Netithorn-P/Li-ion-Battery-cells-management-system/thesis final.pdf

การพัฒนาระบบปรับสมดุลของเซลล์แบบแอคทีฟเพื่อเพิ่มประสิทธิภาพการจัดการ แบตเตอรี่แพคชนิดลิเทียมไอออน An Improvement of Active Cell Balancing for Efficient Management in Li-ion Battery Pack

เนติธร ปรีชาพัฒนานนท์

ปริญญานิพนธ์นี้เป็นส่วนหนึ่งของการศึกษาตามหลักสูตร ปริญญาวิศวกรรมศาสตรบัณฑิต สาขาวิศวกรรมไฟฟ้า คณะวิศวกรรมศาสตร์
สถาบันเทคโนโลยี ไทย-ญี่ปุ่น พ.ศ. 2564

หัวข้อปริญญานิพนธ์ | การพัฒนาระบบปรับสมดุลของเซลล์แบบแอคทีฟเพื่อเพิ่ม
| ประสิทธิภาพการจัดการแบตเตอรี่แพคชนิดลิเทียมไอออน
โดย | นายเนติธร ปรีชาพัฒนานนท์
สาขาวิชา | วิศวกรรมไฟฟ้า
อาจารย์ที่ปรึกษาปริญญานิพนธ์ | ดร.ไพศาล สุดวิลัย

คณะกรรมการสอบ

| อาจารย์ที่ปรึกษา ประธานกรรมการสอบ
(ดร.ไพศาล สุดวิลัย)
| กรรมการสอบ
(รศ.ดร.ไตรสิทธิ์ เบญจบุณยสิทธิ์)
| กรรมการสอบ
(ผศ.ดร.อาทิตย์ ธรรมตระการ)
| กรรมการสอบ
(ดร.ชาตรี บุษบาธร)

ลิขสิทธิ์ของสถาบันเทคโนโลยีไทย – ญี่ปุ่น

ก

ชื่อโครงงาน | การพัฒนาระบบปรับสมดุลของเซลล์แบบแอคทีฟเพื่อเพิ่มประสิทธิภาพการ
| จัดการแบตเตอรี่แพคชนิดลิเทียมไอออน
ผู้เขียน | นายเนติธร ปรีชาพัฒนานนท์
อาจารย์ที่ปรึกษา | ดร.ไพศาล สุดวิลัย
หลักสูตร | วิศวกรรมศาสตร์บัณฑิต
สาขาวิชา | วิศวกรรมไฟฟ้า
พ.ศ. | 2564

บทสรุป

ธรรมชาติของเซลล์แบตเตอรี่ชนิดลิเทียมไอออนมีการคายประจุเองตลอดเวลาและในแต่ละเซลล์ นั้นก็มีความสามารถในการคายประจุไม่เท่ากันส่งผลให้เมื่อนำเซลล์แบตเตอรี่ชนิดลิเทียมไอออนมากกว่า หนึ่งเซลล์มาใช้งานร่วมกันอาจไม่มาสารถใช้งานได้เต็มประสิทธิภาพเนื่องจากประจุในแต่ละเซลล์ไม่เท่ากัน ดังนั้นการปรับสมดุลเซลล์แบตเตอรี่ให้เท่ากันก่อนนำไปใช้งานหรืออัดประจุจึงเป็นการเพิ่มประสิทธิภาพ การใช้งานของแบตเตอรี่
ปริญญานิพนธ์นี้จึงได้นำเสนอวิธีการปรับสมดุลเซลล์แบตเตอรี่ชนิดลิเทียมไอออนที่มีการต่อแบบ ขนาน 4 เซลล์ด้วยวิธีการเพิ่มแรงดันในการปรับสมดุลด้วยวงจรเพิ่มแรงดันที่มีข้อได้เปรียบเรื่องระยะเวลา ในการปรับสมดุลเซลล์แบตเตอรี่ที่มีความต่างของแรงดันน้อย โดยมีเงื่อนไขในการปรับสมดุลคือแรงดัน ของเซลล์ที่มีแรงดันมากที่สุดกับน้อยที่สุดต้องมีต่างกันไม่เกิน 10 mV พร้อมยังนำเสนอการป้องกันเซลล์ แบตเตอรี่ขณะปรับสมดุลจากสถานะผิดปกติของแบตเตอรี่ไม่ว่าจะเป็น แรงดันสูงเกิน แรงดันต่ำเกิน กระแสเกิน และ อุณหภูมิเกิน โดยการทำงานทั้งหมดนั้นได้รวมอยู่ในอุปกรณ์จัดการแบตเตอรี่ โดยได้ นำเสนอไมโครคอนโทรเลอร์รุ่น Arduino Mega 2560 ในการทำหน้าที่ควบคุมและประมวลผลการทำงาน ทั้งหมดของระบบ

คำสำคัญ : การปรับสมดุล/เพิ่มแรงดัน/แรงดันสูงเกิน/แรงดันต่ำเกิน/กระแสเกิน/อุณหภูมิเกิน

ข

Project’s name | An Improvement of Active Cell Balancing for Efficient
| Management in Li-ion Battery Pack
Authors | Netithorn Preechapattananont
Faculty Advisor | Dr.Phaisarn Sudwilai
Program | Bachelor of Engineering
Major | Electrical Engineering
Academic year | 2021

Abstract

Li-ion battery is naturally self-discharged which its capability is distinguish from one to another. This eventually affects to the usage of multiple cells together may not reach its best efficiency due to the inequality of each charge. Therefore, balancing battery cell prior to the usage or charging is considered as way to improve its efficiency. This thesis aims to propose “Balancing Battery Cells Methodology” for Li-ion that connected parallelly with 4 cells with increasing voltage for balancing by boost converter. The advantage of the boost converter is shorter period for balancing battery cells that consist of small different of voltage volume. And the balancing condition is the highest and lowest cell’s voltages are not varied more than 10 mV. In addition, this thesis also proposes prevention way while balancing process is in progress from various unusual status including too much high voltage, too low voltage, over current, and over temperature. The overall working model, system, and process are included in this battery management system with the proposal of micro controller - Arduino Mega 2560 model for the whole system processing and controlling.

Keywords : balancing/increasing voltage/over voltage/under voltage/over current/
over temperature

ค

กิตติกรรมประกาศ

ปริญญานิพนธ์ฉบับนี้ได้สำเร็จลุล่วงไปด้วยดีแม้จะมีปัญหาบ้างแต่ด้วยการที่ได้คำแนะนำและได้ ความช่วยเหลือจาก ดร.ไพศาล สุดวิลัย อาจารย์ที่ปรึกษาโครงงานของข้าพเจ้า ที่สละเวลาให้คำปรึกษา และความช่วยเหลือตลอดการดำเนินงานทำโครงงาน จนเป็นผลให้โครงงานสำเร็จลุล่วงไปได้ด้วยดี ขอขอบพระคุณอาจารย์คณะวิศวกรรมศาสตร์สาขาวิศวกรรมไฟฟ้าทุกท่านไม่ว่าจะเป็น ดร.ชาตรี บุษบาธร ผศ.ดร.อาทิตย์ ธรรมตระการ รศ.ดร.ไตรสิทธิ์ เบญจบุณยสิทธิ์อาจารย์ศิริพงษ์ แสงสารพันธ์ อาจารย์จิรดา โกสุมบงกช และ รศ.ดร.ชุมพล อันตรเสน ที่ให้ความรู้และคำแนะนำต่างๆแก่ข้าพเจ้า และ คอยสนับสนุนช่วยเหลือตลอดทั้งโครงงาน รวมไปถึงคณาจารย์จากคณะวิศวกรรมศาสตร์และ คณะอื่นๆ ที่ เคยอบรมสั่งสอนได้ให้ความรู้และอบรมสั่งสอนข้าพเจ้า ขอขอบคุณสถาบันเทคโนโลยีไทย-ญี่ปุ่น ที่อำนวย ความสะดวกในเรื่องสถานที่ อุปกรณ์ และ งบประมาณต่างๆในการจัดทำโครงงานให้แก้ข้าพเจ้า ท้ายที่สุดขอขอบพระคุณพ่อแม่และครอบครัวที่คอยสนับสนุนด้านการศึกษาให้แก่ข้าพเจ้า รวมทั้ง กำลังใจและความเชื่อมั่นในตัวข้าพเจ้า และเพื่อนๆ รวมถึงรุ่นพี่ที่คอยให้คำแนะนำและคำปรึกษาแก่ ข้าพเจ้าตลอดการศึกษาในระดับปริญญาศึกษา

เนติธร ปรีชาพัฒนานนท์
ผู้จัดทำ

ง

สารบัญ

หน้า

บทสรุป | ก
Summary | ข
กิตติกรรมประกาศ | ค
สารบัญ | ง
สารบัญตาราง | ช
สารบัญรูป | ซ
บทที่ 1 บทนำ | 1
1.1 ที่มาและความสำคัญของปัญหา | 1
1.2 วัตถุประสงค์ของโครงงาน | 2
1.3 ขอบเขตการศึกษา | 2
1.4 ประโยชน์ที่คาดว่าจะได้รับ | 2
1.5 แผนการดำเนินการ | 3
บทที่ 2 ทฤษฎีที่เกี่ยวข้อง | 4
2.1 ประเภทของแบตเตอรี่ | 4
2.2 แบตเตอรี่ชนิดลิเทียมไอออน | 6
2.3 แบบจำลองสมมูลแบตเตอรี่ชนิดลิเทียมไอออน | 8
2.3.1 แบบจำลองเทวินิน (Thevenin Model) | 8
2.3.2 แบบจำลองเทวินินแบบปรับปรุง (Improved Thevenin Model) | 9
2.4 วิธีการปรับสมดุลเซลล์แบตเตอรี่ | 10
2.4.1 การปรับสมดุลแบบพาสซีฟ (Passive balancing) | 10
2.4.2 การปรับสมดุลแบบแอคทีฟ (Active balancing) | 11
2.4.3 การปรับสมดุลแบบ Lossless balancing | 14

จ

2.4.4 การปรับสมดุลแบบ Redox Shuttle | 15
2.5 หลักการอัดประจุแบตเตอรี่ | 15
2.6 Stage of Charge , Depth of Discharge และ C-rate | 16
2.6.1 Stage of Charge (SoC) | 16
2.6.2 Depth of Discharge (DoD) | 17
2.6.3 C-rate | 18
บทที่ 3 ขั้นตอนและวิธีการดำเนินงาน | 19
3.1 ทำการเก็บผลเพื่อออกแบบ | 19
3.2 ออกแบบวงจรจัดการแบตเตอรี่แพค | 22
3.2.1 สถาปัตยกรรมของระบบขัดการแบตเตอรี่แพค | 22
3.2.2 การทำงานของระบบจัดการแบตเตอรี่ชนิดลิเทียมไอออน | 23
3.3 ออกแบบหลักการทำงานของระบบปรับสมดุลของระบบจัดการแบตเตอรี่ | 29
3.4 การตรวจวัดสัญญาณ | 33
3.4.1 การตรวจวัดสัญญาณแรงดันไฟฟ้า | 33
3.4.2 การตรวจวัดสัญญาณกระแสไฟฟ้า | 33
3.4.3 การตรวจวัดสัญญาณอุณหภูมิ | 34
3.5 ออกแบบวงจรป้องกันแบตเตอรี่แพ็ค | 35
บทที่ 4 ขั้นตอนและวิธีการดำเนินงาน | 36
4.1 การทดสอบปรับสมดุลโดยการเพิ่มแรงดันในการรับสมดุล | 36
4.1.1 เงื่อนไขการปรับสมดุลด้วยแรงดันปรับสมดุล 4.20 Volt | 36
4.1.2 เงื่อนไขการปรับสมดุลด้วยแรงดันปรับสมดุล 4.25 Volt | 37
4.1.3 เงื่อนไขการปรับสมดุลด้วยแรงดันปรับสมดุล 4.38 Volt | 38
4.2 การทดสอบปรับสมดุลเซลล์แบตเตอรี่ที่มีแรงดันต่างกันมาก | 39
4.3 การทดสอบระบบควบคุมการทำงานของระบบจัดการแบตเตอรี่ | 41

ฉ

4.4 การทดสอบระบบป้องกันเซลล์แบตเตอรี่ | 44
4.5 การทดสอบการดำเนินการทำงานของระบบ | 48
4.6 ผลการทดสอบการดำเนินการปรับปรุงระบบปรับสมดุล | 49
บทที่ 5 บทสรุปและข้อเสนอแนะ | 50
5.1 สรุปผลการดำเนินงาน | 50
5.2 แนวทางการแก้ไขปัญหา | 50
5.3 ข้อเสนอแนะจากการดำเนินงาน | 51
เอกสารอ้างอิง | 52
ภาคผนวก ก | 54
ภาคผนวก ข | 55
ภาคผนวก ค | 58
ภาคผนวก ง | 60
ภาคผนวก จ | 62
ภาคผนวก ฉ | 68
ภาคผนวก ช | 71
ภาคผนวก ญ | 72
ประวัติผู้จัดทำโครงงาน | 74

ช

สารบัญตาราง

ตารางที่ | หน้า

ตารางที่ 2.1 ตารางแสดงถึงความสัมพันธ์ระหว่าง C-rate ความจุและ ระยะเวลา ของแบตเตอรี่ 18
ตารางที 4.1 ตารางแรงดันก่อนปรับสมดุลและหลังปรับสมดุลด้วยแรงดัน 4.20 Volt | 35
ตารางที 4.2 ตารางแรงดันก่อนปรับสมดุลและหลังปรับสมดุลด้วยแรงดัน 4.25 Volt | 36
ตารางที 4.3 ตารางแรงดันก่อนปรับสมดุลและหลังปรับสมดุลด้วยแรงดัน 4.38 Volt | 37
ตารางที 4.4 ตารางแรงดันก่อนปรับสมดุลและหลังปรับสมดุลเซลล์แบตเตอรี่ที่มี | 39
แรงดันต่างกันมากด้วยแรงดัน 4.25 Volt ตารางที่ 4.5 การเปรียบเทียบวิธีการปรับสมดุลระหว่าง Flying capacitor และ Buck-Boost 49 converter

ซ

สารบัญรูป

ภาพที่ | | หน้า
2.1 | แบบจำลองเทวินินของแบตเตอรี่ชนิดลิเทียมไอออน | 8
2.2 | การปรับปรุงแบบจำลองเทวินินของแบตเตอรี่ชนิดลิเทียมไอออน | 9
2.3 | Fixed shunting resistor | 10
2.4 | Switching shunting resistor | 11
2.5 | Switching capacitor | 12
2.6 | Buck-Boost converter method | 13
2.7 | Multi-winding transformer | 14
2.8 | Metrix switch circuit | 14
2.9 | โหมดการชาร์จกระแสคงที่ และ แรงดันคงที่ | 16
2.10 ภาพอธิบายความหายของ SOC เมื่ออ้างอิงกับความจุของแบตเตอรี่ | 16
2.11 ภาพอธิบายความหมายของ DOD โดยเทียบระหว่างแรงดันและเวลา | 17
2.12 ภาพอธิบายความหมายของ SOC และ DOD เมื่ออ้างอิงกับความจุของแบตเตอรี่ | 18
3.1 | กราฟแสดงแรงดันของเซลล์แบตเตอรี่ชนิดลิเทียมไอออนด้วยระบบปรับสมดุลแบบ Flying
| Capacitor | 20
3.2 | กราฟแสดงแรงดันของเซลล์แบตเตอรี่ชนิดลิเทียมไอออนด้วยระบบปรับสมดุลแบบ Buck-Boost
| converter | 21
3.3 | สถาปัตยกรรมการจัดการแบตเตอรี่ชนิดลิเทียมไอออนที่ต่อขนานจำนวน 4 เซลล์ | 23
3.4 | แผนภาพการเริ่มต้นการทำงานของระบบจัดการแบตเตอรี่ | 23
3.5 | แผนภาพการเริ่มต้นการทำงานของระบบจัดการแบตเตอรี่ | 23
3.6 | แผนภาพการตรวจเช็คสถานะคำสั่งหลักและเข้าสู่คำสั่งของระบบจัดการแบตเตอรี่ | 24
3.7 | แผนภาพหน้าหลักของระบบจัดการแบตเตอรี่ | 24
3.8 | แผนภาพการทำงานเบื้องหลังในการ delay ของระบบจัดการแบตเตอรี่ | 25
3.9 | แผนภาพการทำงานการัดจังหวะของสวิตช์1 และ 2 ของระบบจัดการแบตเตอรี่ | 26
3.10 แผนภาพการทำงานการขัดจังหวะของสวิตช์3 และ 4 ของระบบจัดการแบตเตอรี่ | 27
3.11 โมดูลแปลงแรงดันไฟฟ้าที่ใช้Regulator เบอร์ LN2587 | 28

ฌ

สารบัญรูป (ต่อ)

รูปที่ | | หน้า
3.12 พฤติกรรมของพลังงานที่สูญเสียในเซลล์แบตเตอรี่ขณะถ่ายโอนพลังงานในรูปแบบต่างๆ | 28
3.13 แผนภาพการทำงานของการคำนวณและจับคู่เซลล์ที่จะทำการปรับสมดุล | 29
3.14 แผนภาพการทำงานของการปรับสมดุลเซลล์แบตเตอรี่ | 30
3.15 แผนภาพการทำงานของการปรับสมดุลเซลล์แบตเตอรี่ (ต่อ) | 31
3.16 การต่อวงจรเพื่อวัดแรงดันของเซลล์แบตเตอรี่โดยมีการต่อ
| pull-down resistor ขนาด 10 kΩ | 32
3.17 การต่อวงจรเพื่อวัดสัญญาณกระแสไฟฟ้าและเปลี่ยนเป็นสัญญาณแรงดันโดยใช้ไอซีเบอร์
| ACS712 | 33
3.18 ไอซีวัดแรงดันเบอร์ LM35 | 33
3.19 Datasheet บอกคุณสมบัติเบื่องต้นของแบตเตอรี่รุ่น Toriyama ICR18650-22 | 34
4.1 | ปรับสมดุลเป็นเวลา 4 ชั่วโมงด้วยแรงดันขนาด 4.20 Volt | 35
4.2 | ปรับสมดุลเป็นเวลา 4 ชั่วโมงด้วยแรงดันขนาด 4.25 Volt | 36
4.3 | ปรับสมดุลเป็นเวลา 4 ชั่วโมงด้วยแรงดันขนาด 4.38 Volt | 37
4.4 | ปรับสมดุลเซลล์แบตเตอรี่ที่มีแรงดันต่างกันมากด้วยแรงดันด้วยแรงดันขนาด 4.25 Volt | 38
4.5 | แผนภาพหน้าการดำเนินการทำงานของระบบจัดการแบตเตอรี่ | 40
4.6 | หน้าจอ LCD การดำเนินการทำงานของระบบจัดการแบตเตอรี่ | 40
4.7 | แผนภาพหน้าการแสดงสถานะต่างๆของเซลล์แบตเตอรี่และของระบบจัดการแบตเตอรี่ | 41
4.8 | หน้าจอ LCD การแสดงสถานะต่างๆของเซลล์แบตเตอรี่และของระบบจัดการแบตเตอรี่ | 41
4.9 | แผนภาพหน้าการปรับแต่งคุณสมบัติต่างๆของระบบจัดการแบตเตอรี่ | 42
4.10 หน้าจอ LCD การปรับแต่งคุณสมบัติต่างๆของระบบจัดการแบตเตอรี่ | 42
4.11 แผนภาพหน้าการวัดค่าแรงดันและประมวลผลสำหรับป้องกันเซลล์ของระบบ
| จัดการแบตเตอรี่ | 43
4.12 แผนภาพหน้าการวัดค่ากระแสและประมวลผลสำหรับป้องกันเซลล์ของระบบ
| จัดการแบตเตอรี่ | 44
4.13 แผนภาพหน้าการวัดค่าอุณหภูมิและประมวลผลสำหรับป้องกันเซลล์ของระบบ
| จัดการแบตเตอรี่ | 44

ฌ

4.14 แผนภาพการแสดงผลเมื่อสามารถตรวจจับความผิดปกติของเซลล์แบตเตอรี่ของระบบ
| จัดการแบตเตอรี่ | 45
4.15 หน้าจอ LCD การแสดงผลเมื่อสามารถตรวจจับสถานะ Over Current ในระบบเมื่อมีการทำการ
| Balance และ Discharge | 45
4.16 หน้าจอ LCD การแสดงผลเมื่อสามารถตรวจจับสถานะ Over Voltage ในระบบที่เซลล์ 1,2,3,4
| และ 1,3 | 46
4.17 หน้าจอ LCD การแสดงผลเมื่อสามารถตรวจจับสถานะ Under Voltage ในระบบที่เซลล์ 1,2,3,4
| และ 2,4 | 46
4.18 หน้าจอ LCD การแสดงผลเมื่อสามารถตรวจจับสถานะ Over Temperature ในระบบที่เซลล์
| 1,2,3,4 และ 1,2 | 46
4.19 หน้าจอ LCD การแสดงผลเมื่อระบบดำเนินการ Discharge และพบเซลล์ที่มีแรงดัน 0 Volt 46 4.20 หน้าจอ LCD การแสดงผลเมื่อระบบดำเนินการ Balance และพบเซลล์ที่มีแรงดัน 0 Volt 47
4.21 หน้าจอ LCD การแสดงผลเมื่อระบบดำเนินการ Discharge | 47
4.22 หน้าจอ LCD การแสดงผลเมื่อระบบดำเนินการ Balance | 47
ก.1 | รูปลักษณ์ภายนอกของระบบจัดการแบตเตอรี่ในส่วนของการทำงานเบื้องหลัง | 52
ก.2 | รูปลักษณ์ภายนอกของระบบจัดการแบตเตอรี่ในส่วนของการทำงานเบื้องหน้า | 52

บทที่1
บทนำ

### 1.1 ที่มาและความสำคัญของปัญหา

จากจุดเริ่มต้นมนุษย์ได้พัฒนาเทคโนโลยีเสมอมาเพื่อใช้ในการอำนวยความสะดวกโดยมีเป้าหมาย เพื่อตนเองเป็นหลัก โดยในยุคปฏิวัติอุตสาหกรรมที่เมื่อก่อนการผลิตสินค้าเดิมใช้แรงงานคน แรงงานสัตว์ รวมทั้งพลังงานจากธรรมชาติ ได้ปรับเปลี่ยนมาใช้เครื่องจักรกลแทน เพื่อทุ่นแรงและเพิ่มความสามารถใน การผลิต โดยในเริ่มแรกจะใช้พลังงานจากการใช้น้ำมาหมุนกังหันและได้พัฒนาต่อมาเป็นเครื่องยนต์ที่ใช้ แหล่งพลังงานชนิดต่างๆ ไม่ว่าจะเป็นถ่านหินไปจนถึงน้ำมันปิโตรเลียม จนการใช้เครื่องยนต์เป็นต้นกำลัง นั้นเริ่มแพร่หลายมากขึ้น จึงทำให้อุปกรณ์ต่างๆที่ถูกพัฒนาในเวลานั้นมีต้นกำลังมาจากเครื่องยนต์รวมไป ถึงยานพหนะ
ณ ปัจจุบันมนุษย์นั้นเริ่มตระหนักถึงสิ่งแวดล้อมมากขึ้นเรื่อยๆจึงได้พัฒนายานพหนะที่ใช้ต้นกำลัง มาจากไฟฟ้า และ เนื่องจากยานพหนะนั้นถูกสร้างขึ้นมาเพื่อใช้ประโยชน์ในการเดินทางระยะใกลทำให้ไม่ สามารถที่จะใช้แหล่งพลังงานผ่านทางสายไฟได้จึงมีการพัฒนาวิธีการจัดเก็บพลังงานไฟฟ้าไว้ในแบตเตอรี่ และออกแบบระบบจัดเก็บพลังงานให้เหมาสมกับพฤติกรรมการใช้งานและสภาพแวดล้อมของระบบ อย่างเช่นในรถยนต์จากข้อได้เปรียบของรถยนต์ประเภทเครื่องยนต์สันดาปภายในที่ใช้แหล่งพลังงานมา จากผลิตภัณฑ์ปิโตรเลียมคือ การเติมเชื่อเพลิงที่รวดเร็ว จึงนำมาสู่การปรับปรุงระบบแหล่งเก็บพลังงาน ของรถยนต์พลังงานไฟฟ้าที่ต้องการการเติมพลังงานที่รวดเร็วไกล้เคียงกับรถยนต์สันดาปภายในมากขึ้นจึง ได้พัฒนาวิธีการในการอัดประจุแบตเตอร์รี่แบบต่างๆเพื่อเพิ่มความเร็วในการอัดประจุให้มากขึ้นเพื่อลดข้อ เสียเปรียบในด้านนี้ให้น้อยลงจนหมดไป

### 1.2 วัตถุประสงค์ของโครงงาน

1.2.1 เพื่อศึกษาถึงคุณสมบัติและข้อจำกัดรวมไปถึงการทำงานของแบตเตอรี่ชนิดลิเทียม ไอออน

1.2.2 เพื่อศึกษาวิธีการที่จะใช้งานแบตเตอรี่ชนิดลิเธียมไอออนได้อย่างมีประสิทธิภาพ
1.2.3 เพื่อศึกษาและออกแบบระบบจัดการและปรับสมดุลให้กับแบตเตอรี่ชนิดลิเทียมไอออน 1.2.4 เพื่อศึกษาปัญหาและแก้ไขปัญหาที่เกิดขึ้นกับแบตเตอรี่ชนิดลิเทียมไอออนขณะปรับ สมดุลเพื่อพัฒนาขีดความสามารถของระบบจัดการแบตเตอรี่

### 1.3 ขอบเขตการศึกษา

1.3.1 ออกแบบอุปกรณ์และประดิษฐ์ระบบจัดการและปรับสมดุลแบตเตอรี่ชนิดลิเทียมไอออน แบบ Active
1.3.2 ออกแบบ Algorithm ในการปรับสมดุแบบ Activeระหว่างเซลล์แบตเตอรี่ที่ต่อขนาน 4 เซลล์ของจัดการแบตเตอรี่ชนิดลิเทียมไอออน

### 1.4 ประโยชน์ที่คาดว่าจะได้รับ

1.4.1 ทักษะในการออกแบบและวิเคราะห์วงจรที่ซับซ้อนมากขึ้น
1.4.2 ทักษะในการออกแบบ Algorithm ในการควบคุมการทำงานของระบบผ่าน Microcontroller
1.4.3 ได้นำความรู้ที่เคยศึกษามาและความรู้ที่ได้ศึกษาเพิ่มเติมมาประยุกต์ใช้ในการออกแบบ อุปกรณ์ที่สามารถใช้งานได้จริง

### 1.5 แผนการดำเนินการ

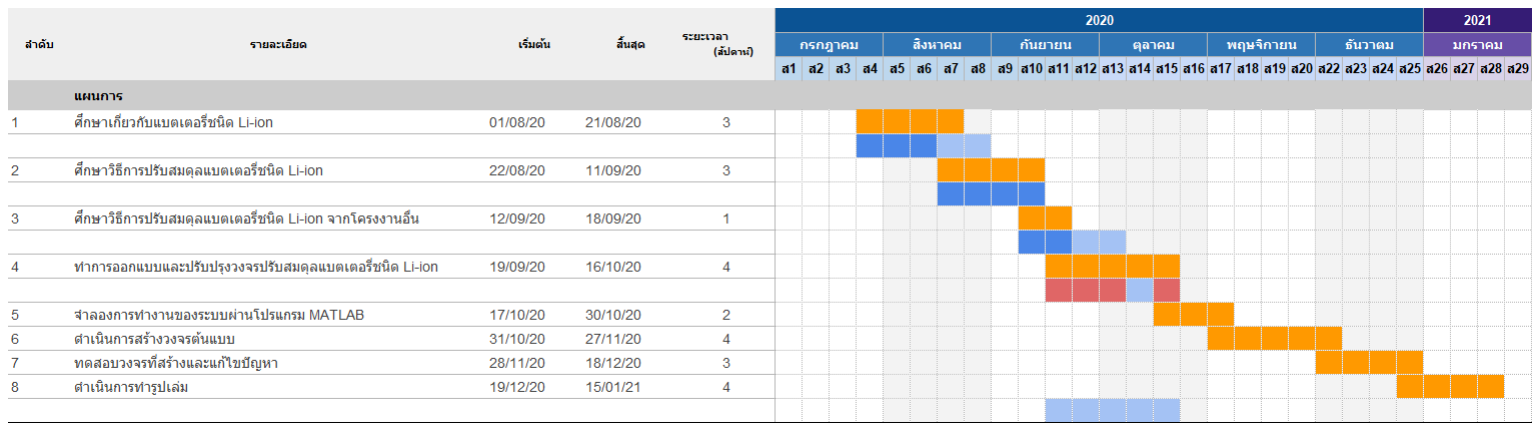
[picture p1: figure]

บทที่2
ทฤษฏีที่เกี่ยวข้อง

### 2.1 ประเภทของแบตเตอรี่ [1] [2]

แบตเตอรี่หรือถ่านนั้นเป็นอุปกรณที่ใช้ในการเก็บพลังงานไฟฟ้าในรูปแบบของปฏิกริยาทางเคมี โดยสามารถแบ่งออกได้เป็น 2 ประเภทใหญ่ๆ คือ เซลล์ปฐมภูมิ (Primary Cells) และ เซลล์ทุติยภูมิ (Secondary Cells) โดยมีข้อแตกต่างคือ เซลล์ปฐมภูมิ (Primary Cells) เป็นเซลล์แบตเตอรี่ที่ถูกสร้างมา จากวัสดุทางเคมีที่คุณสมบัติแบบ Non-reversable chemical reaction จึงไม่สามารถจ่ายแรงดันกลับ เพื่ออัดประจุคืนให้แบตเตอรี่มีโครงสร้างทางเคมีเหมือนเดิมได้แต่ใน เซลล์ทุติยภูมิ (Secondary Cells) จะเป็นเซลล์แบตเตอรี่ที่ถูกสร้างมาจากวัสดุทางเคมีที่คุณสมบัติแบบ Reversable chemical reaction จึงสามารถจ่ายแรงดันกลับเพื่ออัดประจุคืนให้แบตเตอรี่มีโครงสร้างทางเคมีเหมือนเดิมได้ซึ่งการใช้งาน ของแบตเตอรี่ทั้งสองชนิดนั้นแตกต่างกันเนื่องจากคุณสมบัตเฉพาะตัวแยกย่อยต่างๆของแบตเตอรี่ทั้งสอง ชนิด เช่น ถ่านอัลคาไลน์ ถ่านลิเธียม ที่เป็น แบตเตอรี่ชนิด Primary Cells นั้นมีหลายขนาดนิยมใช้ใน ใช้ ในวิทยุ นาฬิกา เก็บพลังงานได้สูง อายุการใช้งานสูง แต่เมื่อถูกใช้หมดจะกลายเป็นขยะมลพิษ ถ่านไฟฉาย แบบอัลคาไลน์ที่ใช้แล้วทิ้งนั้นเป็นที่นิยมกันมาก แต่ในระยะหลังนี้ถ่านไฟฉายอีกประเภทหนึ่งที่ได้รับความ นิยมเพิ่มมากขึ้นคือถ่านลิเธียม ซึ่งมีนํ้าหนักเบา ให้พลังงานสูง ใช้ได้ดีในที่อากาศเย็นและสามารถเก็บไว้ได้ นาน นอกจากนี้ ในปัจจุบันผู้ผลิตยังได้ผลิตถ่านลิเธียมในขนาด AA ออกมาอีกด้วย แต่ในอุปกรณ์ที่มีอัตรา ในการบริโภคพลังงานสูงขึ้นมาและมีอายุการใช้งานนานจะนิยมใช้เป็นแบตเตอรี่ชนิด Secondary Cells เนื่องจากความคุ้มค่าทางเศรษฐศาสตร์และความสะดวกสะบายโดยนิยมใช้เป็น แบตเตอรี่รถยนต์ แบตเตอรี่มือถือ เป็นต้น แบตเตอรี่ชนิด Secondary Cells ที่เก่าแก่ที่สุดซึ่งใช้อยู่จนกระทั่งปัจจุบันคือ "เซลล์เปียก"แบตเตอรี่ตะกั่ว-กรด (lead-acid battery) แบตเตอรี่ชนิดนี้จะบรรจุในภาชนะที่ไม่ได้ปิดผนึก (unsealed container) ซึ่งแบตเตอรี่จะต้องอยู่ในตำแหน่งตั้งตลอดเวลาและต้องเป็นพื้นที่ที่ระบายอากาศ ได้เป็นอย่างดีเพื่อระบายก๊าซไอโดรเจนที่เกิดจากปฏิกิริยาและแบตเตอรี่ชนิดจะมีนํ้าหนักมากรูปแบบ สามัญของแบตเตอรี่ตะกั่ว-กรด คือแบตเตอรี่รถยนต์ ซึ่งสามารถจะให้กระแสไฟฟ้าได้ถึงประมาณ 10,000 วัตต์ในช่วงเวลาสั้นๆ และมีกระแสตั้งแต่ 450 ถึง 1100 แอมแปร์สารละลายอิเล็กโตรไลต์ของแบตเตอรี่

คือ กรดซัลฟิวริกซึ่งสามารถเป็นอันตรายต่อผิวหนังและตาได้ แบตเตอรี่ตะกั่ว-กรดที่มีราคาแพงมาก เรียกว่า แบตเตอรี่เจล (หรือ "เจล-เซลล์") ภายในจะบรรจุอิเล็กโตรไลต์ประเภทเซมิ-โซลิด (semi-solid electrolyte) ที่ป้องกันการหกได้ดี และแบตเตอรี่ชนิด Secondary Cells ที่เคลื่อนย้ายได้สะดวกกว่าคือ ประเภท "เซลล์แห้ง" เช่น แบตเตอรี่ชนิดนิกเกิล-แคดเมียม (NiCd) แบตเตอรี่ชนิดโซเดียม-ซัลเฟอร์ (NaS) แบตเตอรี่ชนิดซิงค์-โบรมีน (ZnBr) และ แบตเตอรี่ชนิดวาเนเดียม-รีด็อก (Vanadium-Redox) เป็นต้น ใน อดีตที่ผ่านมาจนถึงปัจจุบันในรถยนต์ไฟฟ้านั้นได้ใช้แบตเตอรี่ประเภท Secondary Cells เป็นพลังงาน หลักมาโดยตลอดโดยชนิดของแบตเตอรี่ที่ใช้นั้นได้ปรับเปลี่ยนตามเทคโนโลยีของยุคสมัยนั้นและการใช้ งาน เช่น

- Lead-Acid Battery ที่นิยมใช้ในรถประเภท Fork-lift เนื่องจากมีน้ำหนักที่มากเหมาะแก่การถ่วง น้ำหนักตัวรถเพื่อสมดุลของตัวรถในขณะยกของ
- Sodium-Nickel Chloride or Zebra (Molten-salt Battery) ใช้ในรถ Modec commercial vehicle แต่ในปัจจุบันเลิกใช้ไปแล้วเนื่องจากความยุ่งยากในการใช้งานที่จะต้องทำการให้ความร้อนแก้ electrolyte ก่อนเพื่อให้เปลี่ยนสถานะของ electrolyte เป็นของเหลวเพื่อใช้งาน
- NiMH Battery (Nickel Metal Hydride) ใช้ในรถยนต์ส่วนบุคคลในช่วงแรกๆของรถยนต์ไฟฟ้า เนื่องด้วยความสามารถในการเก็บพลังงานที่สูงเมื่อเทียบกับน้ำหนักและประมาตร มีความปลอดภัยในการ ใช้งาน ในยุคสมัยนั้น แต่ในปัจจุบันมีความนิยมน้อยลงเนื่องการการพัฒนาของเทคโนโลยีทำให้เกิด แบตเตอรี่ชนิดใหม่ที่เหมาะสมในการใช้งานมากกว่า
- Li-ion Battery (Lithium ion) นิยมใช้ในรถยนต์ส่วนบุคคลในปัจจุบันเนื่องจากมีความเหมาะสม มากที่สุดในเวลานี้ทั้งในเรื่องของเศรษฐศาสตร์และคุณสมบัติเฉพาะตัวของแบตเตอรี่ที่มีอายุการใช้งานสูง ความสามารถในการเก็บพลังงานที่สูงเมื่อเทียบกับน้ำหนักและประมาตร มากกว่าแบตเตอรี่ชนิด Nickel Metal Hydride และได้ถูกพัฒนาให้มีความปลอดภัยในการใช้งานแล้ว

### 2.2 แบตเตอรี่ชนิดลิเทียมไอออน [2] [3] [4]

แบตเตอรี่ลิเธียมไอออน (Lithium-Ion Battery) หรือ Li-Ion battery เป็นแบตเตอรี่คุณภาพสูง ชนิดที่สามารถนำกลับมาใช้ใหม่ (Rechargeable Battery) หรือใช้ซ้ำได้ เริ่มใช้กันมาตั้งแต่ปี ค.ศ. 1970 (พ.ศ. 2513) จุดเริ่มต้นจากวิจัยในช่วงปี ค.ศ. 1970 ขณะนั้นเป็นแบตเตอรี่ชนิดใช้ครั้งเดียวแล้วทิ้ง ลิ เธียมมีคุณสมบัติที่เด่นคือ เป็นโลหะที่เบา ให้แรงดันไฟฟ้าสูง และยังมีความหนาแน่นของพลังงานสูงและ กำลังไฟฟ้าสูงในนํ้าหนักที่เท่ากันปัญหาของโลหะลิเธียม (Lithium Metal) ในระยะแรกคือ เรื่องของความ ปลอดภัยกล่าวคือ ในระหว่างอัดประจุไฟมีแนวโน้มที่จะเกิดความไม่เสถียรทำให้ระเบิดได้ง่ายงานวิจัยใน ระยะต่อมาจึงได้มีการทดลองเปลี่ยนจากการใช้ลิเธียมในรูปของโลหะมาเป็นรูปของไอออน (Lithium-ion) ซึ่งมีความปลอดภัยมากกว่า มากถึงแม้จะให้พลังงานที่น้อยกว่า โดยในปัจจุบันมีใช้กันอย่างแพร่หลายใน เครื่องใช้ไฟฟ้า ที่ไม่ต้องการต่อสายเพื่อจ่ายพลังงานอยู่ตลอดเวลา เช่น หุ่นยนต์ดูดฝุ่น หุ่นยนต์เช็ดกระจก หุ่นยนต์ตัดหญ้า หรือแม้แต่โทรศัพท์มือถือ แท็บเล็ต คอมพิวเตอร์โน๊ตบุ๊ค แบตเตอรี่สำรอง (Power Bank) และ ใช้เพื่อสำรองไฟกรณีไฟจากแหล่งจ่ายปกติไม่สามารถจ่ายไฟได้สำหรับคุณสมบัติหลักของ แบตเตอรี่ลิเธียมไอออน คือ แรงดันต่อเซลล์สูง และ ค่อนข้างคงที่ แม้แบตเตอรี่ใกล้หมด และ ยังมี ระยะเวลาการอัดประจุไฟจนเต็มความจุที่เร็วกว่าแบตเตอรี่แบบอื่นๆเนื่องจากความสามารถในการทน กระแสสูง และ มีอายุการใช้งานที่นาน อายุการใช้งานของแบตเตอรี่ลิเธียมไอออน ในระยะที่เต็ม ประสิทธิภาพ จะอยู่ระหว่าง 2-3 ปี ขึ้นอยู่กับพฤติกรรมและปริมาณการใช้งานของผู้ใช้รวมไปถึงการดูแล รักษา โดยการดูแลรักษานั้นควรคำนึงถึง การเก็บแบตเตอรี่ หรืออุปกรณ์ที่ใช้แบตเตอรี่ชนิดนี้ให้อยู่ภายใน อุณหภูมิ และความชื้นที่เหมาะสม หลีกเลี่ยงการอัดประจุไฟภายใต้อุณหภูมิที่สูง (เพราะจะยิ่งทำให้ แบตเตอรี่เสื่อมเร็วขึ้น) อย่าใช้งานจนแบตเตอรี่หมดเกลี้ยง (Depth Of Discharge = 0 %) หรือเหลือ น้อยมากๆ ควรหมั่นอัดประจุให้มีไฟเลี้ยงตัวแบตเตอรี่อยู่เสมอ หากไมจำเป็นไม่ควรอัดประจุด้วยกระแสที่ สูงมากเนื่องจากจะทำให้แบตเตอรี่เสื่อมสภาพเร็วขึ้นจากปรากฏการณ์Dendrite ที่จะเกิดขึ้นภายใน แบตเตอรี่ภายใต้การอัดประจุด้วยกระแสที่สูง แบตเตอรี่ชนิดลิเธียมไอออนมีการป้องกันที่สูงเพื่อให้เกิด ความปลอดภัยในการใช้งาน ซึ่งจะมีวงจรป้องกันประกอบอยู่ภายในแบตเตอรี่ ซึ่งมีวงจรตรวจจับแรงดัน และกระแสโดยใช้ Metal Oxide Semiconductor Field Effect Transistor (MOSFET) กำลังสูงแต่มี ขนาดเล็กทำหน้าที่เป็นสวิตช์ทำหน้าที่ตัดวงจรออกเมื่อแรงดันของแบตเตอรี่สูงเกินประมาณ 4.25V

และทำหน้าที่ป้องกันไม่ให้แรงดันของแบตเตอรี่ตํ่าเกินประมาณ 3.00 V วงจรควบคุมจะตัดวงจรออกทำให้ แบตเตอรี่ไม่สามารถจ่ายกระแสได้อีก โดย

จุดเด่นของแบตเตอรี่ชนิดนี้คือ

- แรงดันต่อเซลล์สูง ประมาณ 3.6 V
- Self-Discharge rate ต่ำ น้อยกว่า 10% ต่อเดือน
- อายุการใช้งานยาวนานเมื่อเทียบกับแบตเตอรี่ชนิดอื่น
- สามารถจ่ายกระแสได้สูง ประมาณ 10C
- สามารถอัดประจุคืนได้เร็วเฉลี่ยประมาณ 1-2 ชั่วโมง
- Energy Density สูง ประมาณ 110 W • h/kg
- ไม่ต้องการการบำรุงรักษา
- ความเป็นพิษน้อย

จุดด้อยของแบตเตอรี่ชนิดนี้คือ

- ราคาค่อนข้างสูงเมื่อเทียบกับแบตเตอรี่ชนิดอื่น
- ความสามารถในการ Overcharge ต่ำมากจนถึงไม่สามาร Overcharge ได้
- มีการเสื่อมอายุตามการเวลาแม่ไม่ได้ใช้งานโดยเฉพาะการไม่เหลือประจุคงค้างไว้ในแบตเตอรี่
- ต้องการการทำงารในอุณหภูมิที่เหมาะสม

### 2.3 แบบจำลองสมมูลของแบตเตอรี่ชนิดลิเธียมไอออน

แบบจำลองวงจรสมมูลของแบตเตอรี่ชนิดลิเธียมไอออน (Equivalent Circuit Model) สามารถ แบ่งได้ 5 รูปแบบคือ The Rint Model , The RC Model , The Thevenin Model , The PNGV Model และ The DP Model แต่ส่วนมากนั้นในการวิเคราะห์วงจรของแบตเตอรี่ชนิดลิเธียมไอออนนั้น นิยมใช้The Thevenin Model และ The DP Model เป็นหลักโดย

2.3.1 แบบจำลองเทวินิน (Thevenin Model) [5] แบบจำลองวงจรสมมูลเทวินินเป็นแบบจำลองพื้นฐานดังแสดงในภาพที่ 2.1 ที่นิยมใช้กัน ทั่วไป ดังแสดงในภาพ ประกอบด้วยแหล่งจ่ายแรงดันกระแสตรง Voc (SOC) เป็นแรงดันขณะเปิด วงจรที่มีความสัมพันธ์กับค่าสถานะประจุของแบตเตอรี่ที่เปลี่ยนไปตัวต้านทาน Ri

เป็นตัว
ต้านทานภายในขึ้นอยู่กับเงื่อนไขการดิสชาร์จอัดประจุตัวต้านทาน R1 และตัวเก็บประจุ C1 ที่ต่อ ขนานกันใช้ในการอธิบายผลตอบสนองชั่วครู่ของผลตอบสนองแรงดันในระหว่างการอัดประจุและ ดิสชาร์จแรงดันขั้วของแบตเตอรี่ Vt และกระแสของแบตเตอรี่ที่จ่ายออกไป I

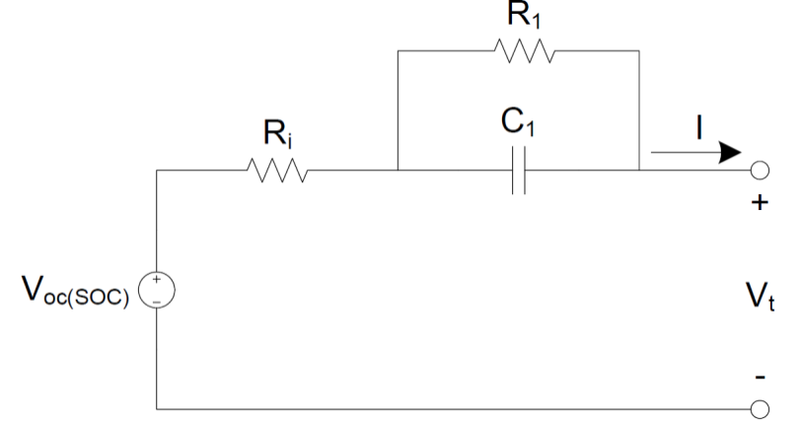
[picture p2: figure]

ภาพที่ 2.1 แบบจำลองเทเวนินของแบตเตอรี่ชนิดลิเทียมไอออน

2.3.2 แบบจำลองเทวินินแบบปรับปรุง (Improved Thevenin Model) [6] เป็นการนำเอาแบบจำลองเทวนินมาปรับปรุงโดยเพิ่มตัวต้านทาน R2 และตัวเก็บประจุ C2 ที่ต่อขนานกันลงไปในแบบจำลองเทวินิน ดังแสดงในภาพที่ 2.2 โดยแบบจำลองนี่เหมาะกับ แบตเตอรี่ที่มีการเปลี่ยนแปลงของกระแสโหลดแบบเป็นระดับตัวต้านทาน R1 และตัวเก็บประจุ C1 ที่ต่อขนานกันใช้ในการอธิบายผลตอบสนองแรงดันที่มีค่าคงที่เวลาสั้นสำหรับตัวต้านทาน R2 และตัวเก็บประจุ C2 ที่ต่อขนานกันใช้ในการอธิบายผลตอบสนองแรงดันที่มีค่าคงที่เวลายาวข้อดี ของการการปรับปรุงแบบจำลองเทวินินคือเพิ่มความแม่นยำมากยิ่งขึ้น แต่ในทางเดียวกันข้อเสีย ของการการปรับปรุงแบบจำลองเทวินินคือเพิ่มความซับซ้อนในการคำนวณ (อนุพันธ์อันดับสอง) มากขึ้นด้วยเช่นกัน

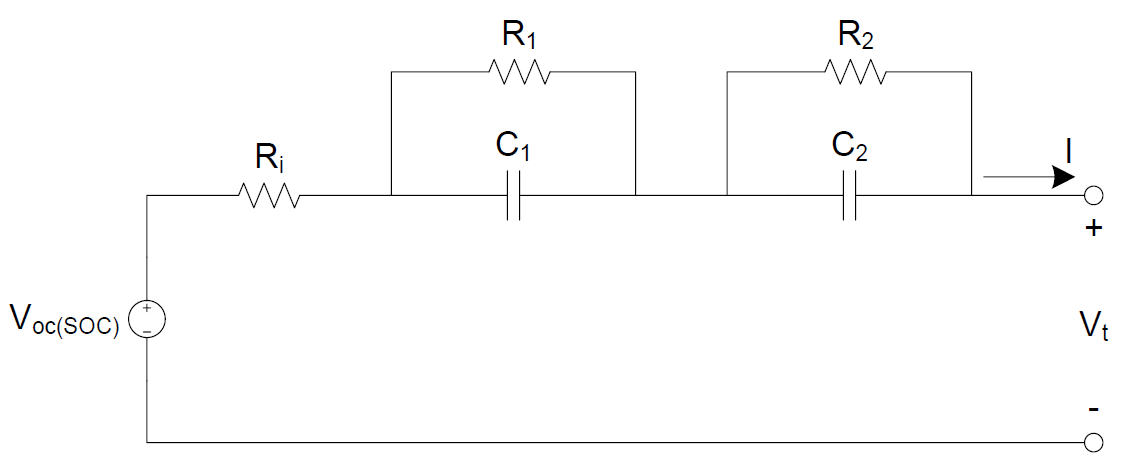
[picture p3: figure]

ภาพที่ 2.2 การปรับปรุงแบบจำลองเทเวนินของแบตเตอรี่ชนิดลิเทียมไอออน

### 2.4 วิธีการปรับสมดุลเซลล์แบตเตอรี่ [7] [8]

จากปัญหาที่ในแต่ละเซลล์นั้นมีความสามารถในการอัดประจุและคายประจุแตกต่างกันเนื่องจาก เงื่อนไขสภาวะที่แตกต่างของแต่ละเซลล์ถึงแม่จะเป็นชนิดเดียวกันก็ตามทำให้แบตเตอรี่ที่ต่ออนุกรม ในขณะอัดประจุจะเกิดปัญหาการเหลื่อมกันของแรงดันในแต่ละเซลล์จึงจำเป็นที่จะต้องใช้วิธีการที่จะปรับ สมดุลแรงดันในแต่ละเซลล์ให้เท่ากันโดยในปัจจุบันสามารถแบ่งวิธีการปรับสมดุลได้4 แบบใหญ่ๆ คือ 2.4.1 การปรับสมดุลแบบพาสซีฟ (Passive balancing) ในการปรับสมดุลเซลล์แบตเตอรี่แบบนี้จะใช้หลักการบายพาสกระแสของเซลล์ที่มี แรงดันถึงค่าที่สูงสุดที่ตั้งไว้ไปทิ้งที่ตัวต้านทานในขณะที่กำลังอัดประจุให้กับเซลล์ในระบบเพื่อให้ สามารถอัดประจุให้กับเซลล์ที่มีแรงดันต่ำกว่าได้ต่อโดยที่ไม่เกิดความเสียหายกับเซลล์ที่มีแรงดัน สูงกว่าเนื่องจากการโอเวอร์อัดประจุ โดยการปรับสมดุลแบบพาสซีฟนี้สามารถแบ่งแยก รายละเอียดของวิธีการย่อยได้อีก 2 วิธีคือ
วิธีที่ 1 Fixed Shunting resistor - คือการบายพาสกระแสของทุกตัวทิ้งยังต้านทาน ตลอดเวลาเพื่อปรับแรงดันให้มีระดับเดียวกันดังแสดงในภาพที่ 2.3 โดยนําตัวต้านทานมาต่อ คร่อมในแต่ละเซลล์แบตเตอรี่วิธีนี้เหมาะสําหรับแบตเตอรี่กรดตะกั่วและนิกเกิลเนื่องจาก สามารถอัดประจุได้มากเกินกว่า ความจุโดยเซลล์ไม่เกิดความเสียหาย

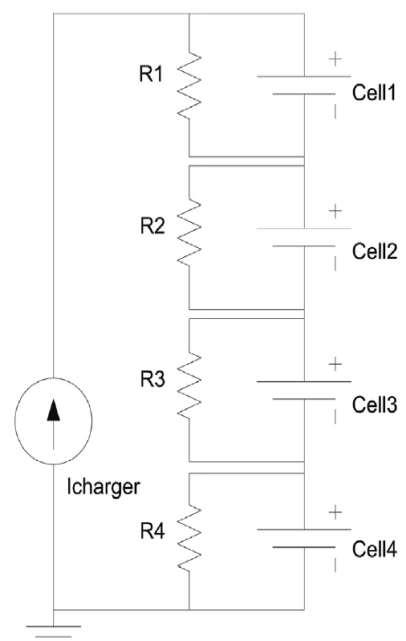
[picture p4: figure]

ภาพที่ 2.3 Fixed shunting resistor

วิธีที่ 2 คือ Switching Shunting resistor - จะมีหลักการเดียวกับวิธี Fixed Shunting resistor เพียงแต่การควบคุมโดยการแบ่งตัวต้านทาน โดยการ บายพาสกระแสถูกควบคุมด้วยสวิตช์ดังแสดงในภาพ ที่ 2.4 โดยตรวจสอบแรงดันที่สูงแล้วทําการบายพาสกระแสทิ้งที่ตัวต้านทานรอให้เซลล์แรงดันที่ตํ่ากว่า เพิ่มระดับแรงดันเพื่อจะทําให้มีระดับแรงดันเดียวกันจึงจำเป็นที่จะต้องมีการวัดแรงดันของแต่ละเซลล์ ตลอดเวลา เหมาะสําหรับแบตเตอรี่ชนิดลิเทียมไอออน

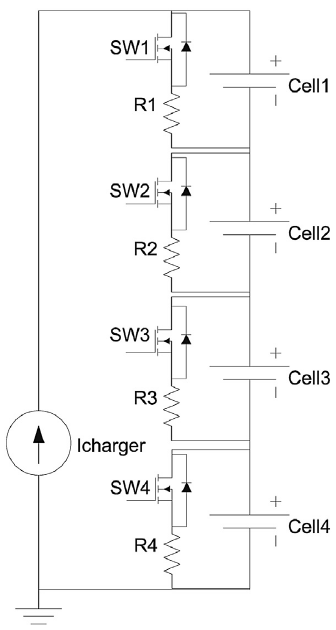
[picture p5: figure]

ภาพที่ 2.4 Switching shunting resistor

2.4.2 การปรับสมดุลแบบแอคทีฟ (Active balancing) จะแตกต่างจากการปรับสมดุลเซลล์แบบพาสซีฟคือในการจัดการกับเซลล์ที่มีแรงดันสูง ที่สุดจะไม่ถูกบายพาสกระแสไปทิ้งยังตัวตานทานแต่จะนำกระแสนั้นกลับมาอัดประจุให้กับเซลล์ที่ มีแรงดันต่ำกว่าแทนจึงทำให้การปรับสมดุลเซลล์ในรูปแบบนี้มีประสิทธิภาพในการใช้พลังงาน และใช้เวลาในการปรับสมดุลแบตเตอรี่เร็วกว่าการใช้การปรับสมดุลเซลล์แบบพาสซีฟแต่ต้องมี

การวัดแรงดันของทุกเซลล์ตลอดเวลาโดยการปรับสมดุลแบบแอคทีฟนี้สามารถแบ่งแยก รายละเอียดของวิธีการย่อยได้อีก 3 วิธี คือ
วิธีที่ 1 Charge Shuttles (Flying Capacitors) - เป็นวิธีการเก็บพลังงานจาก เซลล์ที่มีแรงดันสูงโดยนำมาเก็บไว้ในตัวเก็บประจุโดยเมื่อระบบตรวจจับเซลล์ที่มีแรงดัน สูงได้แล้วจะสั่งให้switch แบบ SPDT นั้นสับวงจรให้ตัวเก็บประจุนั้นเข้าไปขนานกับ เซลล์ที่มีแรงดันสูงเพื่อดึงประจุจากเซลล์มาเก็บไว้ในตัวเก็บประจุเมื่อเต็มแล้วจึงสับเอา ตัวเก็บประจุไปขนานกับเซลล์ที่มีแรงดันต่ำเพื่อคลายประจุจากตัวเก็บประจุไปชาร์ต เซลล์ที่มีแรงดันต่ำดังแสดงในภาพที่ 2.5 แต่ข้อได้เปรียบ ของวิธีนี้คือปรับสมดดุลตัวเอง ได้ดีข้อเสียเปรียบด้วยวิธีนี้คือการอัดประจุสามารถโอนระหว่างเซลล์ที่อยู่ ติดกันเท่านั้น นอกจากนี้ยังต้องใช้เวลามากขึ้นเนื่องจากตัวเก็บประจุจะต้องใช้เวลาในการอัดประจุและ ดีสอัดประจุเพื่อถ่ายโอนพลังงาน นอกจากนี้ยังมีประสิทธิภาพน้อยกว่าเนื่องจากจะมีการ สูญเสียพลังงาน ในระหว่างการอัดประจุและดีสชาร์ตประจุและยังต้องคํานึงถึงการ สูญเสียพลังงานที่สวิตช์

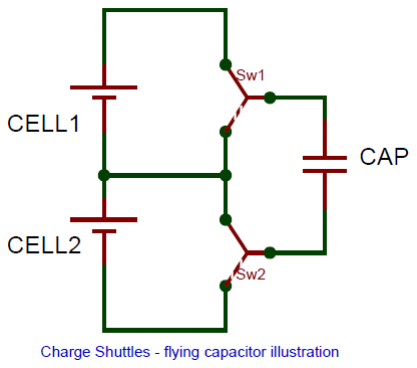
[picture p6: figure]

ภาพที่ 2.5 Switching capacitor
วิธีที่ 2 Inductive converter (Buck Boost method) - วิธีนี้จะใช้วงจร Buck Boost ในการเก็บประจุจากเซลล์ที่มีแรงดันสูงมาเก็บไว้และจ่ายให้กับเซลล์ทีมีแรงดันต่ำ ว่าโดยมีการใช้MOSFET ในการเปลี่ยนแปลงวงจรและเลือกจับคู่เซลล์ ดังแสดงในภาพที่ 2.6 จากการทำงานของวิธีการนี้ทำให้สามารถความคุมระดับของแรงดันและกระแสได้

ผ่านตัววงจร Buck Boost ทําให้ใช้เวลาในการปรับสมดุลแบตเตอรี่ได้อย่างรวดเร็วเร็ว แต่การควบคุมค่อนข้าง ซับซ้อน

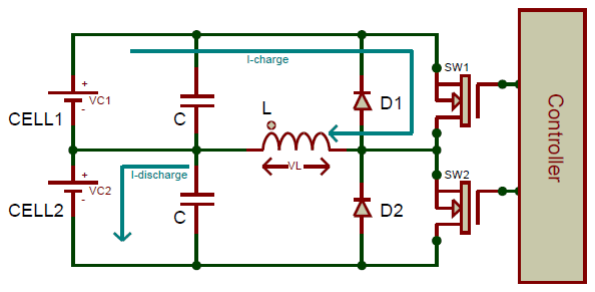
[picture p7: figure]

ภาพที่ 2.6 Buck-Boost converter method

วิธีที่ 3 Inductive converter (Fly back based) - เป็ น วิธีที่ อ าศั ย ข อ ง หลักการรถ่ายโอนพลังงานผ่านขดลวด ปฐมภูมิจะถูกถ่ายโอนไปยังขดลวดทุติยภูมิของ หม้อแปลงไฟฟ้าในการช่วยปรับสมดุลเซลล์แบตเตอรี่โดยภายในแต่เซลล์มีมีขดลวดทุติย ภูมิกับ MOSFET ที่ทำหน้าที่เป็น switch ต่อขนานอยู่และแบตเตอรี่ทั้งระบบจะมี ขดลวดปฐมภูมิกับ MOSFET ต่อขนานอยู่ โดยหลักการทำงนของวิธีปรับสมดุลเซลล์ แบตเตอรี่ประเภทนี้เมื่อมีเซลล์ที่มีแรงดันต่างกันเกินกว่าที่ระบบกำหนดระบบก็จะสั่งเปิด switch (MOSFET) ในวงจรของเซลล์ย่อยที่มีแรงดันต่ำส่งผลในวงจรย่อยของเซลล์นี้นคร บวงจรทำให้เกิดการถ่ายโอนพลังงานระหว่างขดลวดทุติยภูมของวงจรนั้นกับขดลวดปฐม ภูมิของแบตเตอรี่ทั้งระบบแตาเนื่องหลักการของหม้อแปลงคือจะทำงานเมื่อกระแสใน ขดลวดเกิดการเปลี่ยนแปลงดังนั้นระหว่าการปรับสมดุลจึงจำเป็นที่จะต้องให้MOSFET ที่ต่ออนุกรมกับขดลวดปฐมภูมิทำงานเปิดปิดด้วยความถี่ตลอดเวลาดังแสดงในภาพที่ 2.7 โดยการปรับสมดุลด้วยวิธีนี้มีประสิทธิภาพปานกลาง เพราะมีพลังงานสูญเสีย ระหว่างถ่านโอนพลังงานจากขดลวดปฐมภูมิจะถูกถ่ายโอนไปยังขดลวด ทุติยภูมิ ความเร็วในปรับสมดุลปานกลางปรับสมดุลตัวเองได้ดีข้อเสียเปรียบของวิธีนี้คือมีขนาด ของ อุปกรณ์ที่ใหญ่และการควบคุมค่อนข้างจะซับซ้อนของวงจร

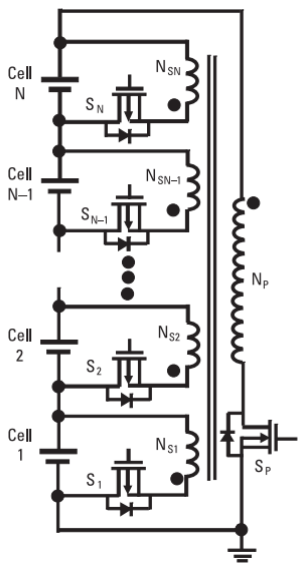
[picture p8: figure]

ภาพที่ 2.7 Multi-winding transformer

2.4.3 การปรับสมดุลแบบ Lossless balancing เป็นวิธีการที่มีแนวคิดว่าจะลดการใช้อุปกรณ์ในการปรับสมดุลแต่จะใช้ Matrix switch ดังแสดงในภาพที่ 2.8 โดยเน้นการใช้ Software ในการบริหารจัดการเซลล์เพื่อลดการสูญเสีย พลังงานในระบบ

ภาพที่ 2.8 Metrix switch circuit

2.4.4 การปรับสมดุลแบบ Redox Shuttle เป็นวิธีการที่จะไม่ยุ่งกับการออกแบบอุปกรณ์เพื่อมาปรับสมดุลเซลล์แบตเตอรี่แต่จะเป็น การยุ่งเกี่ยวกับวัสดุของเซลล์แบตเตอรี่โดยการปรับปรุง electrolyte ในเซลล์เพื่อความสามารถ ของเซลล์ให้มีความสมารถในการ overcharge มากขึ้นโดยเฉพาะในเซลล์แบตเตอรี่แบบ Li-ion

### 2.5 หลักการอัดประจุแบตเตอรี่

ในการนั้นการอัดประจุไฟฟ้าให้กับแบตเตอรี่มีด้วยกัน 2 วิธีดังแสดงในภาพที่ 2.9 คือ โหมด แรงดันคงที่ (Constant Voltage : CV) โดยมีแนวคิดที่ว่าจะจ่ายแรงดันขนาดเท่ากับแรงดันสูงสุดของ แบตเตอรี่ตลอดเวลาจนกระทั่งแบตเตอรี่อัดประจุเสร็จซึ่งวิธีการนี้จะใช้เวลาในการอัดประจุนานเนื่องจาก เมื่อแบตเตอรี่มีแรงดันเข้าใกล้แรงดันที่ตั้งไว้ในการอัดประจุจากกฎของโอห์มกระแสที่จ่ายในการอัดประจุ จะน้อยลงแต่วิธีการนี้จะมีข้อดีคือไม่จำเป็นต้องออกแบบโปรแกรมควบคุมมากและปลอดภัยต่อการ overcharge ของแบตเตอรี่ ส่วนโหมด กระแสคงที่ (Constant Current : CC) จะมีแนวคิดที่ตรงกันข้าม กับโหมดแรกคือการจ่ายกระแสในการอัดประจุให้กับแบตเตอรี่คงที่ตลอดเวลาเพื่อให้สามารถอัดประจุ ให้แก่แบตเตอรี่ได้เร็วโดยใรเริ่มแรงจะจ่ายแรงดันให้เพิ่มเกินแรงดันสูงสุดของแบตเตอรี่เรื่อยๆตามกฎของ โอห์มเพื่อคงกระแสโหมดนี่มีข้อดีคือการอัดประจุที่เร็วแต่ต้องมีการออกแบบโปรแกรมความคุมที่ละเอียด เนื่องจากการอัดประจุด้วยแรงดันที่มากกว่าแรงดันสูงสุดของแบตเตอรี่นั้นเสี่ยงต่อการ overcharge ของ แบตเตอรี่อาจจะทำให้เกิดความเสียหายกับแบตเตอรี่ได้แต่ในปัจจุบันอุปกรณ์อัดประจุแบตเตอรี่นั้นได้นำ การทำงานทั้งสองโหมดมาใช้งานร่วมกันเพื่อนำความได้เปรี่ยบของการอัดประจุทั้งสองโหมดมาใช้ในการ อัดประจุโดยในตอนแรกจะทำงานในโหมด CC ในช่วงต้นเพื่อให้มีการะแสในการอัดประจุที่สูงส่งผลให้มี การอัดประจุเร็วแล้วเมื่อแบตเตอรี่ใกล้เต็มก็จะเข้าสู่โหมด CV เพื่อป้องกันไม่ให้แบตเตอรี่ overcharge แต่ ก็ยังอัดประจุอยู่

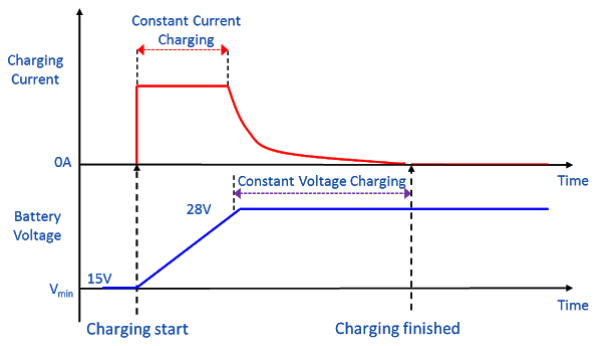
[picture p9: figure]

ภาพที่ 2.9 โหมดการชาร์จกระแสคงที่ และ แรงดันคงที่

### 2.6 Stage of Charge (SoC) , Depth of Discharge (DoD) และ C-rate [9]

2.6.1 Stage of Charge (SoC)
Stage of Charge (SoC) นั้นคือสถานะประจุของแบตเตอรี่มีค่าระหว่าง 0% ถึง 100% บ่งบอกถึงปริมาณประจุที่สัมพันธ์กับความจุของแบตเตอรี่ดังแสดงในภาพที่ 2.10 เช่นเมื่อ แบตเตอรี่เต็มจะมี%SoC ที่ 100%

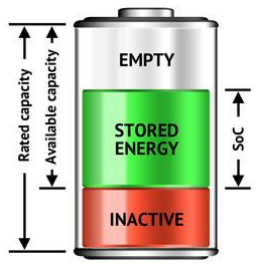
[picture p10: figure]

ภาพที่ 2.10 อธิบายความหมายของ SOC เมื่ออ้างอิงกับความจุของแบตเตอรี่

2.6.2 Depth of Discharge (DoD)
Depth of Discharge (DoD) คือสถานะที่ประจุของแบตเตอรี่ที่ถูกคายออกมีค่าระหว่าง 0% ถึง 100% เช่นเดียวกับ SoC แต่จะบางบอกถึงปริมาณประจุที่ใช้ไปสัมพันธ์กับความจุของ แบตเตอรี่ มีความหมายตรงกันข้ามกับ SoC กล่าวคือเมื่อแบตเตอรี่มี %SoC ที่ 60% จะมี %DoD ที่ 40% ดังแสดงในภาพที่ 2.11

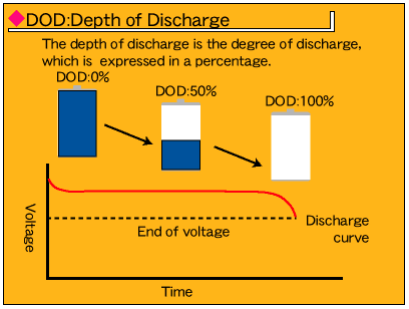
[picture p11: figure]

ภาพที่ 2.11 อธิบายความหมายของ DOD โดยเทียบระหว่าแรงดันและเวลา

จึงสามารถสรุปความสัมพันธ์ของ Stage of charge และ Depth of Discharge ได้ดังภาพที่ 2.12

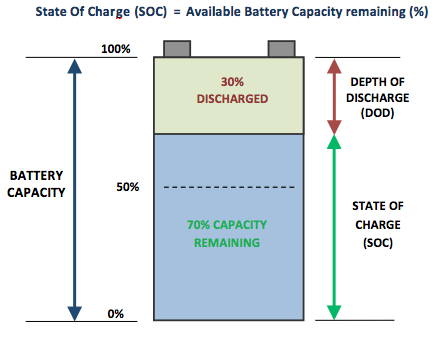
[picture p12: figure]

ภาพที่ 2.12 อธิบายความหมายของ SOC และ DOD เมื่ออ้างอิงกับความจุของแบตเตอรี่ [10]

2.6.3 C-rate
C-rate คือค่าที่บอกความสามารถในการจ่ายกระแสของแบตเตอรี่โดยกล่าวถึงอัตราการ จ่ายกระแสไฟเมื่อเทียบกับความจุของแบตเตอรี่ (Ah) โดยมาความสัมพันธ์ดังตารางที่ 2.1

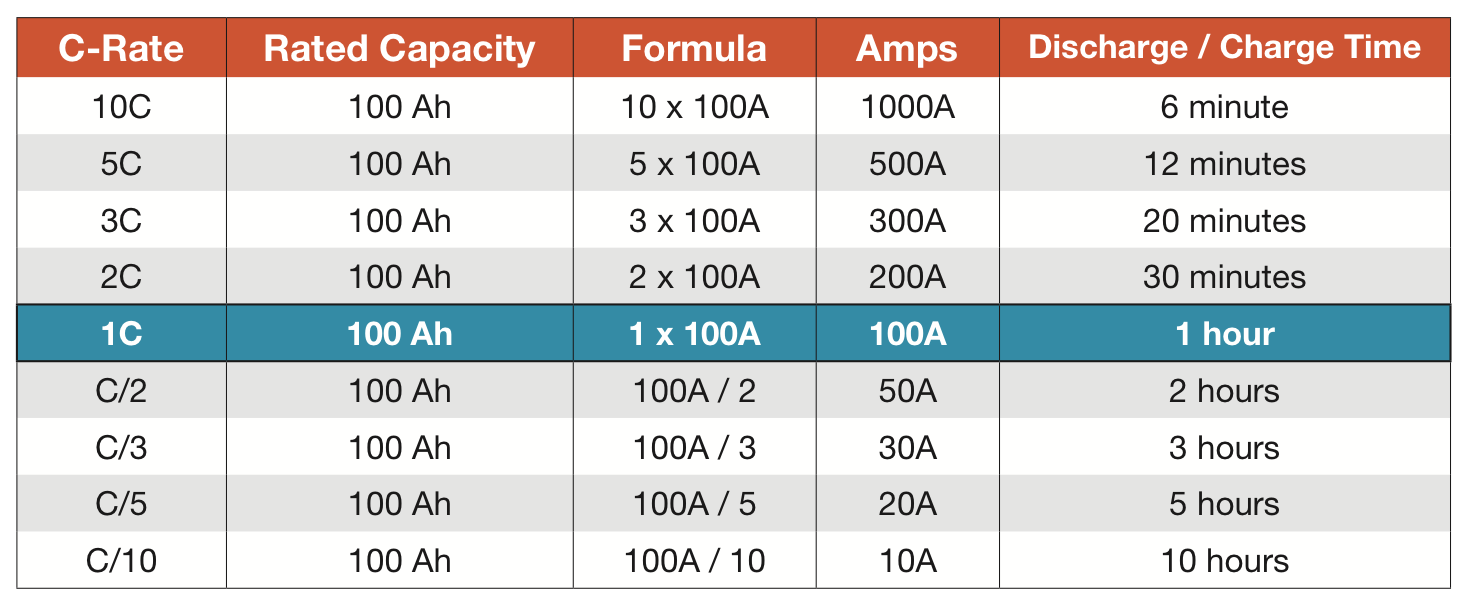
[picture p13: figure]

ตารางที่ 2.1 แสดงถึงความสัมพันธ์ระหว่าง C-rate ความจุ กระแส และ ระยะเวลา ของแบตเตอรี่

บทที่ 3
ขั้นตอนและวิธีการดำเนินงาน

### 3.1 ทำการเก็บผลเพื่อออกแบบการทำงานของระบบจัดการแบตเตอรี่

จากข้อมูลที่ได้ศึกษามาก่อนหน้า[11]ทำให้ทราบว่าการปรับสมดุลพลังงานแบตเตอรี่ชนิดลิเทียม ไอออนด้วยวิธีการ Flying Capacitors มีจุดด้อยในการปรับสมดุลพลังงานคือ เมื่อแรงดันของเซลล์ที่ทำ การปรับสมดุลกับถูกปรับสมดุลนั้นมีค่าที่เข้าใกล้กันมาขึ้น ส่งผลใผลต่างแรงดันระหว่าเซลล์ลดน้อยลงและ เนื่องด้วย ทฤษฎีกฎของโอห์ม[12] ดังสมาการที่ (1)

V = I × R | (1)
I ∝ V | (2)
เมื่อ
V | คือ | แรงดันที่ตกคร่อมตัวต้านทาน (V)
I | คือ | กระแสไฟฟ้าที่ไหลผ่านตัวต้านทาน (A)
R | คือ | ความต้านทานของตัวต้านทาน (Ω)

นั้นได้กล่าวไว้ว่าแรงดันที่ตกคร่อมตัวต่านทานจะแปรผันตรงกับขนาดของกระแสที่ไหลผ่านดังสมการที่ (2) ทำให้กระแสที่ระบบใช้ในการปรับสมดุลนั้นน้อยลงจึงส่งผลต่อระยะเวลาในการปรับมดุลของแบตเตอรี่ ดังนั้นผู้ทำการทดลองจึงได้เปรียบเทียบวิธีการปรับสมดุลของแบตเตอรี่ โดยนำวิธี Flying Capacitor ที่ใช้ Capacitor เป็นตัวกลางในการปรับสมดุล ดังภาพที่ 3.1
การปรับสมดุลด้วยวิธีFlying Capacitor มีเงื่อนไขในการปรับสมดุลคือ
- เซลล์แบตเตอรี่ชนิดลิเทียมไอออนขนาด 2600 mA • h.
- แรงดันเซลล์ที่ปรับสมดุล 4.132 V. (95.00 %SOC)
- แรงดันเซลล์ที่ถูกปรับสมดุล 3.905 V. (75.00 %SOC)

- ระยะเวลาในการปรับสมดุล 3,600 วินาที่ (1 ชั่วโมง)
- ขนาดของ Capacitor 4.4 F.
- ความถี่ในการปรับสมดุล 20 Hz.
- ขนาดของตัวต้านทานของระบบปรับสมดุล 0.1 Ω

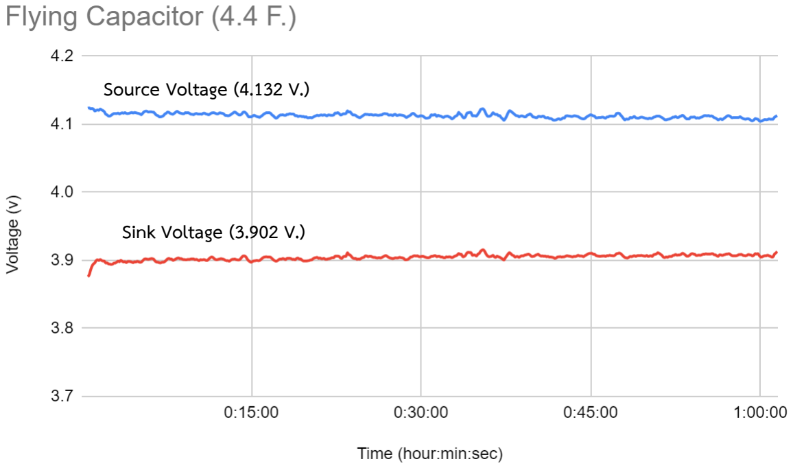
[picture p14: figure]
Source Voltage (4.132 V.); Sink Voltage (3.902 V.)

ภาพที่ 3.1 แรงดันของเซลล์แบตเตอรี่ชนิดลิเทียมไอออนที่ปรับสมดุลด้วยด้วยระบบปรับสมดุลแบบ Flying Capacitor

โดยเมื่อทำการปรับสมดุลครบเวลา 3,600 วินาทีและพักเซลล์เป็นเวลา 600 วินาที พบว่า

- แรงดันเซลล์ที่ปรับสมดุล 4.122 V. (94.21 %SOC)
- แรงดันเซลล์ที่ถูกปรับสมดุล 3.912 V. (75.71 %SOC)
- พลังงานที่สูญเสียจากการปรับสมดุล 0.08 %SOC
- ความแตกต่างของสถานะประจุที่เปลี่ยนไป 1.5 %SOC

และเมื่อนำมาเปรียบเทียบกับวิธี Buck-Boost converter ที่ทำการปรับสมดุลเซลล์แบตเตอรี่ ด้วยแรงดันคงที่ดังภาพที่ 3.2 โดยเมีเงื่อนไขในการปรับสมดุลคือ

การปรับสมดุลด้วยวิธีBuck-Boost converter มีเงื่อนไขในการปรับสมดุลคือ

- เซลล์แบตเตอรี่ชนิดลิเทียมไอออนขนาด 2600 mA • h.
- แรงดันเซลล์ที่ปรับสมดุล 4.132 V. (95.00 %SOC)
- แรงดันเซลล์ที่ถูกปรับสมดุล 3.905 V. (75.00 %SOC)
- ระยะเวลาในการปรับสมดุล 3,600 วินาที่ (1 ชั่วโมง)
- แรงดันในการปรับสมดุล 4.20 V.

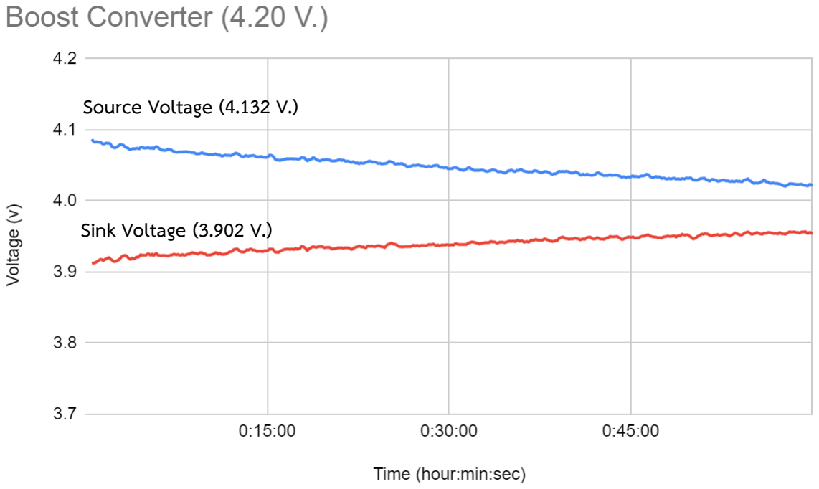
[picture p15: figure]
Sink Voltage (3.902 V.); Source Voltage (4.132 V.)

ภาพที่ 3.2 แรงดันของเซลล์แบตเตอรี่ชนิดลิเทียมไอออนด้วยที่ปรับสมดุลด้วยระบบปรับสมดุลแบบ Buck-Boost converter

โดยเมื่อทำการปรับสมดุลครบเวลา 3,600 วินาทีและพักเซลล์เป็นเวลา 600 วินาที พบว่า

- แรงดันเซลล์ที่ปรับสมดุล 4.077 V. (90.63 %SOC)

- แรงดันเซลล์ที่ถูกปรับสมดุล 3.944 V. (78.98 %SOC)
- พลังงานที่สูญเสียจากการปรับสมดุล 0.39 %SOC
- ความแตกต่างของสถานะประจุที่เปลี่ยนไป 8.35 %SOC

จากการทดลองดังภาพที่ 3.1 และ 3.2 พบว่า ในระยะเวลา 3,600 วินาทีการปรับสมดุลด้วยวิธี Buck-Boost Convertor นั้นทำได้เร็วกว่า Flying Capacitor โดยความแตกต่างของสถานะประจุที่ เปลี่ยนไปนั่นแตกต่างกันมากถึง 6.85 % แต่การปรับสมดุลด้วยวิธี Buck-Boost Convertor นั้นมีจุด้อย เรื่องพลังงานที่สูญเสียจากการปรับสมดุลที่มากกว่าวิธี Flying Capacitor ประมาณ 4.5 เท่า ดังนั้นผู้ ทดลองจึงได้เลือกการปรับสมดุลเซลล์แบตเตอรี่แบบ Buck-Boost Convertor มาพัฒนาระบบประสมดุล แบตเตอรี่

### 3.2 ออกแบบวงจรจัดการแบตเตอรี่แพ็ค

3.2.1 สถาปัตยกรรมของระบบปรับจัดการแบตเตอรี่ สถาปัตยกรรมของระบบที่ทำการออกแบบนั้นจะมีฟังก์ชันการทำงานหลักๆคือ การปรับ สมดุลเซลล์แบตเตอรี่ โดยการปรับสมดุลแบตเตอรี่นั้นจำเป็นที่จะต้องมีระบบการทำงานย่อย ประกอบการทำงานด้วย คือ ระบบการประมวลผลเพื่อเลือกการจับคู่ปรับสมดุล ระบบการวัดค่า สัญญาณที่จำเป็นต่างๆ ระบบการป้องกันความเสียหายต่อเซลล์แบตเตอรี่หากเกิดเหตุการณ์ ผิดปรกติและ ระบบตัวกลางในการส่งพลังงานในการปรับสมดุลเซลล์แบตเตอรี่ นอกจากนี้ยังมี การทำงานเสริมของระบบจัดการแบตเตอรี่อีกด้วย เช่น ส่วนของการแสดงผลและการควบคุม และ ระบบปรับสมดุลเซลล์แบตเตอรี่พร้อมด้วยการอัดประจุจากพลังงานภายนอก ดังภาพที่ 3.3

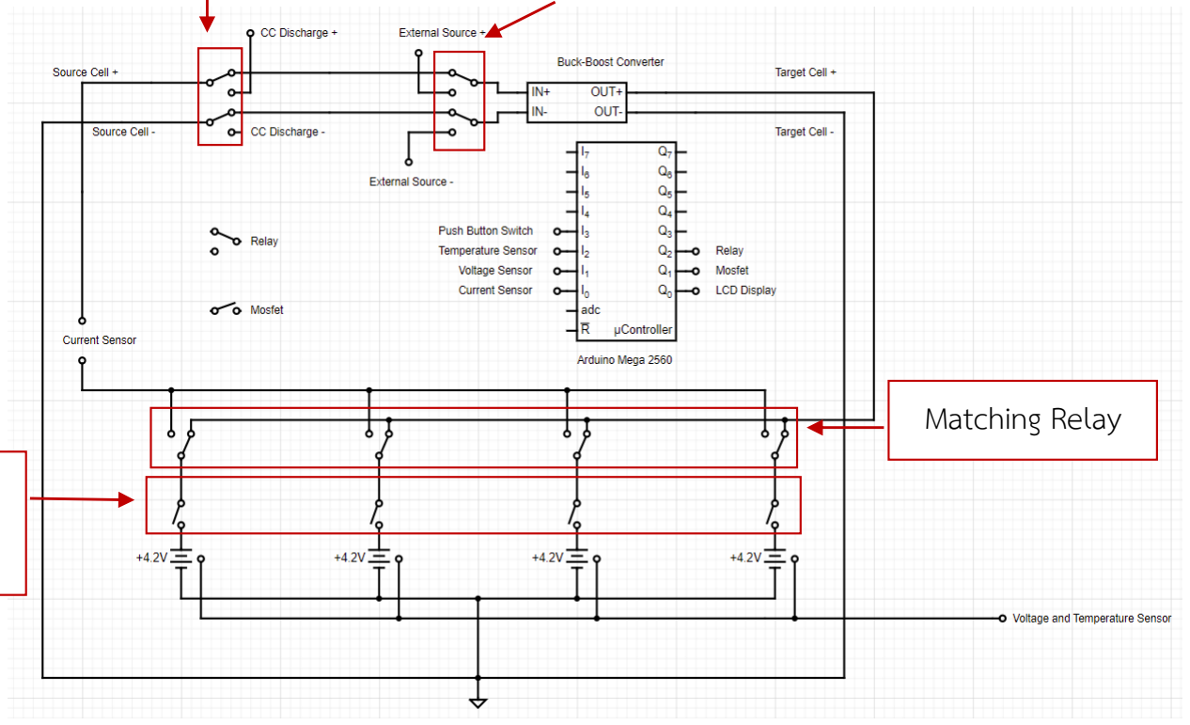
[picture p16: figure]
Matching Relay

ภาพที่ 3.3 สถาปัตยกรรมการัดการแบตเตอรี่ชนิดลิเทียมไอออนที่ต่อขนานจำนวน 4 เซลล์

3.2.2 การทำงานของระบบจัดการแบตเตอรี่ชนิดลิเทียมไอออน การทำงานของระบบจัดการแบตเตอรี่ชนิดลิเทียมไอออนนั้นประกอบไปด้วยสามหัวข้อ ได้แก่ เริ่มการทำงานของระบบ แสดงผลค่าสถานะของระบบและเซลล์แบตเตอรี่ และ การ ปรับแต่งการทำงานของระบบ โดยมีการทำงานของระบบหลักดังภาพที่ 3.4 3.5 3.6 3.7 3.8 3.9 และ 3.10

CC/Discharge Relay | External Source Relay

Cells activate
MOSFET

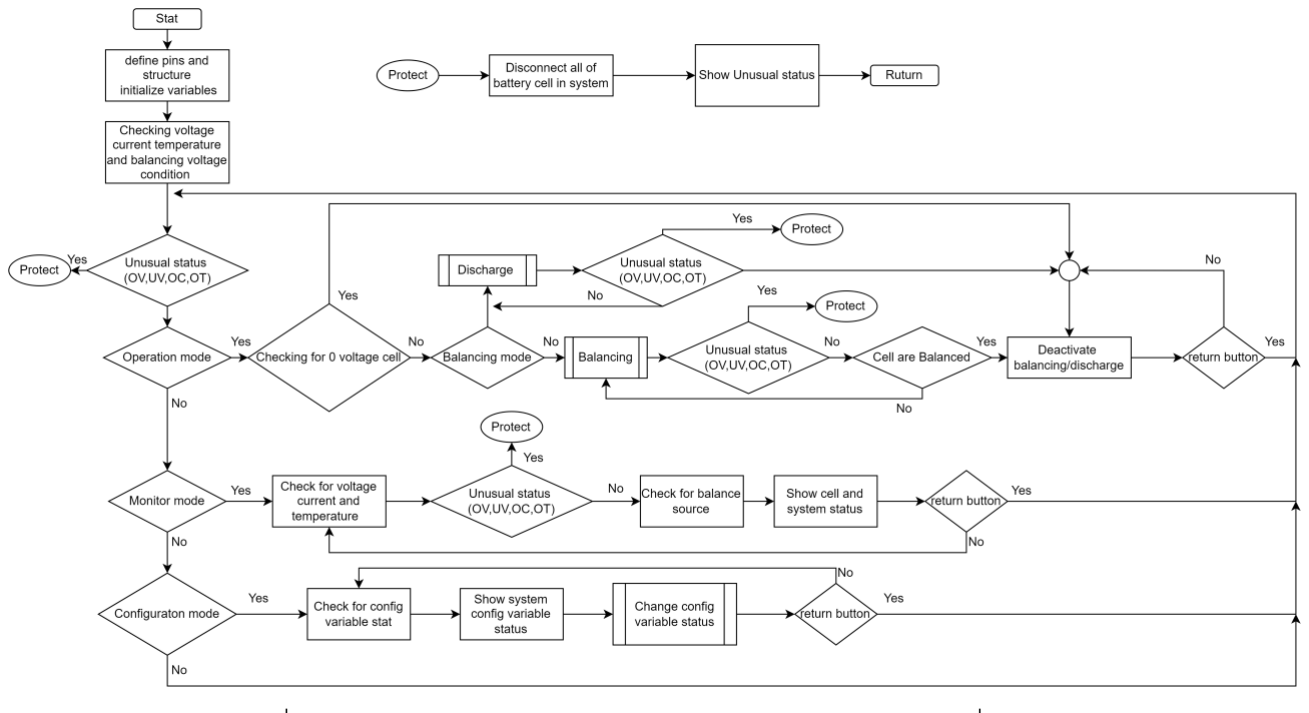
[picture p17: figure]

ภาพที่ 3.4 แผนภาพภาพรวมการทำงานของระบบจัดการแบตเตอรี่

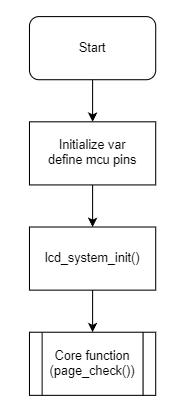
[picture p18: figure]

ภาพที่ 3.5 แผนภาพการเริ่มต้นการทำงานของระบบจัดการแบตเตอรี่

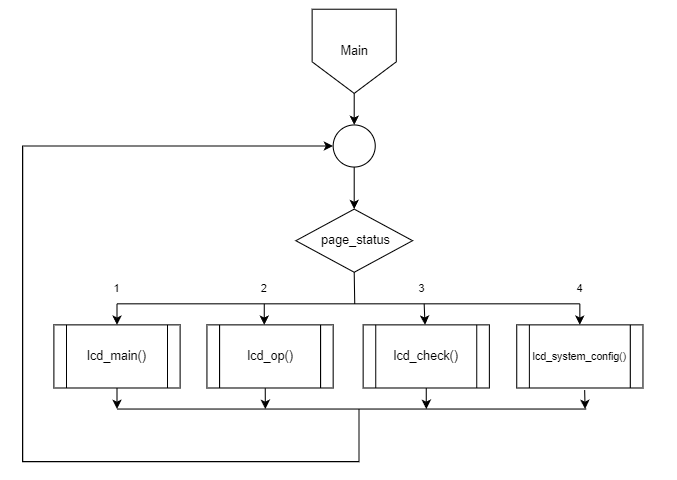
[picture p19: figure]

ภาพที่ 3.6 แผนภาพการตรวจเช็คสถานะคำสั่งหลักและเข้าสู่คำสั่งของระบบจัดการ แบตเตอรี่

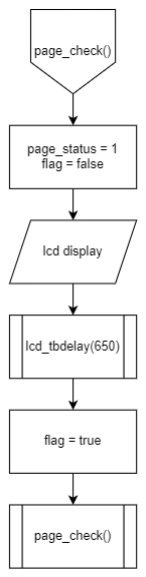
[picture p20: figure]

ภาพที่ 3.7 แผนภาพหน้าหลักของระบบจัดการแบตเตอรี่

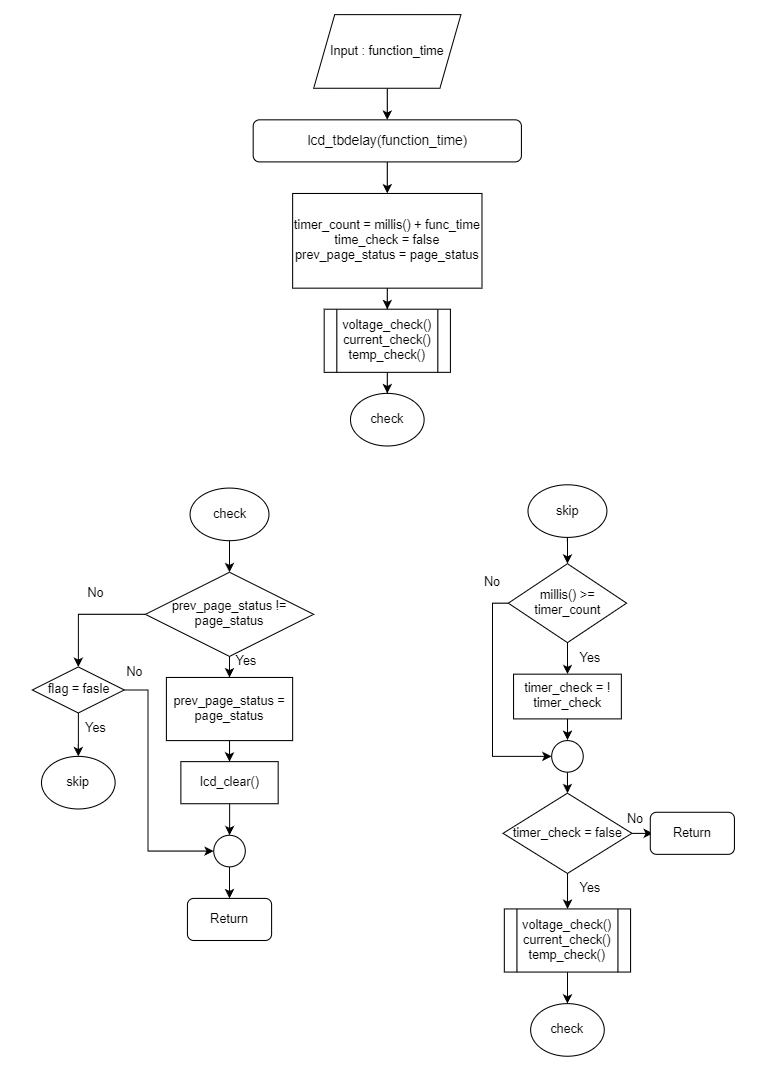
[picture p21: figure]

ภาพที่ 3.8 แผนภาพการทำงานเบื่องหลังในการ delay ของระบบจัดการแบตเตอรี่

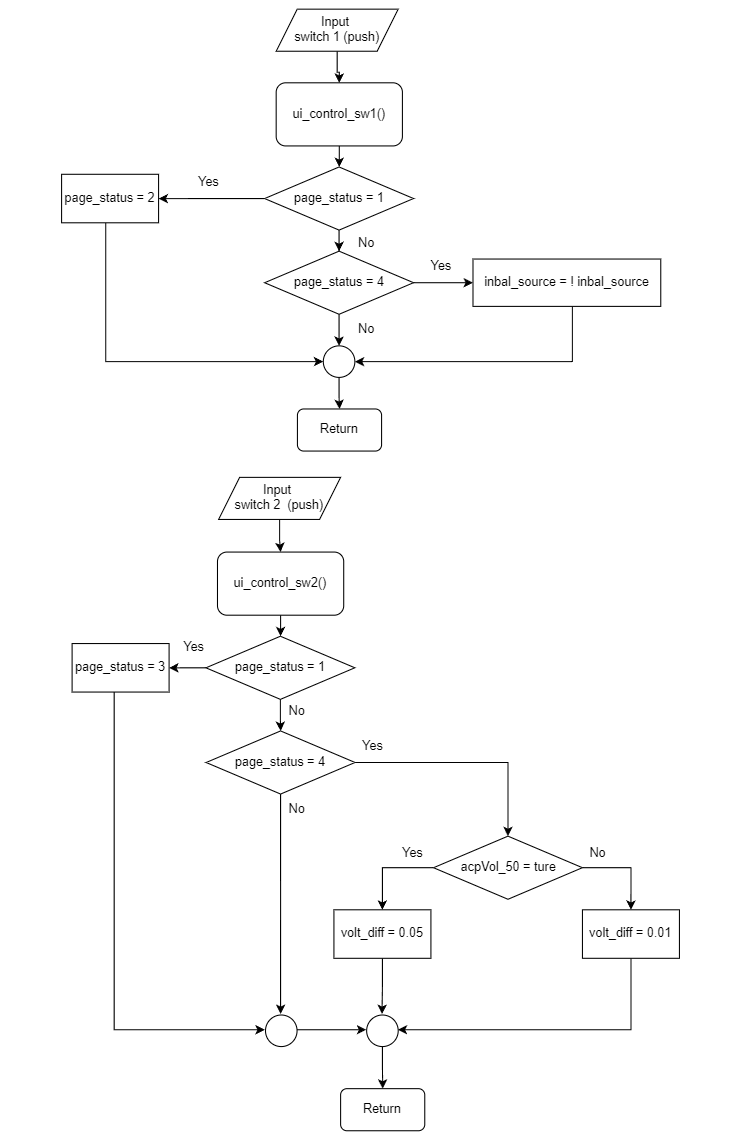
[picture p22: figure]

ภาพที่ 3.9 แผนภาพการทำงานการขัดจังหวะของสวิตช์ 1 และ 2 ของระบบจัดการ แบตเตอรี่

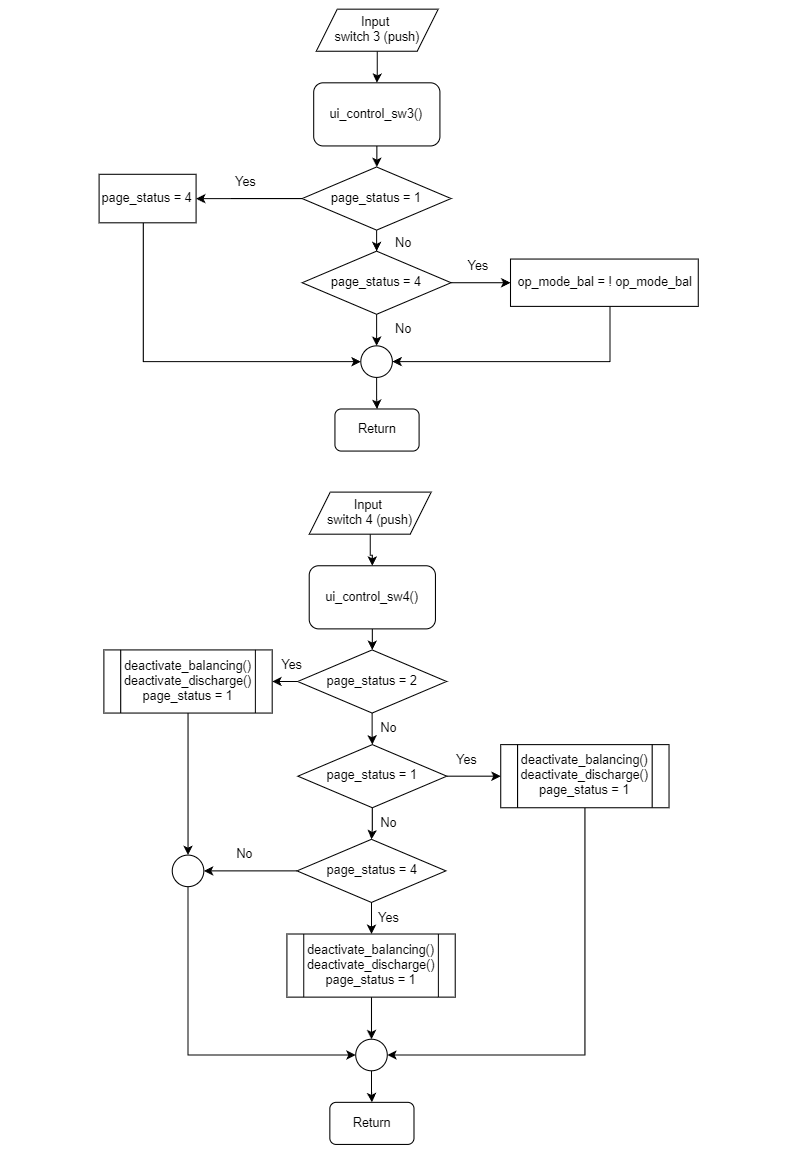
[picture p23: figure]

ภาพที่ 3.10 แผนภาพการทำงานการขัดจังหวะของสวิตช์ 3 และ 4 ของระบบจัดการ แบตเตอรี่

### 3.3 ออกแบบหลักการทำงานของระบบปรับสมดุลของระบบจัดการแบตเตอรี่

การเลือกใช้วิธีการในการปรับสมดุลนั้นจากการศึกษาในหัวข้อก่อนหน้า ทำให้ผู้ทำการวิจัยได้ เลือกใช้วิธีการ Buck-Boost Converter โดยใช้โมดูล Boost converter ที่ใช้ Regulator เบอร์ LM2587 ที่สามารถแปลงแรงดันไฟฟ้าขึ้น 3-12 V เป็น 4-36 V ขนาด 3-5A ดังภาพที่ 3.11

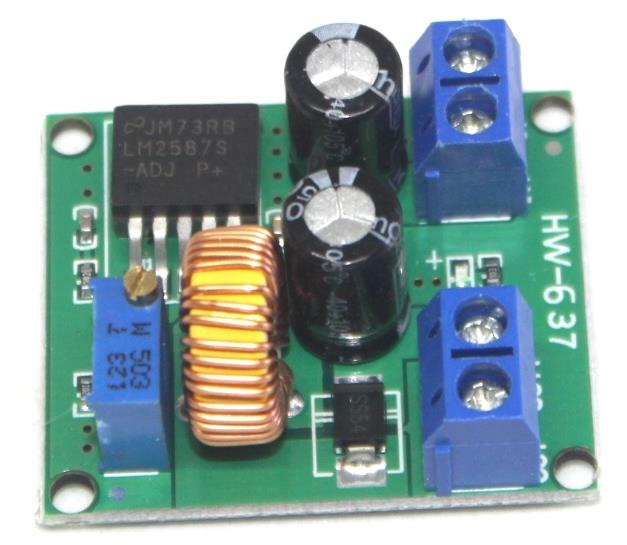
[picture p24: figure]

ภาพที่ 3.11 โมดูลแปลงแรงดันไฟฟ้าที่ใช้Regulator เบอร์ LN2587 ที่สามารถทำการปรับสมดุลเซลล์แบตเตอรี่ได้ไวกว่าแบบ Flying Capacitor โดยแลกกับข้อเสียคือ พลังงานที่สูญเสียไประหว่าการปรับสมดุลที่สูงกว่าวิธี Flying Capacitor ในส่วนของการทำงานของระบบ ปรับสมดุลนั้นจะเลือกการถ่ายพลังงานจากเซลล์สู่เซลล์เนื่องจากจะมีการสูญเสียพลังงานจากการถ่ายโอน พลังงานน้อยกว่าวิธีอื่นดังภาพที่ 3.12

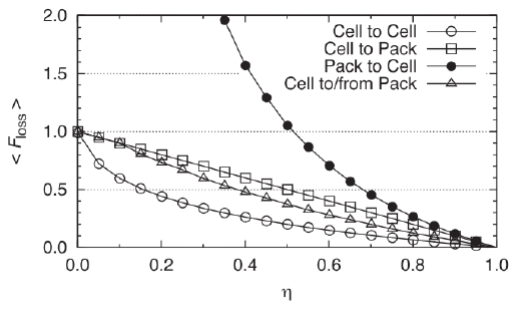
[picture p25: figure]

ภาพที่ 3.12 พฤติกรรมของพลังงานที่สูญเสียในเซลล์แบตเตอรี่ขนะถ่ายโยพลังงานใน รูปแบบต่างๆ [12]
สำหรับขั้นตอนการทำงานของระบบปรับสมดุลเซลล์แบตเตอรี่ในระบบจัดการแบตเตอรี่นั้นระบบ จะทำการวัดแรงดันของเซลล์แบตเตอรี่ทุกเซลล์เพื่อเรียงระดับของแรงดันเพื่อที่จะนำมาจับคู่เพื่อปรับ

สมดุล หาค่าเฉลี่ยของแรงดัน และ ของเขตของแรงดันที่รับได้โดย ระดับค่าความต่างของแรงดันอ้างอิงที่ ยอมรับได้ นั้นจะมี2 ระดับคือ 0.1 mV [11] และ 0.5 mV [14] โดยสามาเลือกได้ผ่านการตั่งค่าของ ระบบ โดยมีการคำนวณและจับคู่ดังภาพที่ 3.13 และ การปรับสมดุลดังภาพที่ 3.14 และ 3.15

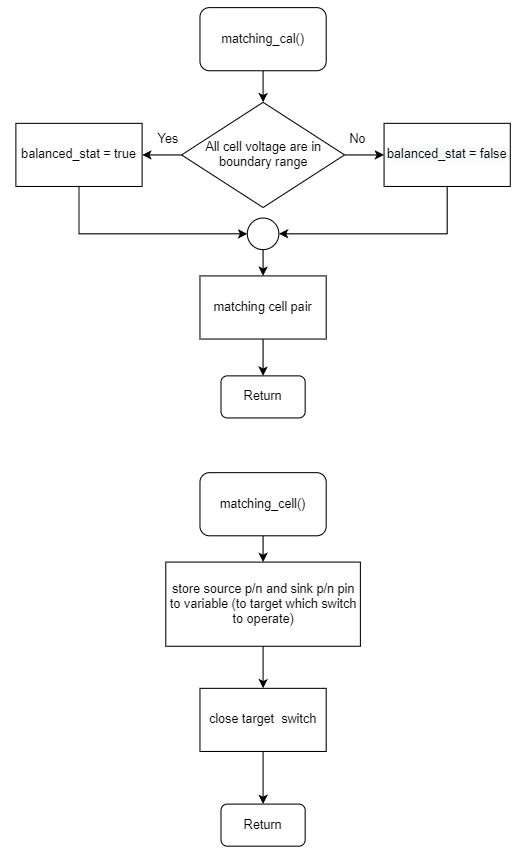
[picture p26: figure]

ภาพที่ 3.13 แผนภาพการทำงานของการคำนวณและจับคู่เซลล์ที่จะทำการปรับสมดุล

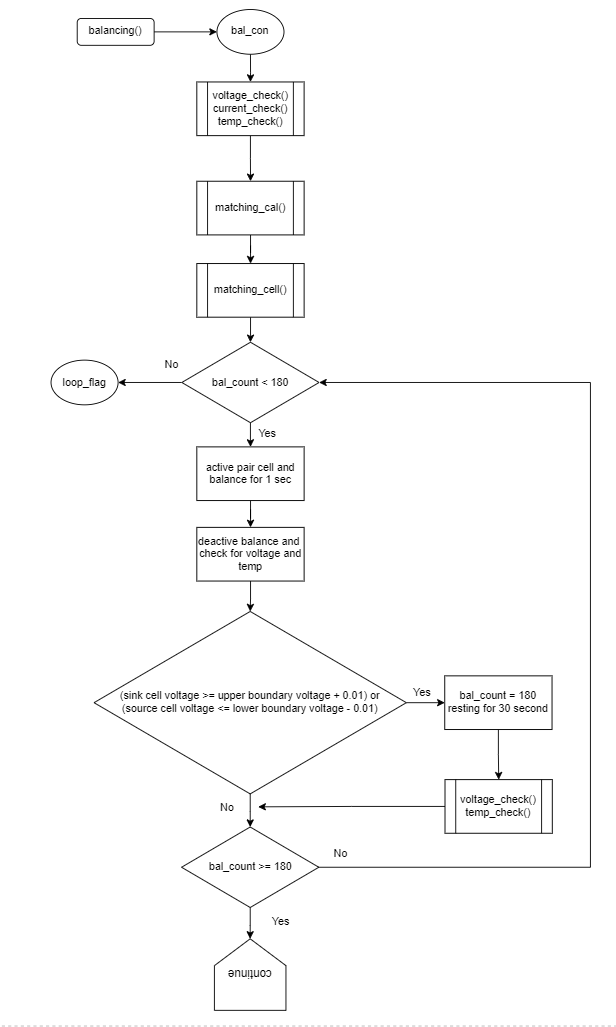
[picture p27: figure]

ภาพที่ 3.14 แผนภาพการทำงานของการปรับสมดุลเซลล์แบตเตอรี่

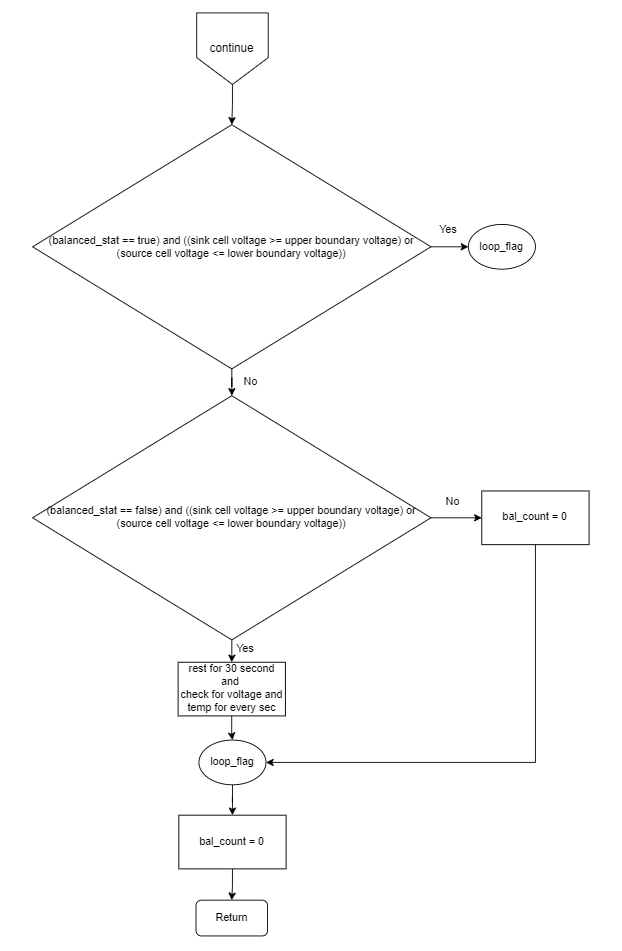
[picture p28: figure]

ภาพที่ 3.15 แผนภาพการทำงานของการปรับสมดุลเซลล์แบตเตอรี่ (ต่อ)

### 3.4 การตรวจวัดสัญญาณ

ในการตรวจจับสัญญาณเพื่อใช้ในการทำงานของระบบป้องกันเซลล์แบตเตอรี่และระบบปรับสมดุล แบตเตอรี่นั้นประกอบไปด้วยการตรวจวัดสัญญาณกระแสไฟฟ้า แรงดันทางไฟฟ้า และ อุณหภูมิ
3.4.1 การตรวจวัดสัญญาณแรงดันไฟฟ้า ในการตรวจวัดแรงดันไฟฟ้าของเซลล์แบตเตอรี่เนื่องจากเซลล์แบตเตอรี่ในระบบนั้นทำ การต่อแบบขนานทำให้สามารถรับสัญญาณเข้าสู่ขา ADC ของ micro controller ได้โดยตรง และ ทำการต่อ Pull-down resistor ขนาด 10 kΩ ตามภาพที่ 3.16

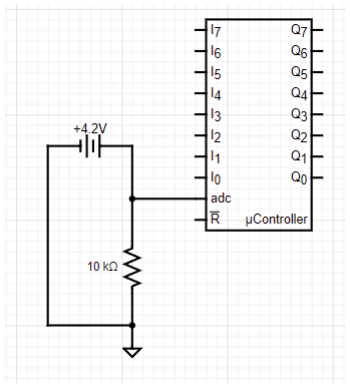
[picture p29: figure]

ภาพที่ 3.16 การต่อวงจรเพื่อวัดแรงดันของเซลล์แบตเตอรี่โดยมีการต่อ pull-down resistor ขนาด 10 kΩ

3.4.2 การตรวจวัดสัญญาณกระแสไฟฟ้า ในการตรวจวัดกระแสไฟฟ้าของระบบนั้นได้ทาการเลือกใช้ โดมดูลวัดสัญญาณกระแสที่ ใช้ไอซีเบอร์ ACS712 ดังภาพที่ 3.17 ที่ทำการเปลี่ยนสัญญาณกระแสเป็นแรงดันที่อ้างอิงจาก สัญญาณแรงดันอ้างอิงขนาด 5.0 Volt. และทำการต่อเข้าขา ADC ของ micro controller เพื่อ นำสัญญานไปประมวลผลต่อไป

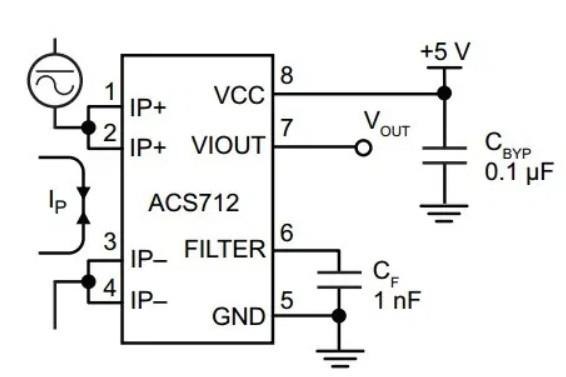
[picture p30: figure]

ภาพที่ 3.17 วงจรที่ใช้ในการวัดสัญญาณกระแสไฟฟ้าและเปลี่ยนเป็นสัญญาณแรงดัน โดยใช้ไอซีเบอร์ACS712
3.4.3 การตรวจวัดสัญญาณอุณหภูมิ
สำหรับการตรวจวัดอุณหภูมินั้น ได้เลือกใช้Temperature sensor เบอร์ LM35 ดัง ภาพที่ 3.18 ในการใช้งานโดยตัว Sensor นั้นถูกสอบเทียบเพื่อให้สามารถอ่าค่าแรงดันเป็น อุณหภูมิหน่วย Celsius ได้โดยตรง โดยมีความละเอียด 10 mV/°C

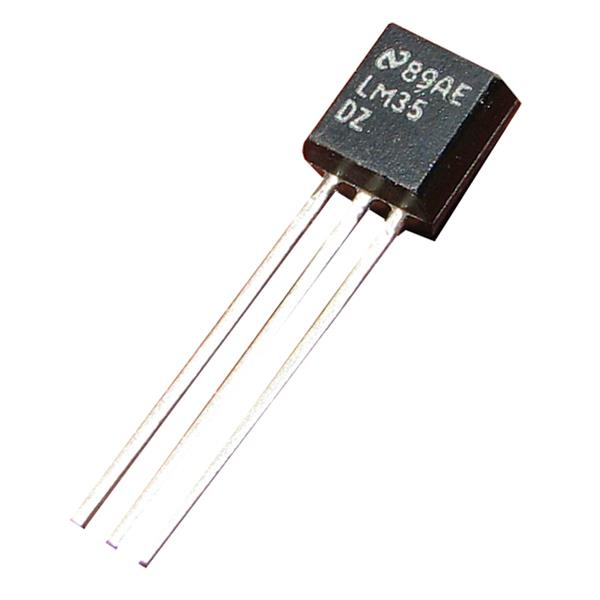
[picture p31: figure]

ภาพที่ 3.18 ไอซีวัดแรงดันเบอร์ LM35

### 3.5 ออกแบบวงจรป้องกันแบตเตอรี่แพ็ค

จากคุณสมบัติของแบตเตอรี่จาก datasheet ของแบตเตอรี่รุ่น Toriyama ICR18650-22 ดัง ภาพที่ 3.19 ทำให้สามารถทราบขอบเขตที่ต้องใช้ในการป้องกันได้โดย

- แรงดันอัดประจุสูงสุดที่เซลล์แบตเตอรี่รับได้= 4.20 ± 0.05 Volt.
- อุณหภูมิสูงสุดในการอัดประจุของเซลล์แบตเตอรี่ = 45.0 °C
- กระแสไฟฟ้าที่ขณะจ่ายอย่างต่อเนื่องสูงสุด = 1.30 A.

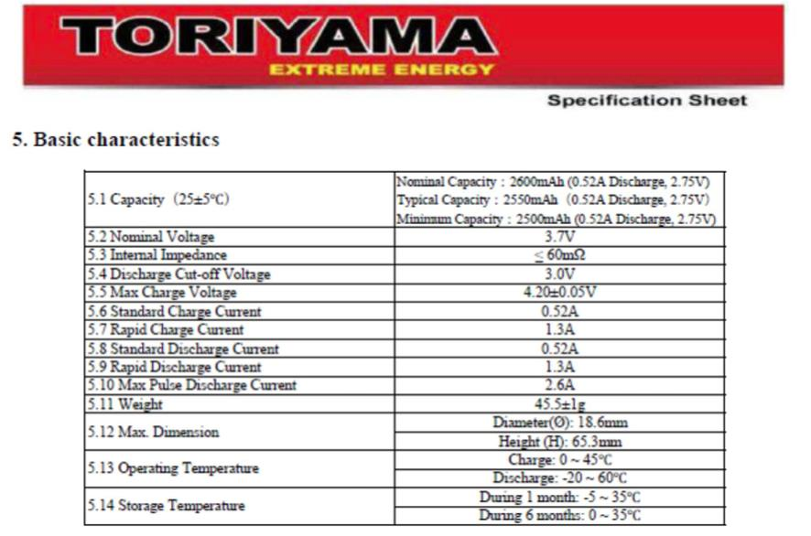
[picture p32: figure]

ภาพที่ 3.19 Datasheet บอกคุณสมบัติเบื่องต้นของแบตเตอรี่รุ่น Toriyama ICR18650-22 [15]

บทที่ 4
ผลการดำเนินงานและสรุปผลการดำเนินงาน

### 4.1 การทดสอบปรับสมดุลโดยการเพิ่มแรงดันในการปรับสมดุล

4.1.1 เงื่อนไขในการปรับสมดุลด้วยแรงดันปรับสมดุลขนาด 4.20 Volt

- เวลาที่ใช้ในการปรับสมดุล 4 ชั่วโมง
- ความแตกต่างของแรงดันของเซลล์แบตเตอรี่ที่ยอมรับได้10 mV
- เวลาที่ใช้ในการพักเซลล์แบตเตอรี่เมื่อเซลล์ใดในคู่เซลล์แบตเตอรี่ที่ทำการปรับสมดุลมี่ค่า เท่ากับแรงดันเฉลี่ย 30 วินาที

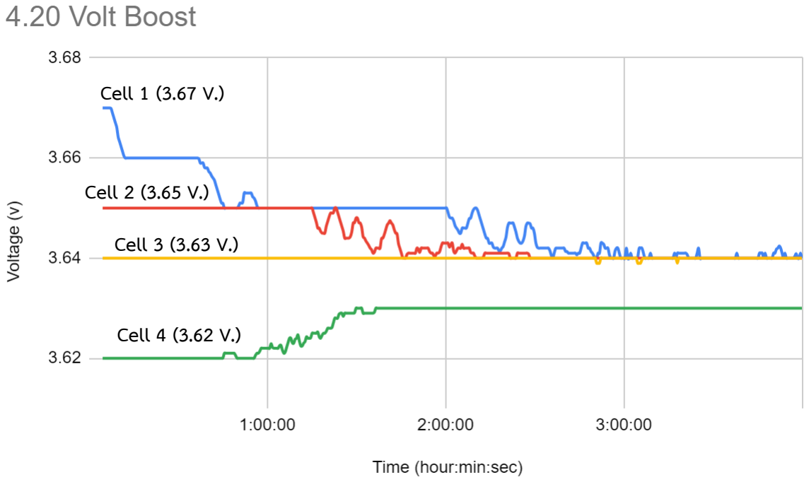
[picture p33: figure]
Cell 1 (3.67 V.); Cell 2 (3.65 V.); Cell 3 (3.63 V.); Cell 4 (3.62 V.)

ภาพที่ 4.1 ปรับสมดุลเป็นเวลา 4 ชั่วโมงด้วยแรงดันปรับสมดุลขนาด 4.20 Volt

| Cell 1 | Cell 2 | Cell 3 | Cell 4 | Average Voltage
Before | 3.67 | 3.65 | 3.63 | 3.62 | 3.6425
After (2:27:53) | 3.64 | 3.64 | 3.64 | 3.63 | 3.6375

ตารางที 4.1 แรงดันก่อนปรับสมดุลและหลังปรับสมดุลด้วยแรงดันปรับสมดุล 4.20 Volt

4.1.2 เงื่อนไขในการปรับสมดุลด้วยแรงดันปรับสมดุลขนาด 4.25 Volt

- เวลาที่ใช้ในการปรับสมดุล 4 ชั่วโมง
- ความแตกต่างของแรงดันของเซลล์แบตเตอรี่ที่ยอมรับได้ 10 mV
- เวลาที่ใช้ในการพักเซลล์แบตเตอรี่เมื่อเซลล์ใดในคู่เซลล์แบตเตอรี่ที่ทำการปรับสมดุลมี่ค่า เท่ากับแรงดันเฉลี่ย 30 วินาที

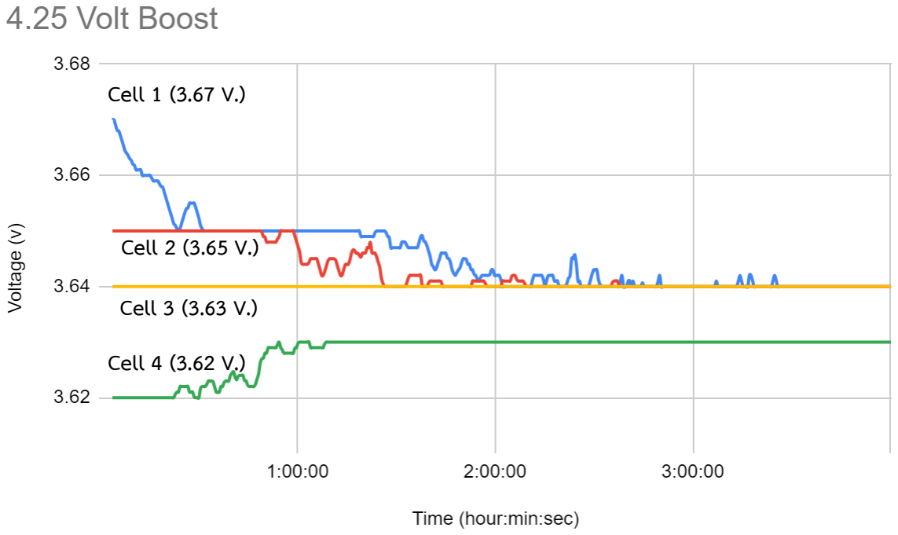
[picture p34: figure]
Cell 1 (3.67 V.); Cell 3 (3.63 V.); Cell 2 (3.65 V.); Cell 4 (3.62 V.)

ภาพที่ 4.2 ปรับสมดุลเป็นเวลา 4 ชั่วโมงด้วยแรงดันปรับสมดุลขนาด 4.25 Volt

| Cell 1 | Cell 2 | Cell 3 | Cell 4 | Average Voltage
Before | 3.67 | 3.65 | 3.63 | 3.62 | 3.6425
After (1:58:50) | 3.64 | 3.64 | 3.64 | 3.63 | 3.6375

ตารางที 4.2 แรงดันก่อนปรับสมดุลและหลังปรับสมดุลด้วยแรงดันปรับสมดุล 4.25 Volt

4.1.3 เงื่อนไขในการปรับสมดุลด้วยแรงดันปรับสมดุลขนาด 4.38 Volt

- เวลาที่ใช้ในการปรับสมดุล 4 ชั่วโมง
- ความแตกต่างของแรงดันของเซลล์แบตเตอรี่ที่ยอมรับได้ 10 mV
- เวลาที่ใช้ในการพักเซลล์แบตเตอรี่เมื่อเซลล์ใดในคู่เซลล์แบตเตอรี่ที่ทำการปรับสมดุลมี่ค่า เท่ากับแรงดันเฉลี่ย 30 วินาที

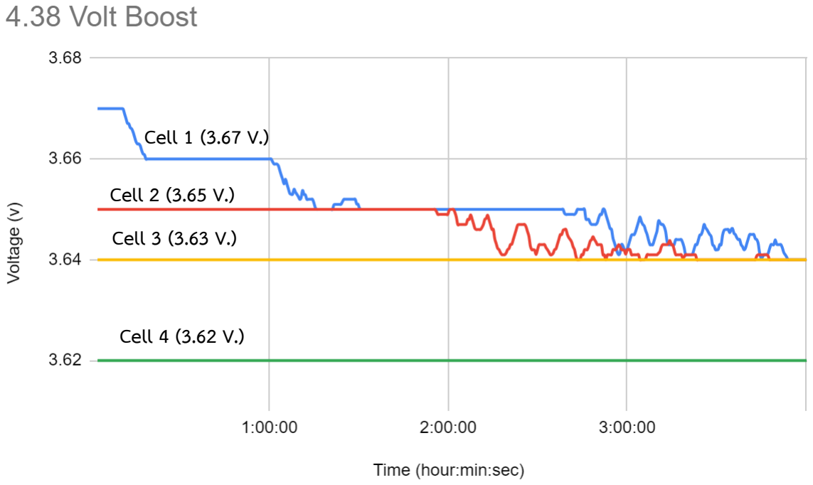
[picture p35: figure]
Cell 1 (3.67 V.); Cell 2 (3.65 V.); Cell 3 (3.63 V.); Cell 4 (3.62 V.)

ภาพที่ 4.3 ปรับสมดุลเป็นเวลา 4 ชั่วโมงด้วยแรงดันปรับสมดุลขนาด 4.38 Volt

| Cell 1 | Cell 2 | Cell 3 | Cell 4 | Average Voltage Upper/Under
Before | 3.67 | 3.65 | 3.63 | 3.62 | 3.6425
After (4:00:22) | 3.64 | 3.64 | 3.64 | 3.62 | 3.6350

ตารางที 4.3 แรงดันก่อนปรับสมดุลและหลังปรับสมดุลด้วยแรงดันปรับสมดุล 4.38 Volt

จากการทดลองเมื่อเพิ่มแรงดันในการปรับสมดุลเซลล์แบตเตอรี่พบว่าในการเพิ่มแรงดันในการ ปรับสมดุลนั้นส่งผลต่อเวลาที่ใช้ในการปรับสมดุลเซลล์แบตเตอรี่ดังแสดงในภาพที่ 4.1 และ 4.2 แต่เมื่อ เพิ่มแรงดันไปจนถึงแรงดันค่าหนึ่งพลังงานของเซลล์ที่ทำการปรับสมดุลนั้นส่วนใหญ่สูญเสียไปในการเพิ่ม แรงดันซึ่งทำให้พลังงานที่ถูกส่งไปยังเซลล์ถูกปรับสมดุลลดน้อยลงไปส่งผลให้ใช้เวลามาขึ้นในการปรับ สมดุลและพลังงานที่สูญเสียไปในระบบสูงดังแสดงในภาพที่ 4.3 โดยสามารถสรุปได้ดังสมการ (3)

E, Transfer ∝ V, Boosted × (E, Source cell release - E, Voltage boost) (3)

โดย E, Transfer | คือ พลังงานที่ถูกถ่ายโอน
V, Boosted | คือ แรงดันไฟฟ้าที่ทำการปรับสมดุล

E, Source cell release คือ พลังงานที่เซลล์ Source จ่าย

E, Voltage boost คือ พลังงานที่ถูกใช้ไปในการเพิ่มแรงดัน

### 4.2 การทดสอบปรับสมดุลเซลล์ที่มีแรงดันต่างกันมาก

เงื่อนไขในการปรับสมดุลเซลล์ที่มีแรงดันต่างกันมากด้วยแรงดันปรับสมดุลขนาด 4.25 Volt

- ขนาดของแรงดันเซลล์แบตเตอรี่เริ่มต้น c1 = 4.20 Volt (≈ 100 %SOC) ,
c2 = 3.73 Volt (≈ 55 %SOC) , c3 = 3.70 Volt (≈ 50 %SOC) ,

c4 = 3.38 Volt (≈ 5 %SOC)

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

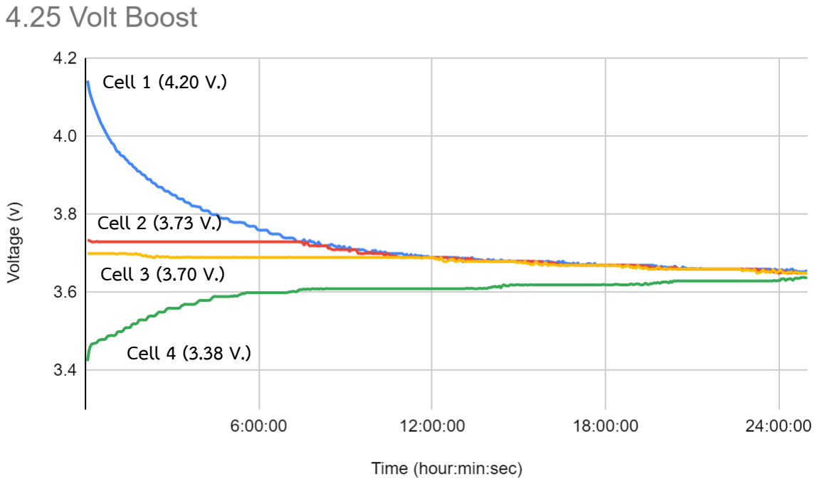
[picture p36: figure]
Cell 1 (4.20 V.); Cell 2 (3.73 V.); Cell 3 (3.70 V.); Cell 4 (3.38 V.)

ภาพที่ 4.4 ปรับสมดุลเซลล์แบตเตอรี่ที่มีแรงดันต่างกันมากด้วยแรงดันปรับสมดุลขนาด 4.25 Volt

| Cell 1 | Cell 2 | Cell 3 | Cell 4 | Average Voltage
Before | 4.20 | 3.73 | 3.70 | 3.38 | 3.7525
After (25:00:18) | 3.65 | 3.65 | 3.65 | 3.64 | 3.6475

ตารางที 4.4 แรงดันก่อนปรับสมดุลและหลังปรับสมดุลเซลล์แบตเตอรี่ที่มีแรงดันต่างกันมากด้วย แรงดันปรับสมดุล 4.25 Volt
จากการวิเคราะห์ผลการทดลองที่ 4.2.1 ด้วยภาพที่ 4.4 และ ตรารางที่ 4.4 สามารถปรบสมดุล เซลล์แบตเตอรี่ที่มีแรงดันห่างกันสูงให้เข้าเงื่อนไขการปรับสมดุลโดยมีแรงดันต่างจากแรงดันเฉลี่ยได้ไม่เกิน 5 mV ได้เพียงแต่ในการปรับสมดุลด้วยวิธี Buck-boost Converter นั้นมีการสูญเสียพลังงานระหว่างการ ปรับสมดุลสูง และ มีข้อได้เปรียบจากการปรับสมดุลด้วยวิธี Flying capacitor คือใช้เวลาในการปรับ สมดุลเซลล์แบตเตอรี่ที่มีแรงดันแตกต่างระหว่างเซลล์ต่ำได้ไวกว่า จึงสรุปได้ว่าในการปรับสมดุลเซลล์ แบตเตอรี่ด้วยวิธีการปรับสมดุลเซลล์แบตเตอรี่ด้วยวิธี Buck-boost converter เหมาะกับการปรับสมดุล เซลล์ที่มีแรงดันระหว่างเซลล์ต่ำและใช้เวลาในการปรับสมดุลไม่นาน

### 4.3 การทดสอบระบบควบคุมการทำงานของระบบจัดการแบตเตอรี่

ในการใช้งานระบบการจัดการเซลล์แบตเตอรี่ผู้ใช้สามารถควบคุมการทำงานได้โดยผ่าน User interface ของระบบ สำหรับการทำงานในหัวข้อต่างๆโดยมี การดำเนินการทำงานของระบบจัดการ แบตเตอรี่ ดังภาพที่ 4.5 และ 4.6 การแสดงสถานะต่างๆของเซลล์แบตเตอรี่และของระบบจัดการ แบตเตอรี่ ดังภาพที่ 4.7 และ 4.8 และ การปรับแต่งคุณสมบัติต่างๆของระบบจัดการแบตเตอรี่ ดังภาพที่ 4.9 และ 4.10

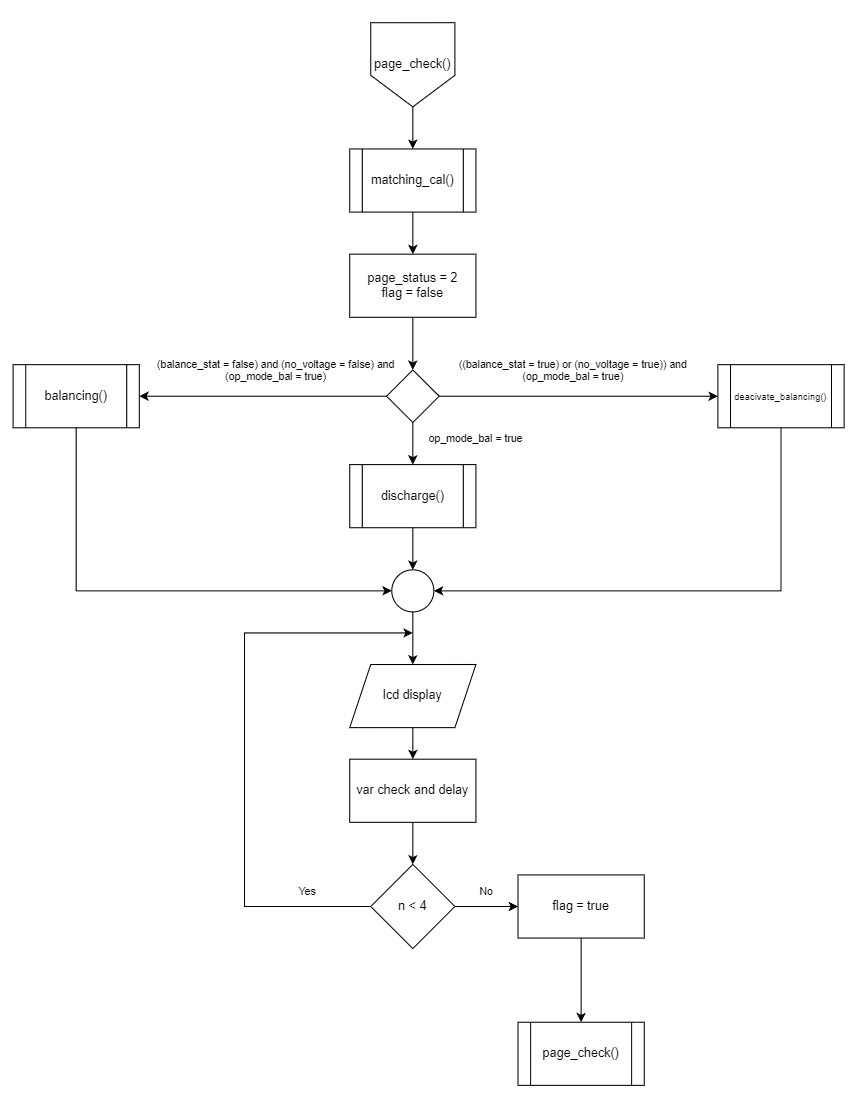
[picture p37: figure]

ภาพที่ 4.5 แผนภาพหน้าการดำเนินการทำงานของระบบจัดการแบตเตอรี่

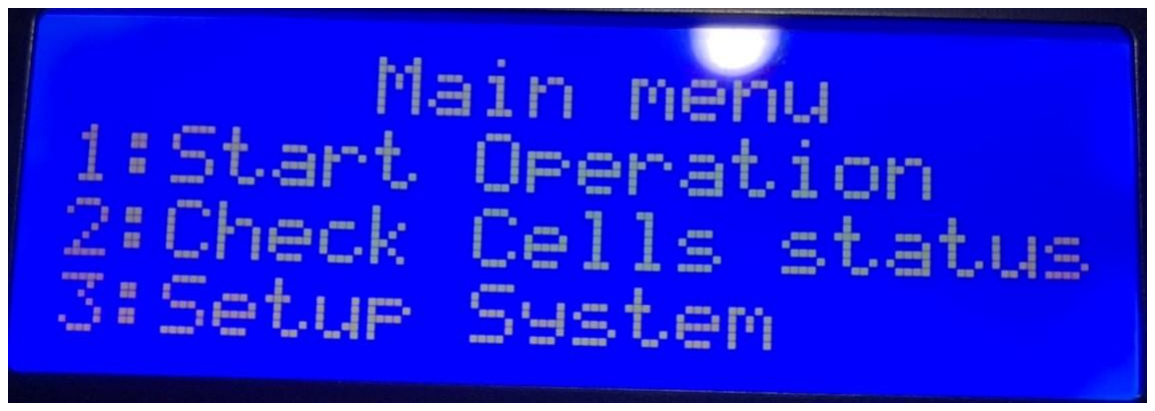
[picture p38: figure]

ภาพที่ 4.6 หน้าจอ LCD การดำเนินการทำงานของระบบจัดการแบตเตอรี่

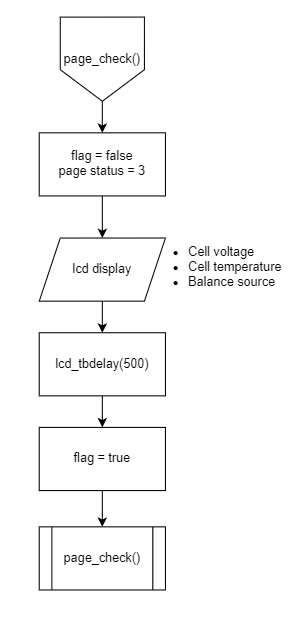
[picture p39: figure]

ภาพที่ 4.7 แผนภาพหน้าการแสดงสถานะต่างๆของเซลล์แบตเตอรี่และของระบบจัดการแบตเตอรี่

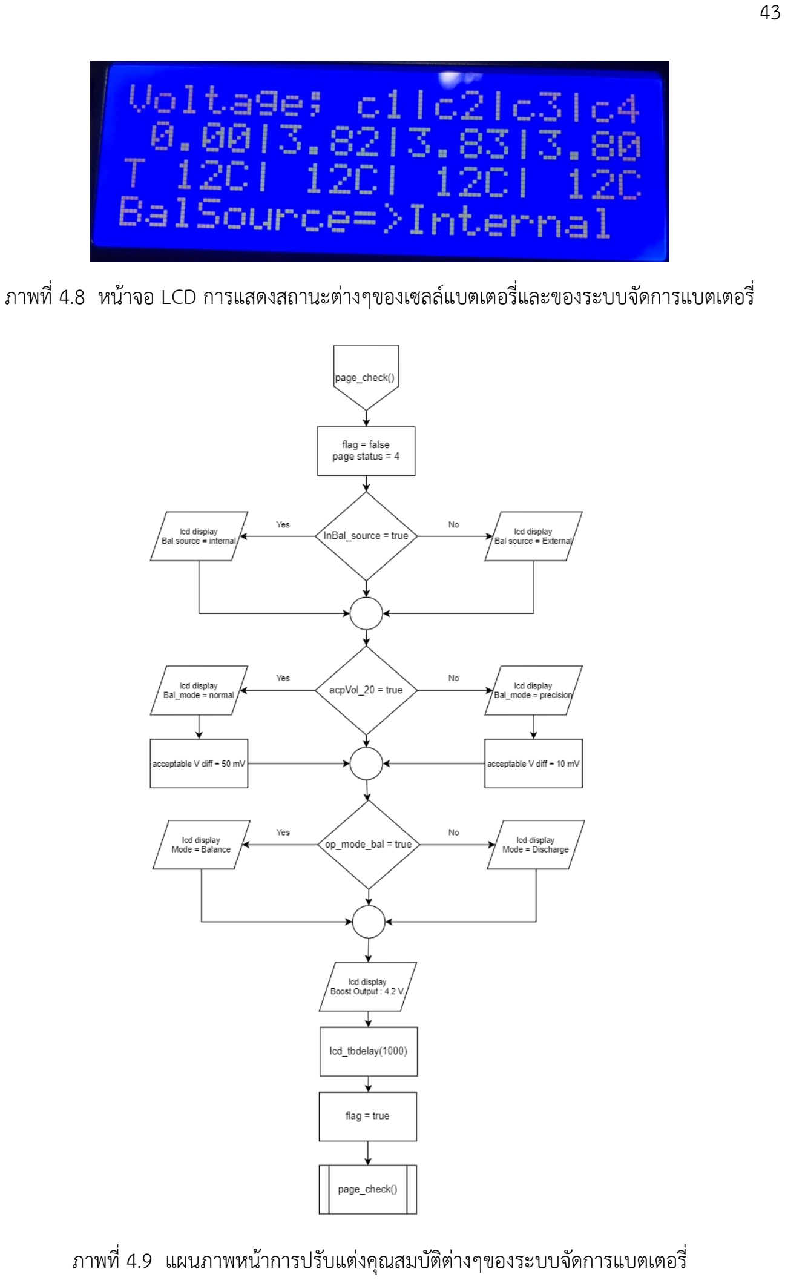
[picture p40: page 59]

ภาพที่ 4.8 หน้าจอ LCD การแสดงสถานะต่างๆของเซลล์แบตเตอรี่และของระบบจัดการแบตเตอรี่

ภาพที่ 4.9 แผนภาพหน้าการปรับแต่งคุณสมบัติต่างๆของระบบจัดการแบตเตอรี่

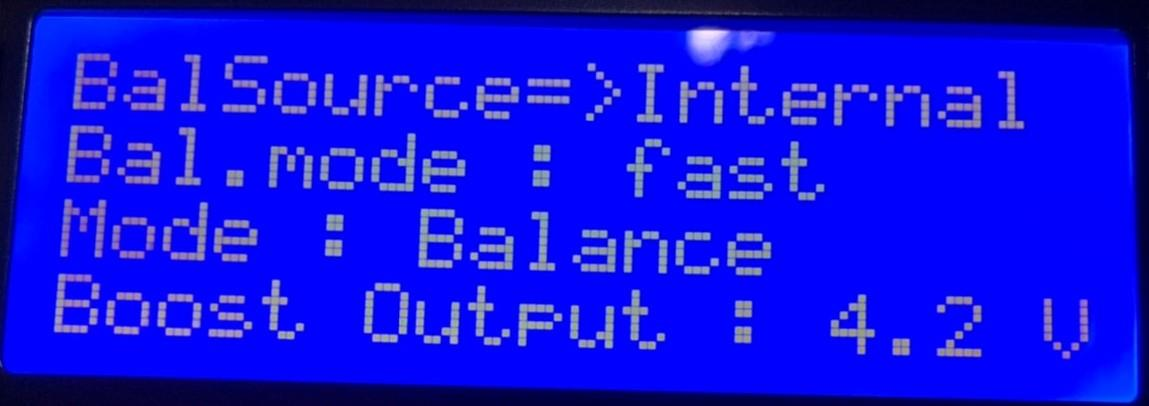
[picture p41: figure]

ภาพที่ 4.10 หน้าจอ LCD การปรับแต่งคุณสมบัติต่างๆของระบบจัดการแบตเตอรี่

### 4.4 การทดสอบระบบป้องกันเซลล์แบตเตอรี่

สำหรับการป้องกันของระบบนั้นจะทำการรับค่าสถานะต่างๆของแบตเตอรี่มาประมวลผลเพื่อ นำมาตรวจสอบว่าตรงกับเงื่อนไขที่ได้กำหนดไว้หรือไม่เพื่อที่จะหยุดการทำงานของระบบและแสดงผล สถานะผิดปกติที่ระบบตรวจพบเพื่อที่ให้ผู้ใช้ทำการตรวจสอบและเริ่มต้นการทำงานของระบบใหม่ต่อไป โดยกระบวนการตรวจสอบนั้นจะอยู่ภายใต้การทำงานของการรับสัญญาณต่างๆเพื่อที่จะสามารถตรวจสอ สถานะผิดปกติได้ตลอดเวลาโดยสถานะที่เมื่อระบบตรวจสอบแล้วพบจะระบุว่าผิดปกติ คือ Over Voltage , Under Voltage , Over Current , Over Temperature โดยมีขั้นตอนการทำงานดังภาพ 4.11 , 4.12 , 4.13 และ 4.14

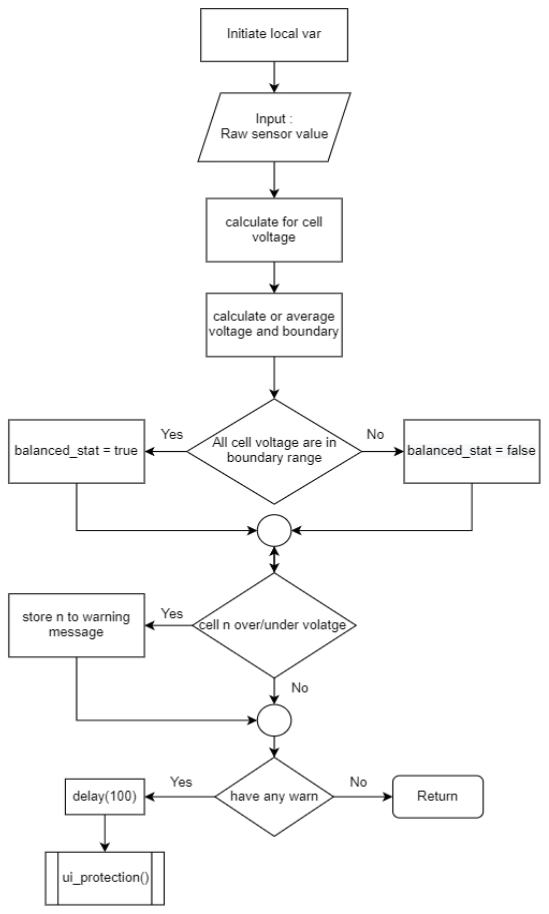
[picture p42: figure]

ภาพที่ 4.11 แผนภาพการวัดค่าแรงดันและประมวลผลสำหรับการป้องกันเซลล์ของระบบจัดการ แบตเตอรี่

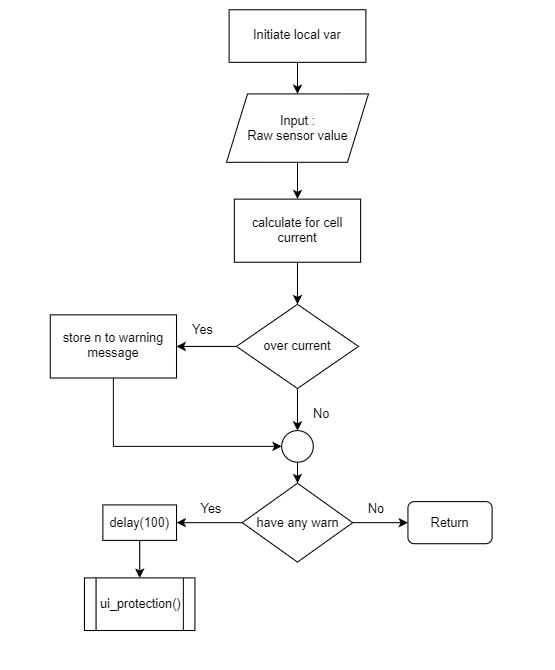
[picture p43: figure]

ภาพที่ 4.12 แผนภาพการวัดค่ากระแสและประมวลผลสำหรับการป้องกันเซลล์ของระบบจัดการ แบตเตอรี่

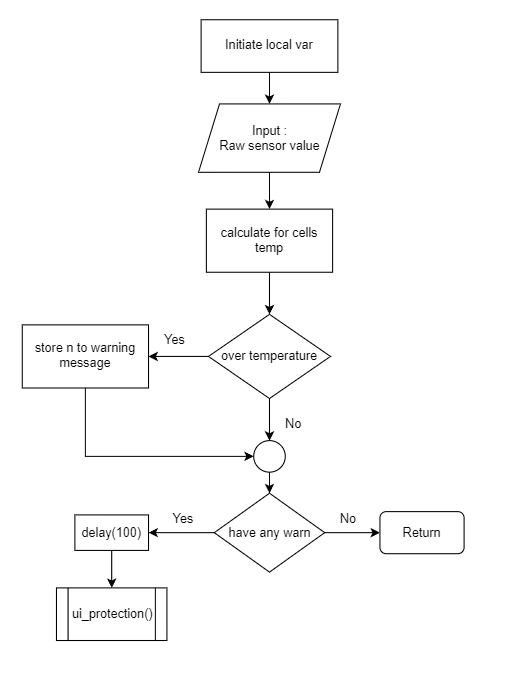
[picture p44: figure]

ภาพที่ 4.13 แผนภาพการวัดค่าอุณหภูมิและประมวลผลสำหรับการป้องกันเซลล์ของระบบจัดการ แบตเตอรี่

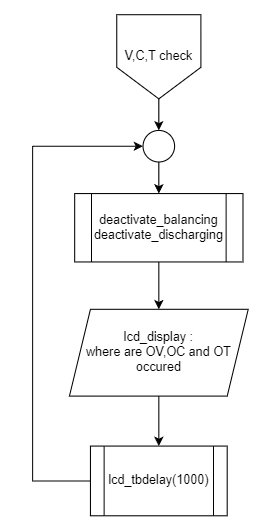
[picture p45: figure]

ภาพที่ 4.14 แผนภาพการแสดงผลเมื่อสามารถตรวจจับความผิดปกติของเซลล์แบตเตอรี่ของระบบ จัดการแบตเตอรี่

โดยการแสดงผลของจอ LCD เมื่อสามารถตรวจจับสถานะผิดปกติของเซลล์แบตเตอรี่เป็นไปดัง ภาพที 4.15 , 4.16 , 4.17 และ 4.18

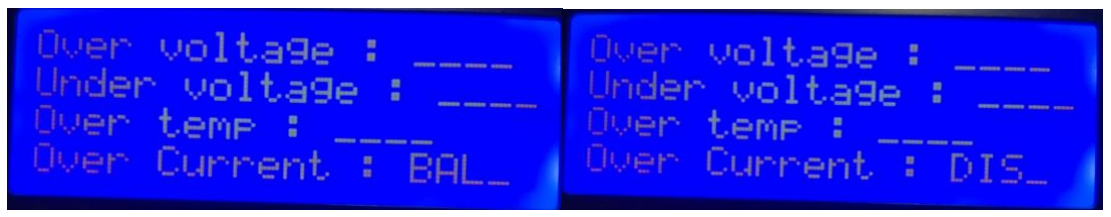
[picture p46: figure]

ภาพที่ 4.15 หน้าจอ LCD การแสดงผลเมื่อสามารถตรวจจับสถานะ Over Current ในระบบเมื่อมีการ ทำการ Balance และ Discharge

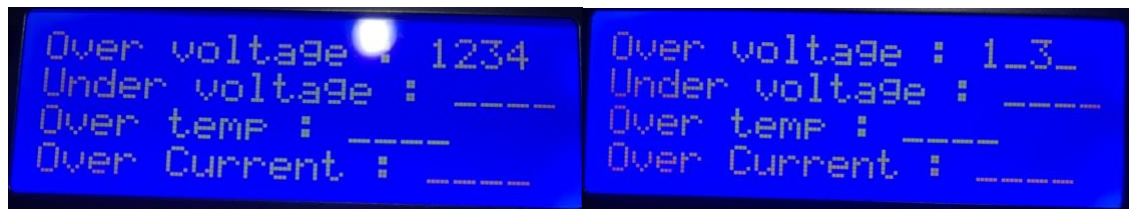
[picture p47: figure]

ภาพที่ 4.16 หน้าจอ LCD การแสดงผลเมื่อสามารถตรวจจับสถานะ Over Voltage ในระบบที่เซลล์ 1,2,3,4 และ 1,3

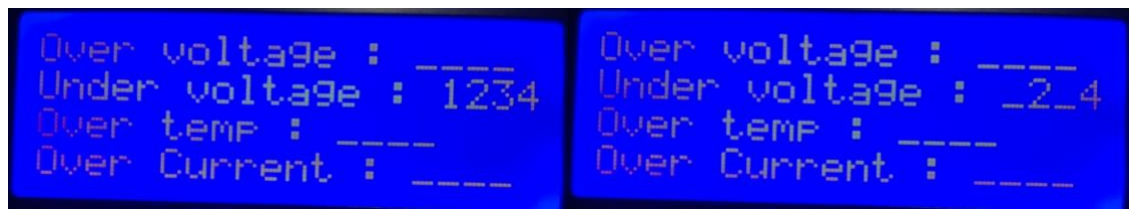
[picture p48: figure]

ภาพที่ 4.17 หน้าจอ LCD การแสดงผลเมื่อสามารถตรวจจับสถานะ Under Voltage ในระบบที่เซลล์ 1,2,3,4 และ 2,4

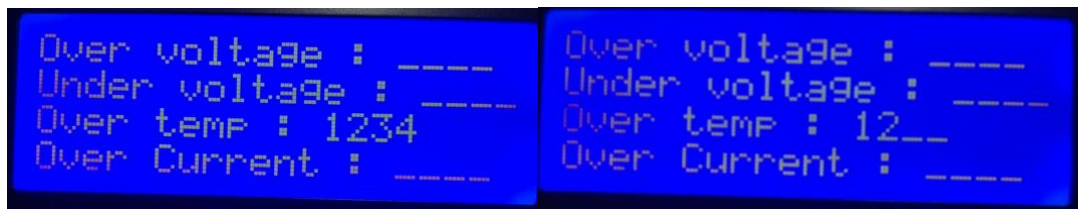
[picture p49: figure]

ภาพที่ 4.18 หน้าจอ LCD การแสดงผลเมื่อสามารถตรวจจับสถานะ Over Temperature ในระบบที่ เซลล์1,2,3,4 และ 1,2

### 4.5 การทดสอบการดำเนินการทำงานของระบบ

ในการดำเนินการทำงานของระบบจัดการแบตเตอรี่นั้นจะมีหน้าจอการแสดงผลที่ระบุสถานะการ ทำงานของระบบเพื่ออำนวยความสะดวกต่อผู้ใช้ในการติดตามการทำงานของระบบโดยมีหน้าการแสดงผล ดังภาพ

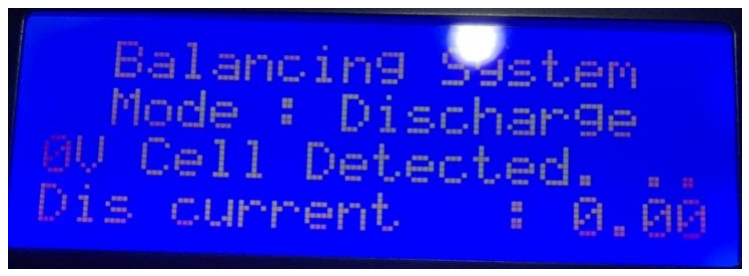
[picture p50: figure]

ภาพที่ 4.19 หน้าจอ LCD การแสดงผลเมื่อระบบดำเนินการ Discharge และพบเซลล์ที่มีแรงดัน 0 Volt

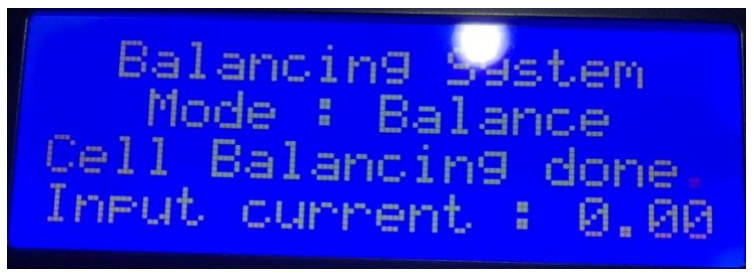
[picture p51: figure]

ภาพที่ 4.20 หน้าจอ LCD การแสดงผลเมื่อระบบดำเนินการ Balance และพบเซลล์ที่มีแรงดัน 0 Volt

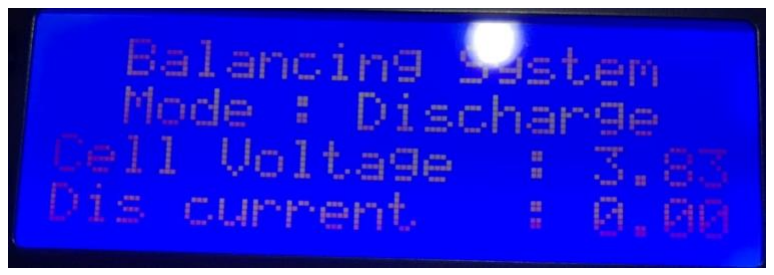
[picture p52: figure]

ภาพที่ 4.21 หน้าจอ LCD การแสดงผลเมื่อระบบดำเนินการ Discharge

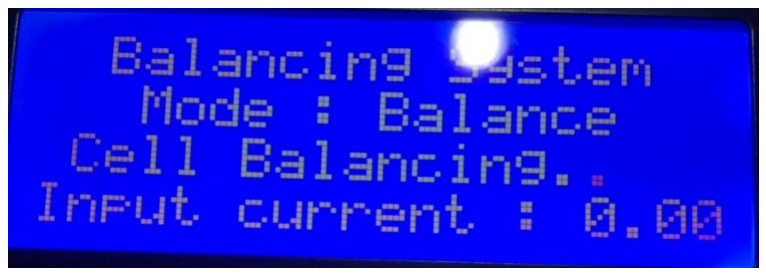
[picture p53: figure]

ภาพที่ 4.22 หน้าจอ LCD การแสดงผลเมื่อระบบดำเนินการ Balance

### 4.6 ผลการทดสอบการดำเนินการปรับปรุงระบบปรับสมดุล

ในการปรับปรุงระบบปรับสมดุลนั้นผู้วิจัยได้เลือกที่จะเปลี่ยนวิธีปรับสมดุลเพื่อนลบข้อด้อยที่เป็น ปัญหาหลักของระบบปรับสมดุลเก่าโดยได้เปลี่ยนจาก Flying capacitor เป็น Buck-Boost Converter โดยสามารถสรุปผลได้ดังตารางที่ 4.5
| Flying Capacitor | Buck-Boost Converter
ความเร็วในการปรับสมดุล | ช้าเมื่อแรงดันต่างกันน้อย | เร็ว
ความซับซ้อนของวงจร | น้อย | มาก อุปกรณ์เยอะ
พลังงานสูญเสียในระบบ | ต่ำ | ค่อนข้างสูง
ความซับซ้อนในการควบคุม | น้อย | มาก

ตารางที่ 4.5 การเปรียบเทียบวิธีการปรับสมดุลระหว่าง Flying capacitor และ Buck-Boost converter

บทที่ 5
บทสรุปและข้อเสนอแนะ

### 5.1 สรุปผลการดำเนินงาน

ในงานวิจัยนี้ได้มุ้งเน้นศึกษาและพัฒนาระบบการจัดการเซลล์แบตเตอรี่ลิเทียมไอออนขนาด 18650 จำนวน 4 เซลล์โดยมีการปรับสมดุลเซลล์แบตเตอรี่เป็นการทำงานหลักของระบบ เนื่องจาก การศึกษาพบว่าในเซลล์แบตเตอรี่ชนิดลิเทียมไอออนนั้นคุณสมบัติมีความจำเพาะในแต่ละเซลล์ทำให้ สามารถคายประจุด้วยปริมาณไม่เท่ากันส่งผลให้เซลล์แบตเตอรี่ในระบบเดียวกันสามารถมีความจุไม่ เท่ากันทำให้ใช้งานแบตเตอรี่ได้ไม่เต็มประสิทธิภาพดังนั้นการปรับสมดุลแบตเตอรี่เป็นการเพิ่ม ประสิทธิภาพในการใช้งานแบตเตอรี่ โดยการปรับสมดุลเซลล์แบตเตอรี่ของระบบจัดการแบตเตอรี่ที่ได้ทำ การพัฒนาขึ้นมานั้นได้เลือกใช้วิธีการปรับสมดุลด้วยวิธี Buck – Boost Converter ที่มีข้อได้เปรียบเรื่อง ความเร็วในการปรับสมดุล โดยทำงานควบคู่กับระบบป้องกันสถานะผิดปกติของเซลล์แบตเตอรี่โดยมีการ ป้องกัน แรงดันสูงเกิน แรงดันต่ำเกิน กระแสสูงเกิน และ อุณหภูมิเกิน ผ่านระบบที่ทำให้ผู้ใช้งานสามารถ ควบคุมได้อย่างสะดวก แต่เนื่องจากกการปรับสมดุลนั้นได้เลือกใช้Buck – Boost Converter ส่งผลให้ใน การปรับสมดุลนั้นมีการสูญเสียพลังงานในการปรับสมดุลค่อนข้างสูงจากการที่ต้องใช้พลังงานส่วนหนึ่งใน การเพิ่มแรงดันในการปรับสมดุล

### 5.2 ประโยชน์ที่ได้รับ

1. ได้ศึกษาคุณสมบัติของเซลล์แบตเตอรี่ชนิดลิเทียมไอออน
2. ได้ศึกษาวิธีการปรับสมดุลต่างๆของเซลล์แบตเตอรี่ชนิดลิเทียมไอออน
3. ได้ศึกษาการทำงานและออกแบบระบบการทำงานด้วย Micro Controller
4. ได้ศึกษาวิธีการเขียนโปรแกรมด้วยภาษา C++

### 5.3 ข้อเสนอแนะ

จากปัญหาที่พบการการดำเนินการนั้นคือปัญหาเรื่องอุณหภูมิของอุปกรณ์ตรวจจับกระแสของ ระบบส่งผลให้เกิด off set ที่แปรผันตรามอุณหภูมิของไอซี จึงทำให้การตรวจวัดค่ากระแสไม่แม่นยำและ ตัว Micro Controller นั้นมีแรงดันระบบ 5 Volt ที่ค่อนข้างไม่เสถียรส่งผลให้แรงดันอ้างอิงสำหรับ Analog to Digital Convertor ของระบบไม่เสถียรไปด้วย ส่งผลให้การวัดค่าต่างๆที่เป็นค่า Analog นั้น ไม่แม่นยำเท่าที่ควร สามารถแก้ไขได้โดย ใช้อุปกรณ์ตรวจวัดที่มีคุณภาพสูงและใช้อุปกรณ์จ่ายไฟภายนอก ที่สามารถคงแรงดันได้ในกรณีที่มีโหลดเปลี่ยนไป ในส่วนของการปรับสมดุลเซลล์แบตเตอรี่นั้นมีการ สูญเสียพลังงานเยอะในการปรับสมดุล อาจแก้ไขได้โดยเปลี่ยนวิธีการเชื่อมต่อระหว่างอุปกรณ์นั้นให้เป็น การเชื่อต่อบน PCB แทน และ ใช้ Heat Sink ระบายความร้อนให้กับไอซีBoost Converter เพื่อลด ความต้อนทานภายในไอซีที่แปรผันตรงกับุณหภูมิของไอซี หรือ เปลี่ยนไปใช้Boost Converter ที่มี ประสิทธิภาพมากขึ้น

เอกสารอ้างอิง

[1] Author, Battery and Fuel Cells. [Online] ,
Available : https://tinyurl.com/4yb5j4hf [Accessed: 21 พฤศจิกายน 2564].
[2] วรวริศ กอปรสิริพัฒน์.2559, รู้จักแบตเตอรี่ ตอนที่ 4 แบตเตอรี่ลิเทียมไอออน. [Online] , Available : https://tinyurl.com/fe7xuvxs [Accessed: 3 21 พฤศจิกายน 2564].
[3] lady ada, Li-Ion (Lithium-Ion) and LiPoly (Lithium Polymer).[Online], Available : https://tinyurl.com/4syewvx2
[Accessed: 3 กรกฎาคม 2564 ].
[4] Author. 2005. แบตเตอรี่ลิเธียมไอออน (Lithium-Ion Battery). [Online],
Available : https://tinyurl.com/xattd3bb
[Accessed: 3 กรกฎาคม 2564 ].
[5] L. W. Yao, and J. A. Aziz, “Modeling of Lithium Ion Battery with Nonlinear Transfer Resistance,” IEEE Applied Power Electronics Colloquium (IAPEC), 2011, pp. 104-109
[6] M.Gholizadeh, and F.R.Salmasi, “Estimation of State-of-Charge, UnknownNonlinearities, and State-of-Health of a Lithium-Ion Battery Based on aComprehensive Unobservable Model,” IEEE Transactions on Industrial Electronics, vol. 61, no. 3, March 2014
[7] Journal of Power Sources Battery equalization active methods, 15 January 2014, Pages 934-949
[8] Aswinth Raj.2019, Cell Balancing Techniques and How to Use Them. [Online],Available: https://tinyurl.com/43chr6s2 [Accessed: 3 กรกฎาคม 2564 ].
[9] MIT Electric Vehicle Team.2008, . A Guide to Understanding Battery Specifications.[Online],
Available: http://web.mit.edu/evt/summary_battery_specifications.pdf [Accessed: 3 กรกฎาคม 2564 ].

[10] Author.2559 . เครื่องทดสอบและวิเคราะห์แบตเตอรี่ชนิด Deep Cycle.[Online], Available: https://tinyurl.com/wdy6mcun
[11] Saksirin Chinnaket.2562, Active Cell Balancing for efficient Management of Li-ion battery pack,
[12] Tuemaster admin.2021, กฎของโอห์ม (Ohm’s Law)-ฟิสิกส์.[Online]
Available : https://tinyurl.com/rmaky2sr [Accessed: 3 กรกฎาคม 2564 ].
[13] Journal of Power Sources Battery equalization active methods, 3 June 2014, Pages 603-609
[14] Author.2021, Battery Pack Cell Voltage Difference and Solution Part 1 | Battery Monday.[Online]
Available : https://tinyurl.com/uknwz52s [Accessed: 3 กรกฎาคม 2564 ].
[15] รายงานฉบับสมบูรณ์ การวิจัยแบตเตอรี่ต้นแบบสำหรับรถยนต์นั่งที่ใช้พลังงานไฟฟ้า, 29 กันยายน 2560, Pages 182-187

ภาคผนวก ก.

แสดงรูปลักษณ์ภายของของระบบการจัดการแบตเตอรี่ชนิดลิเทียมไอออนขนาด 18650 จำนวน 4 เซลล์
ระบบจัดการแบตเตอรี่ชนิดลิเทียมไอออนจำนวน 4 เซลล์มีอุปกรณ์หลักๆที่ใช้ในการทำงานคือ Micro controller , Step-down converter , Boost converter , Discharger และ Relay ดังภาพที่ ก.1 และมีการทำงานเบื้องหน้าในส่วนของการแสดงผล การควบคุม และ ช่องแบตเตอรี่ โดยใช้MOSFET LCD Display , Control Switch , Temp sensor และ Pulldown resistor ดังภาพที่ ก.2

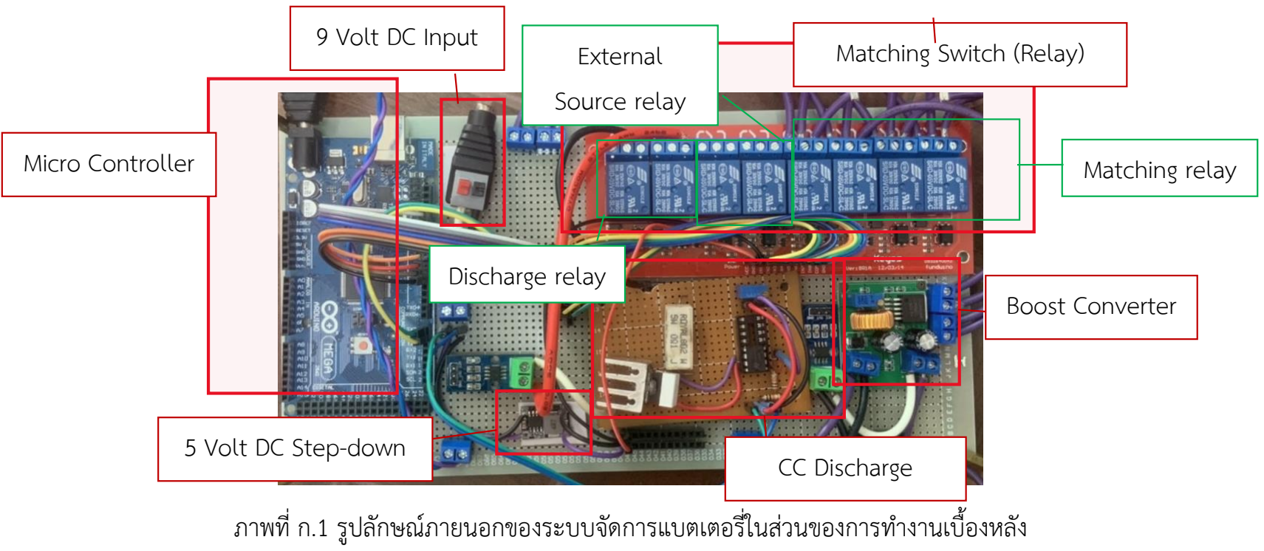
[picture p54: figure]
ภาพที่ ก.1 รูปลักษณ์ภายนอกของระบบจัดการแบตเตอรี่ในส่วนของการทำงานเบื้องหลัง; Micro Controller; 9 Volt DC Input; Matching Switch (Relay); Boost Converter; CC Discharge; 5 Volt DC Step-down; Discharge relay; External Source relay; Matching relay
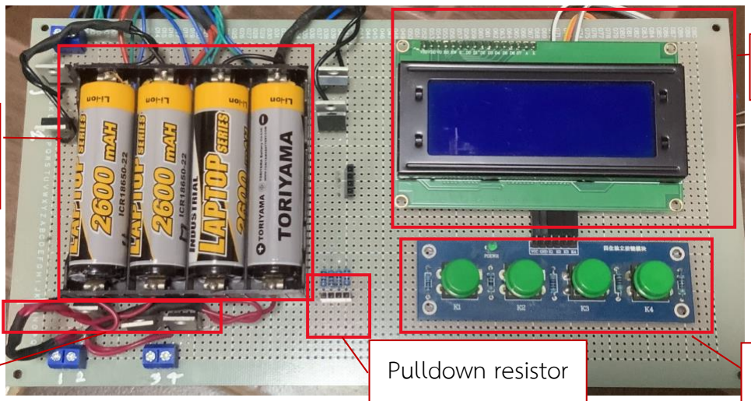
[picture p55: figure]

ภาพที่ ก.2 รูปลักษณ์ภายนอกของระบบจัดการแบตเตอรี่ในส่วนของการทำงานเบื้องหน้า

Temp sensor
and battery
Active MOSFET | Pulldown resistor | Control Switch

LCD Display

ภาคผนวก ข.

ซอสโค้ดในการเริ่มต้นระบบ

บรรทัดที่ 1-2 Include Library บรรทัดที่ 3 Initiate LCD Display

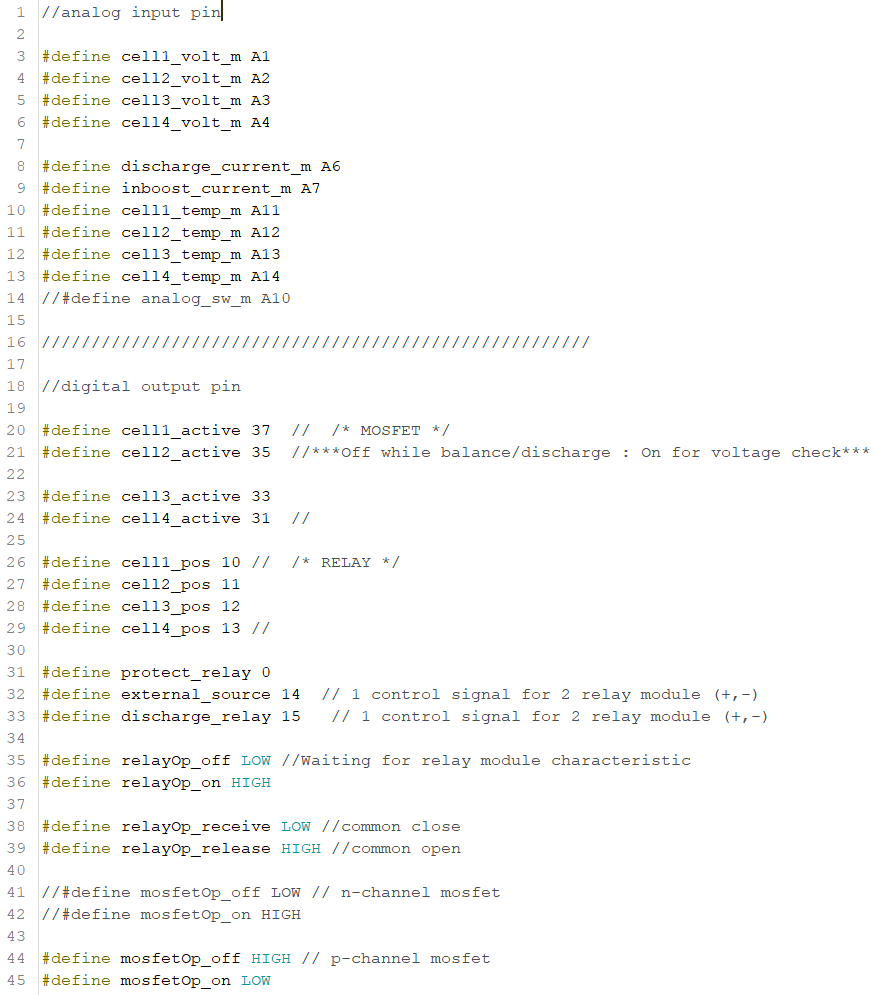
[picture p56: figure]

บรรทัดที่ 1-45 Define pins

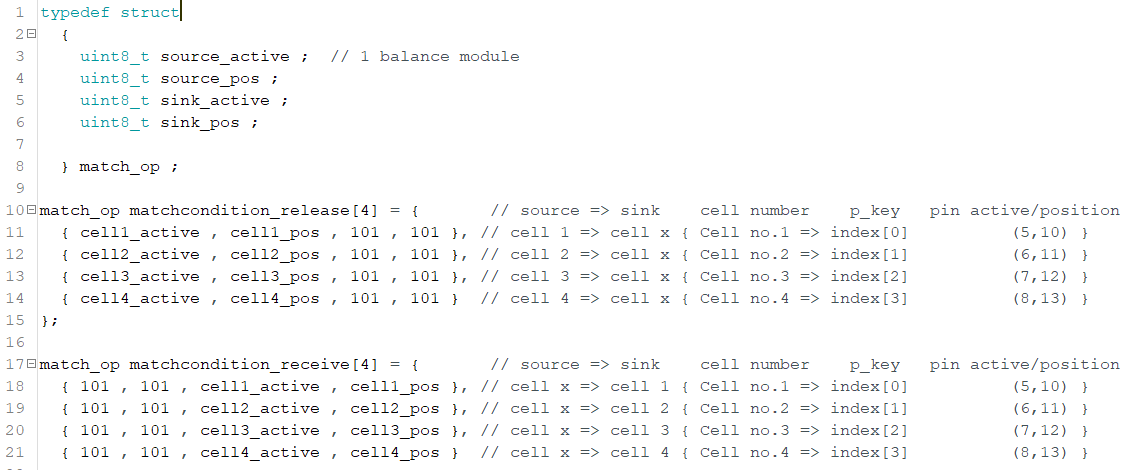
[picture p57: figure]

บรรทัดที่ 1-8 Define pattern structure บรรทัดที่ 10-21 Condition Structure

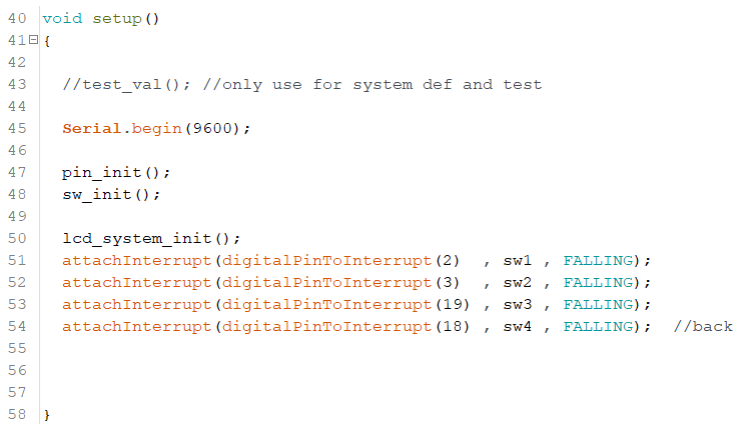
[picture p58: figure]

บรรทัดที่ 40-50 Initiate System บรรทัดที่ 51-54 Assign Interrupt

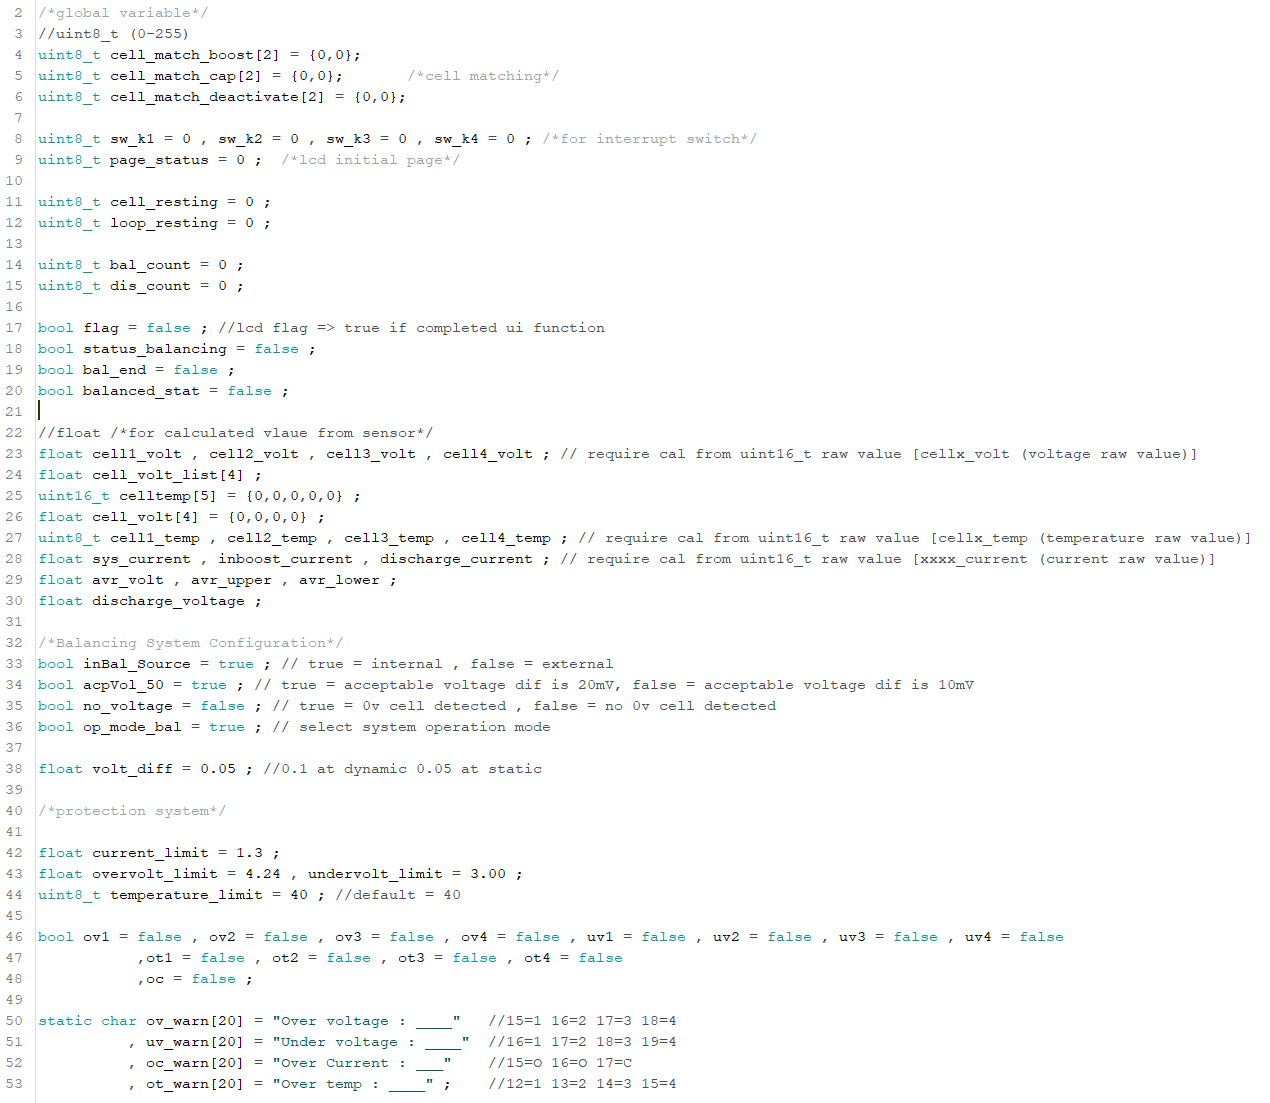
[picture p59: figure]

บรรทัดที่ 2-53 Assign Global Variable

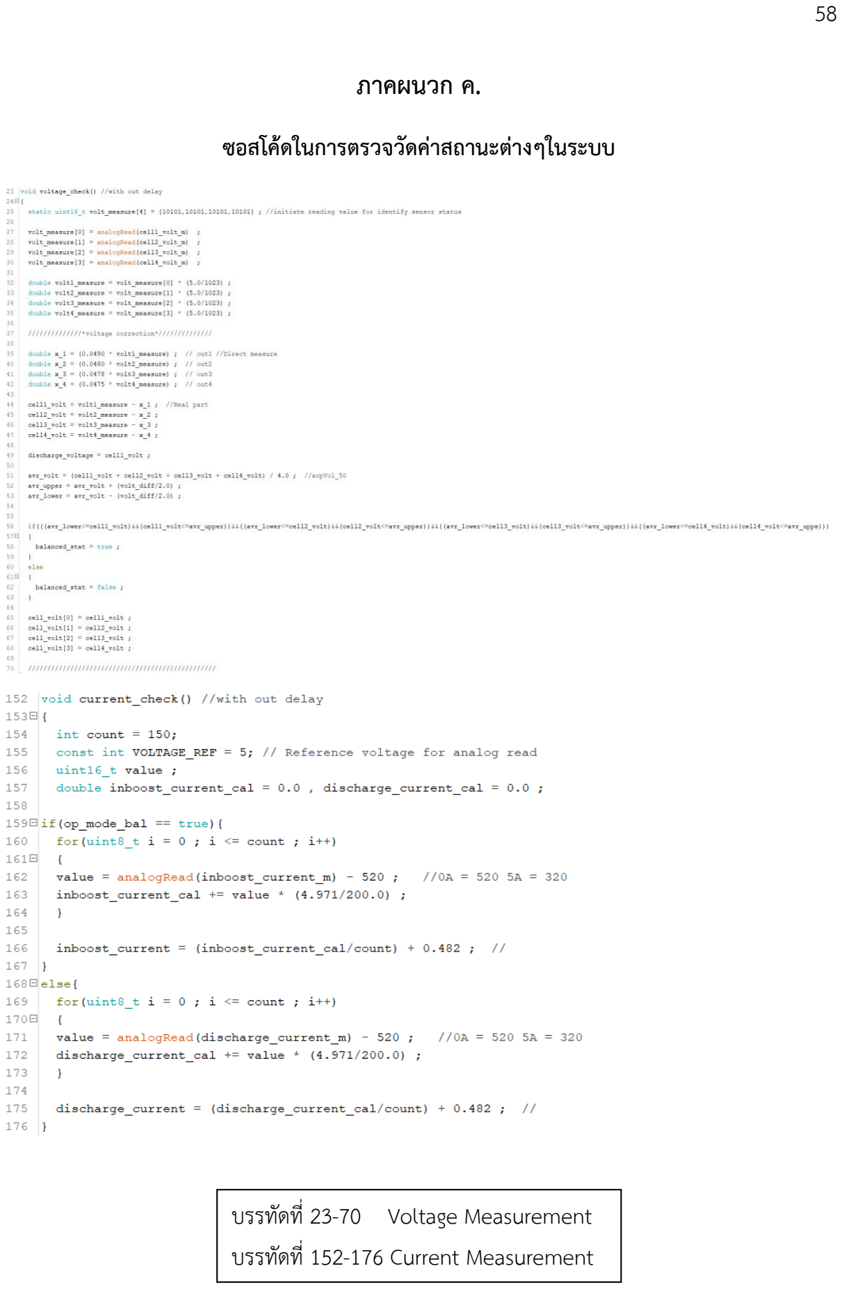
[picture p60: page 74]

ภาคผนวก ค.

ซอสโค้ดในการตรวจวัดค่าสถานะต่างๆในระบบ

บรรทัดที่ 23-70 Voltage Measurement บรรทัดที่ 152-176 Current Measurement

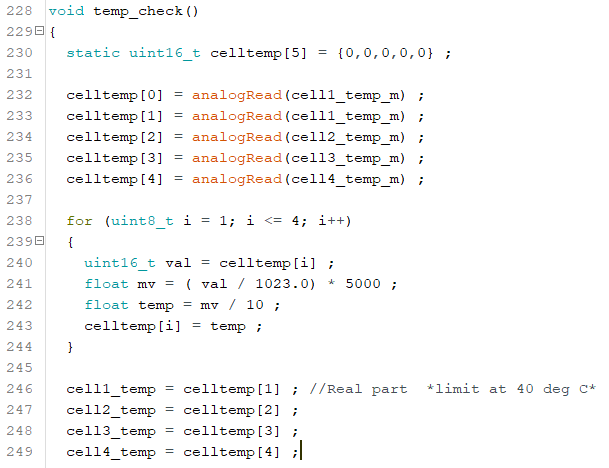
[picture p61: figure]

บรรทัดที่ 228-249 Temperature Measurement

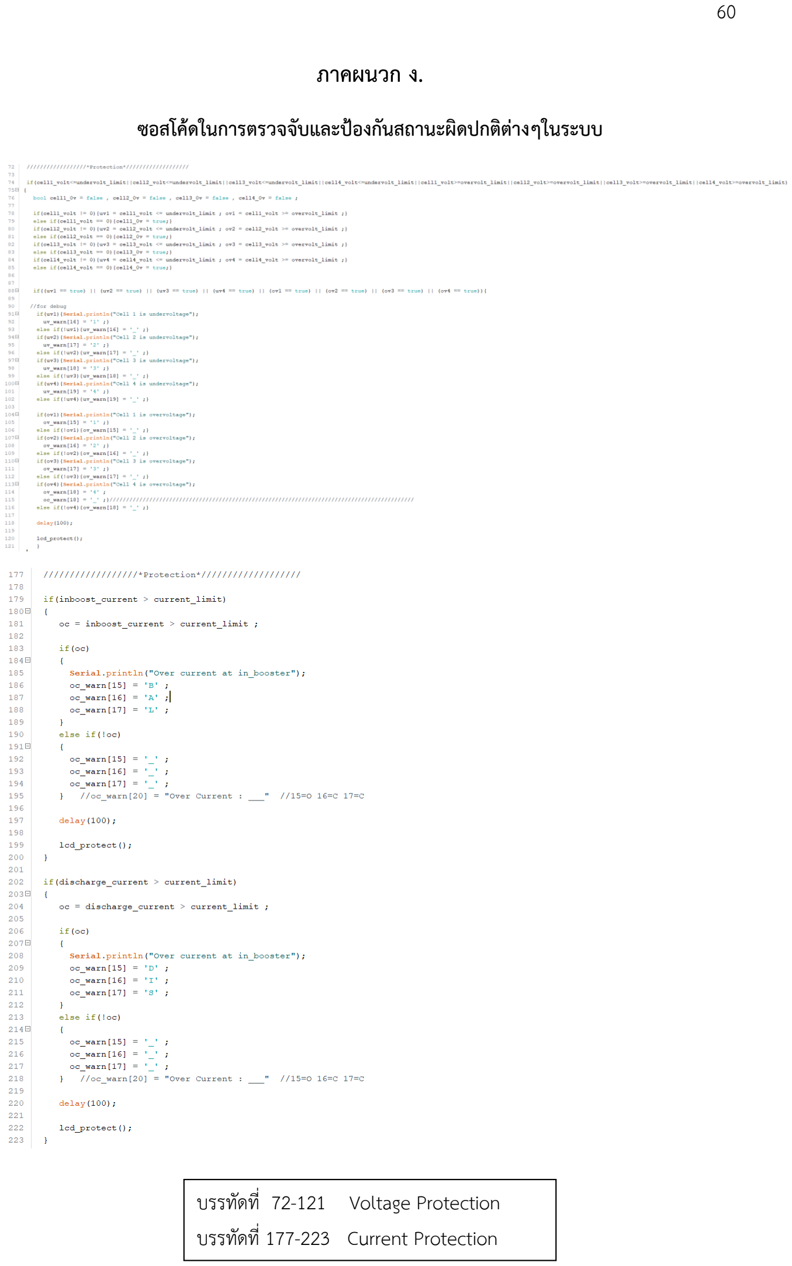
[picture p62: page 76]

ภาคผนวก ง.

ซอสโค้ดในการตรวจจับและป้องกันสถานะผิดปกติต่างๆในระบบ

บรรทัดที่ 72-121 Voltage Protection บรรทัดที่ 177-223 Current Protection

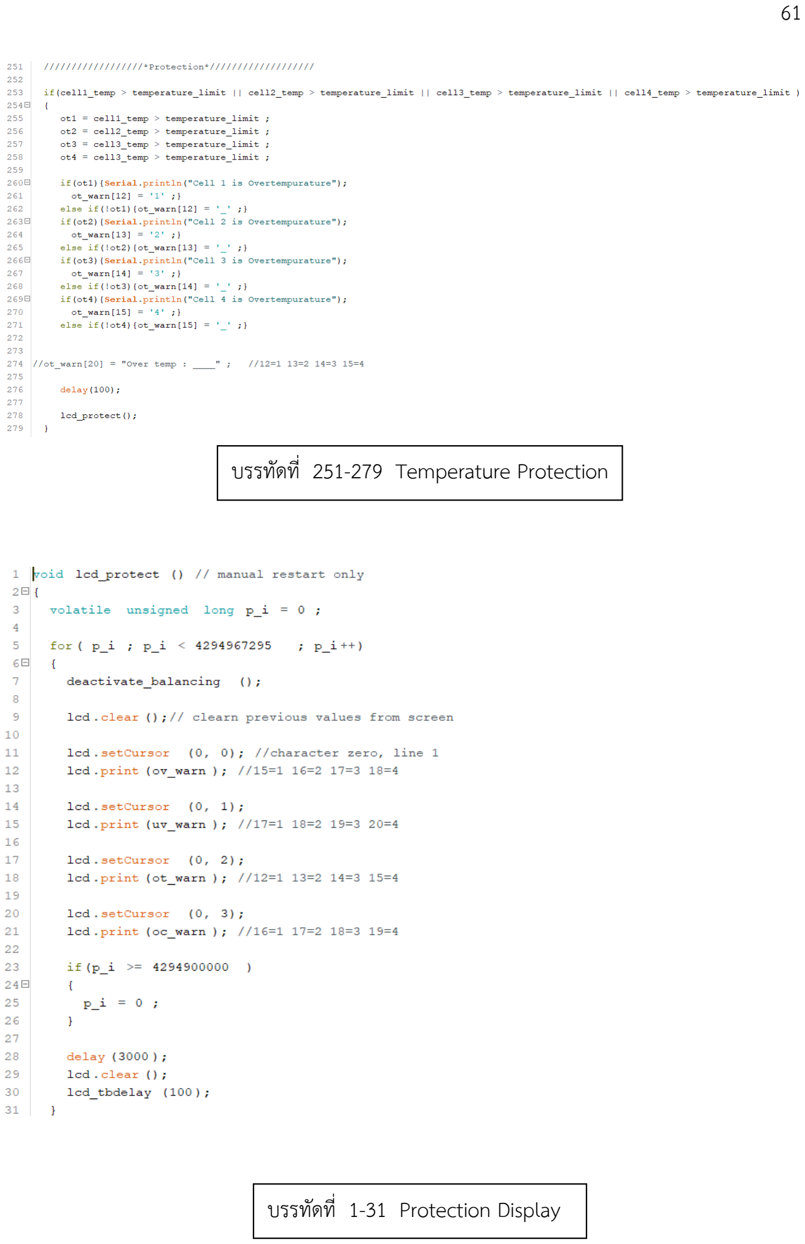
[picture p63: page 77]

บรรทัดที่ 251-279 Temperature Protection

บรรทัดที่ 1-31 Protection Display

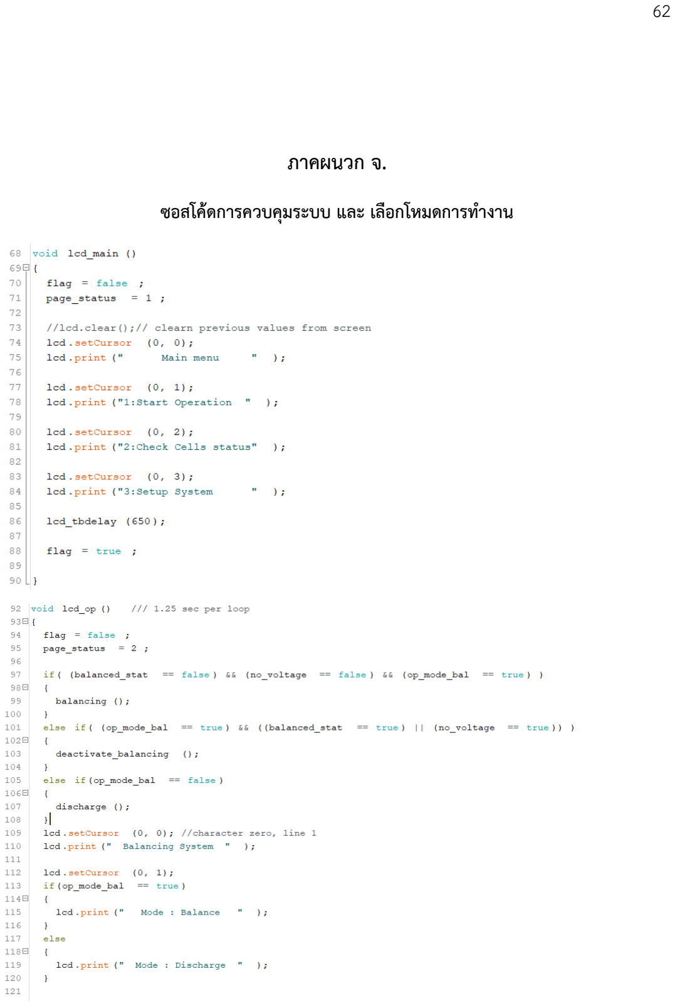
[picture p64: page 78]

ภาคผนวก จ.

ซอสโค้ดการควบคุมระบบ และ เลือกโหมดการทำงาน

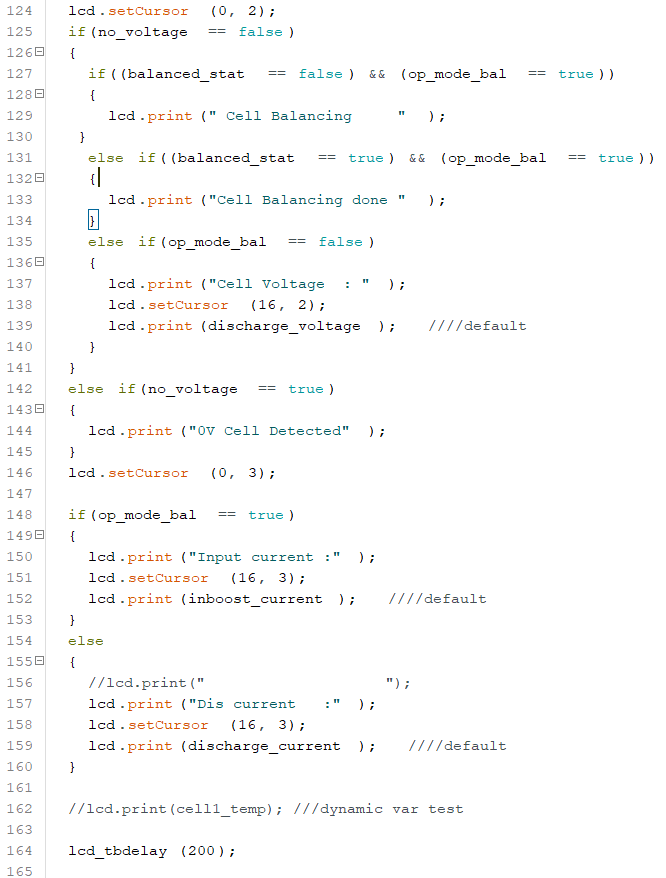
[picture p65: figure]
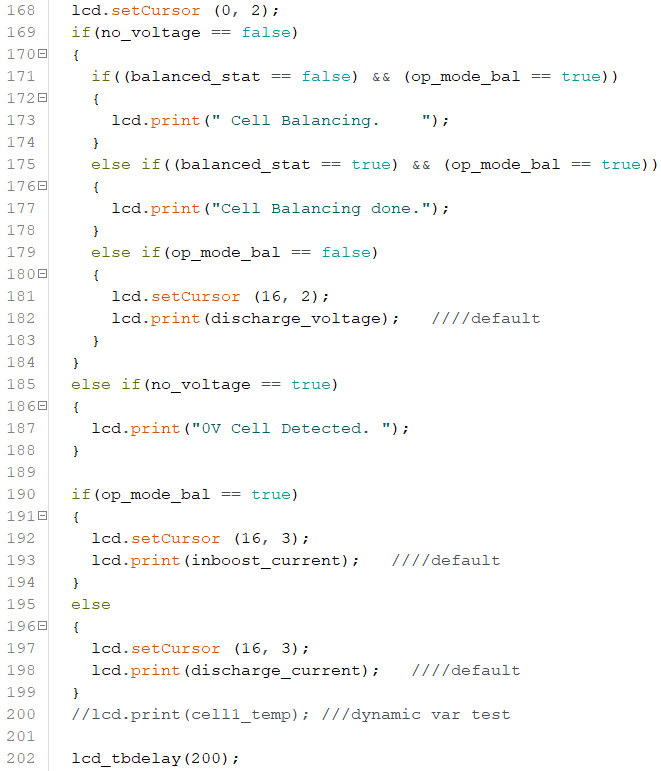
[picture p66: figure]
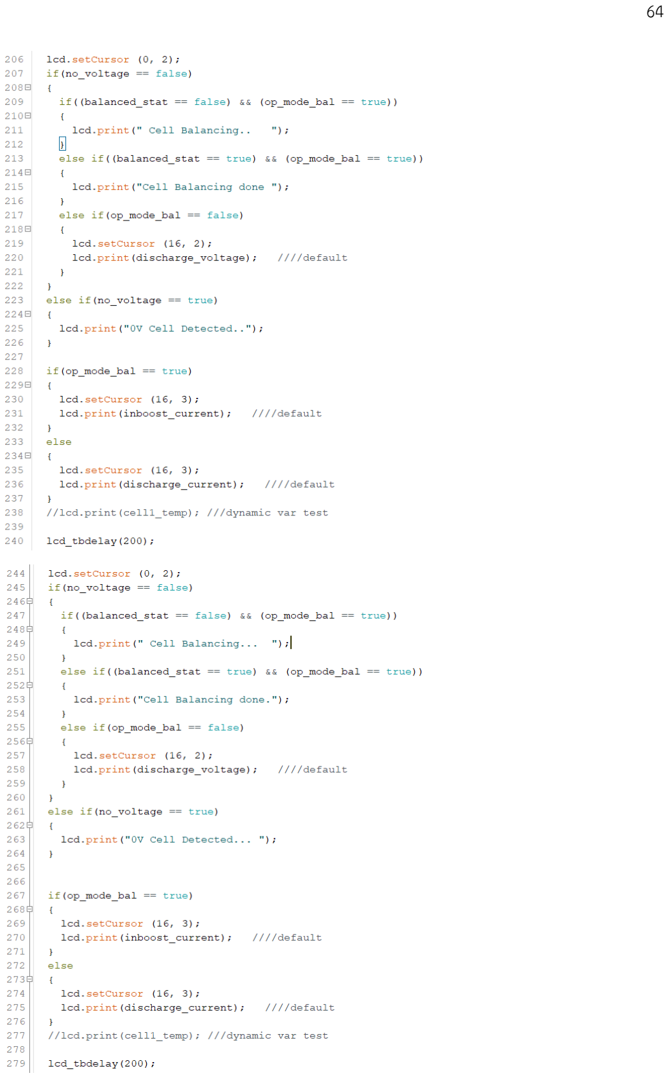
[picture p67: page 80]

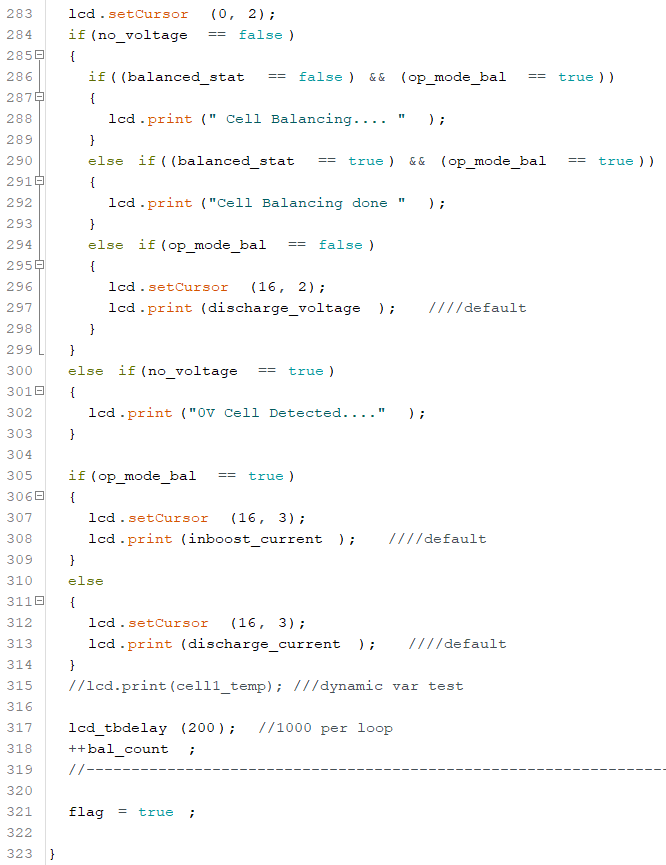
[picture p68: figure]

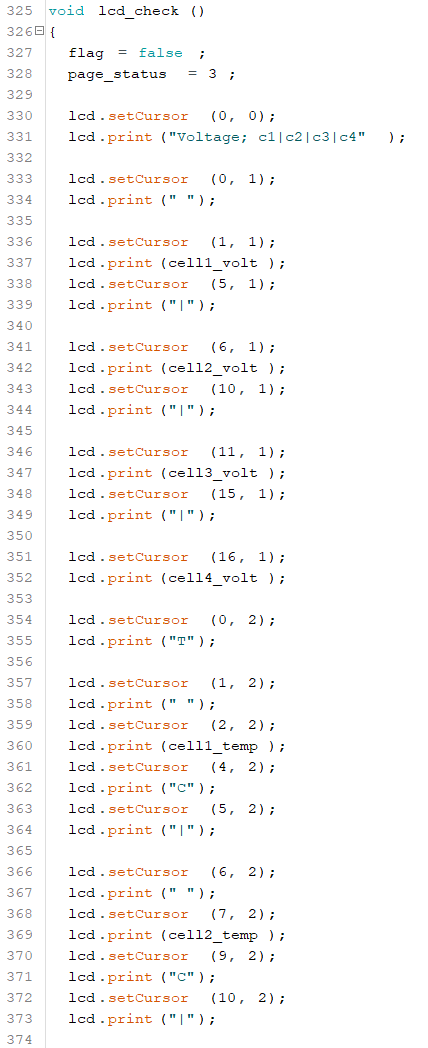
[picture p69: figure]
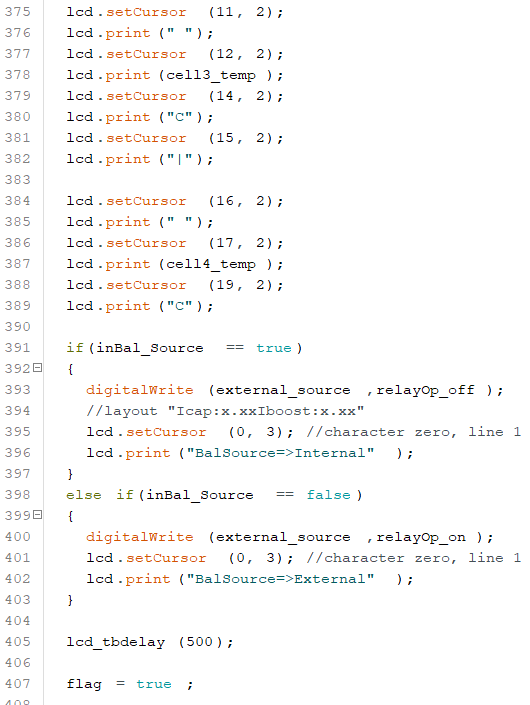
[picture p70: figure]

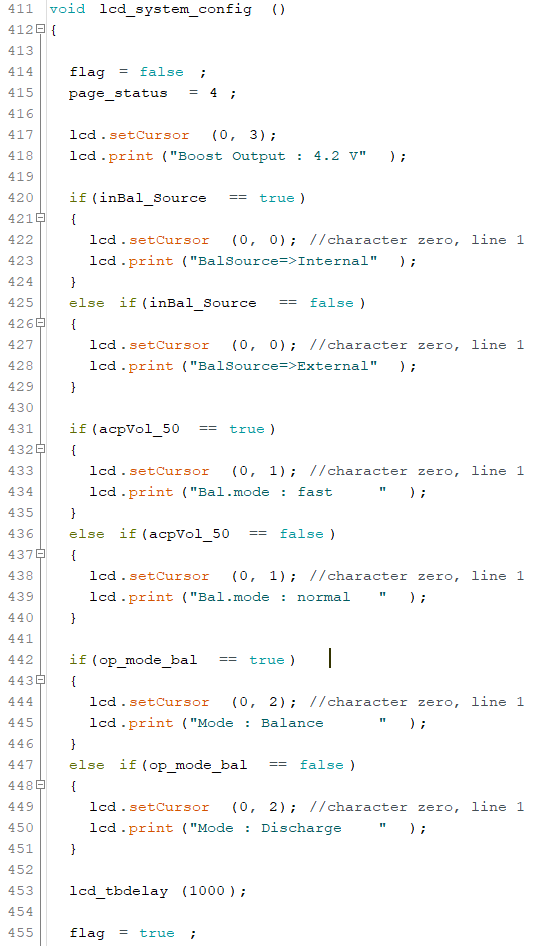
[picture p71: figure]
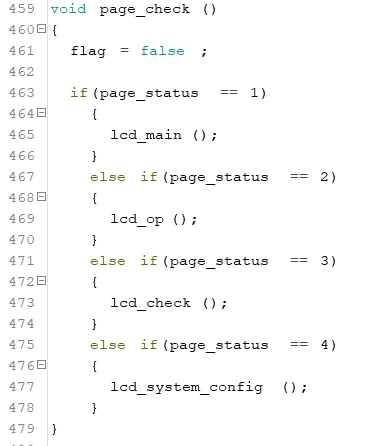
[picture p72: figure]

บรรทัดที่ 68-90 Main Menu
บรรทัดที่ 92-323 Operation Menu บรรทัดที่ 325-407 Status Monitor Menu บรรทัดที่ 411-455 Configuration Menu บรรทัดที่ 459-479 Page Check

ภาคผนวก ฉ.

ซอสโค้ดในการจับคู่เซลล์แบตเตอรี่และปรับสมดุล

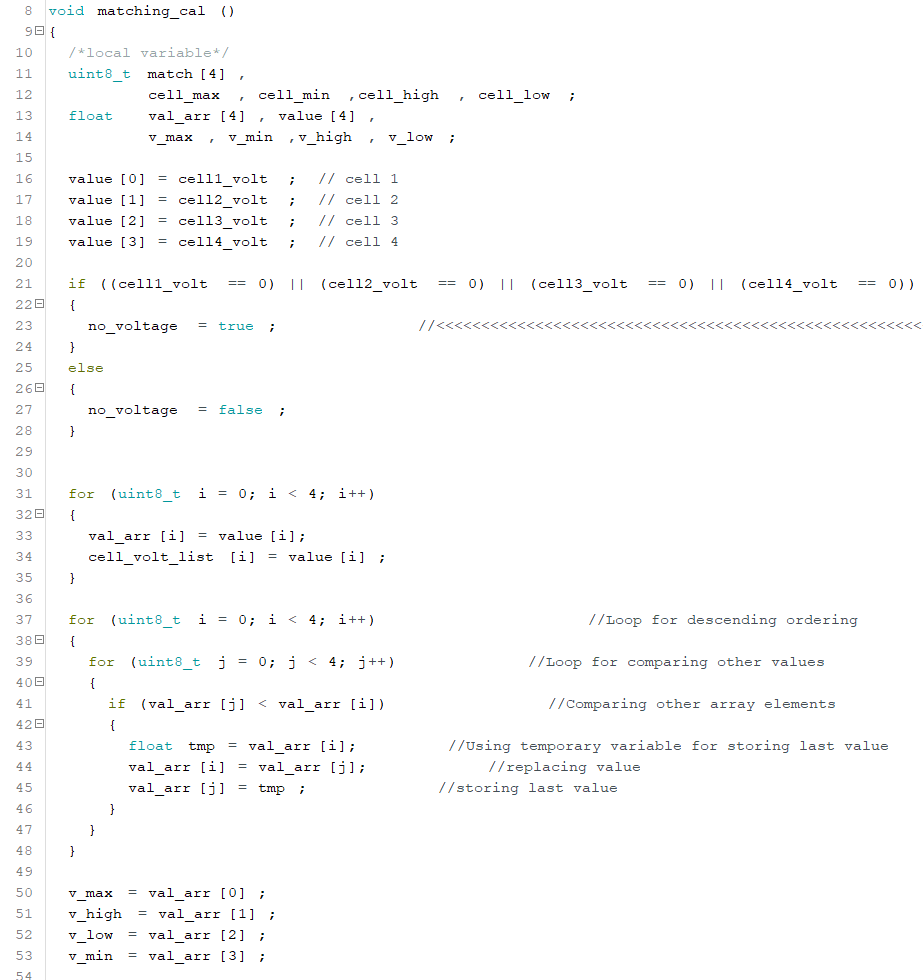
[picture p73: figure]
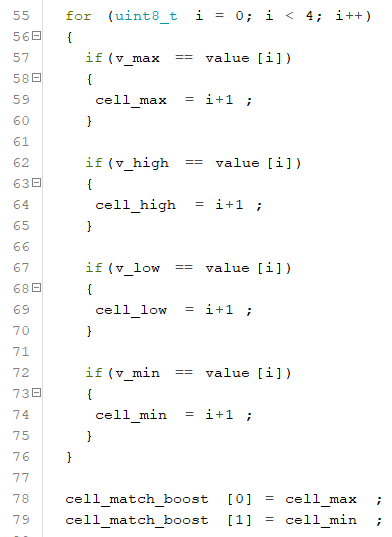
[picture p74: figure]

บรรทัดที่ 8-79 Matching Calculation

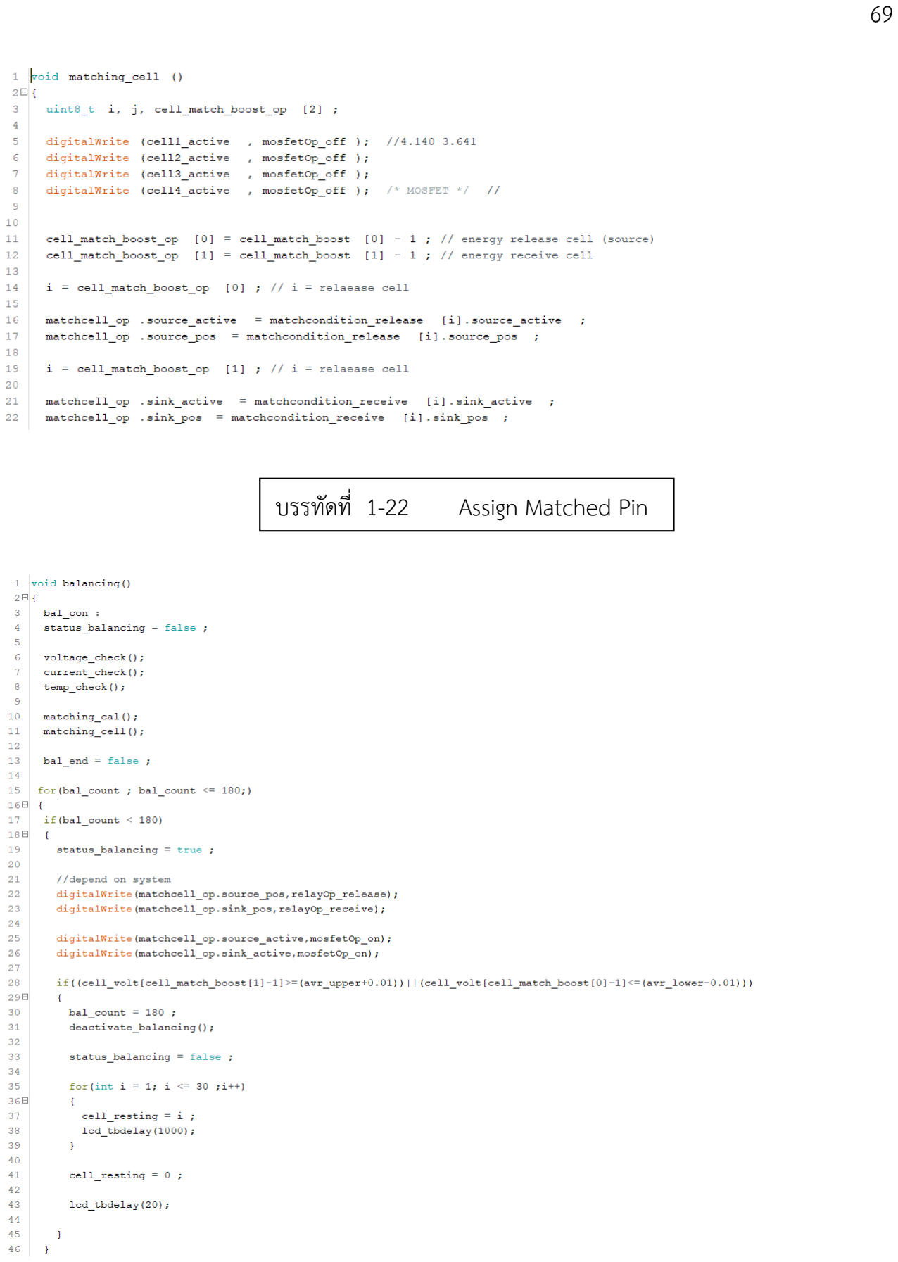
[picture p75: page 85]

บรรทัดที่ 1-22 Assign Matched Pin

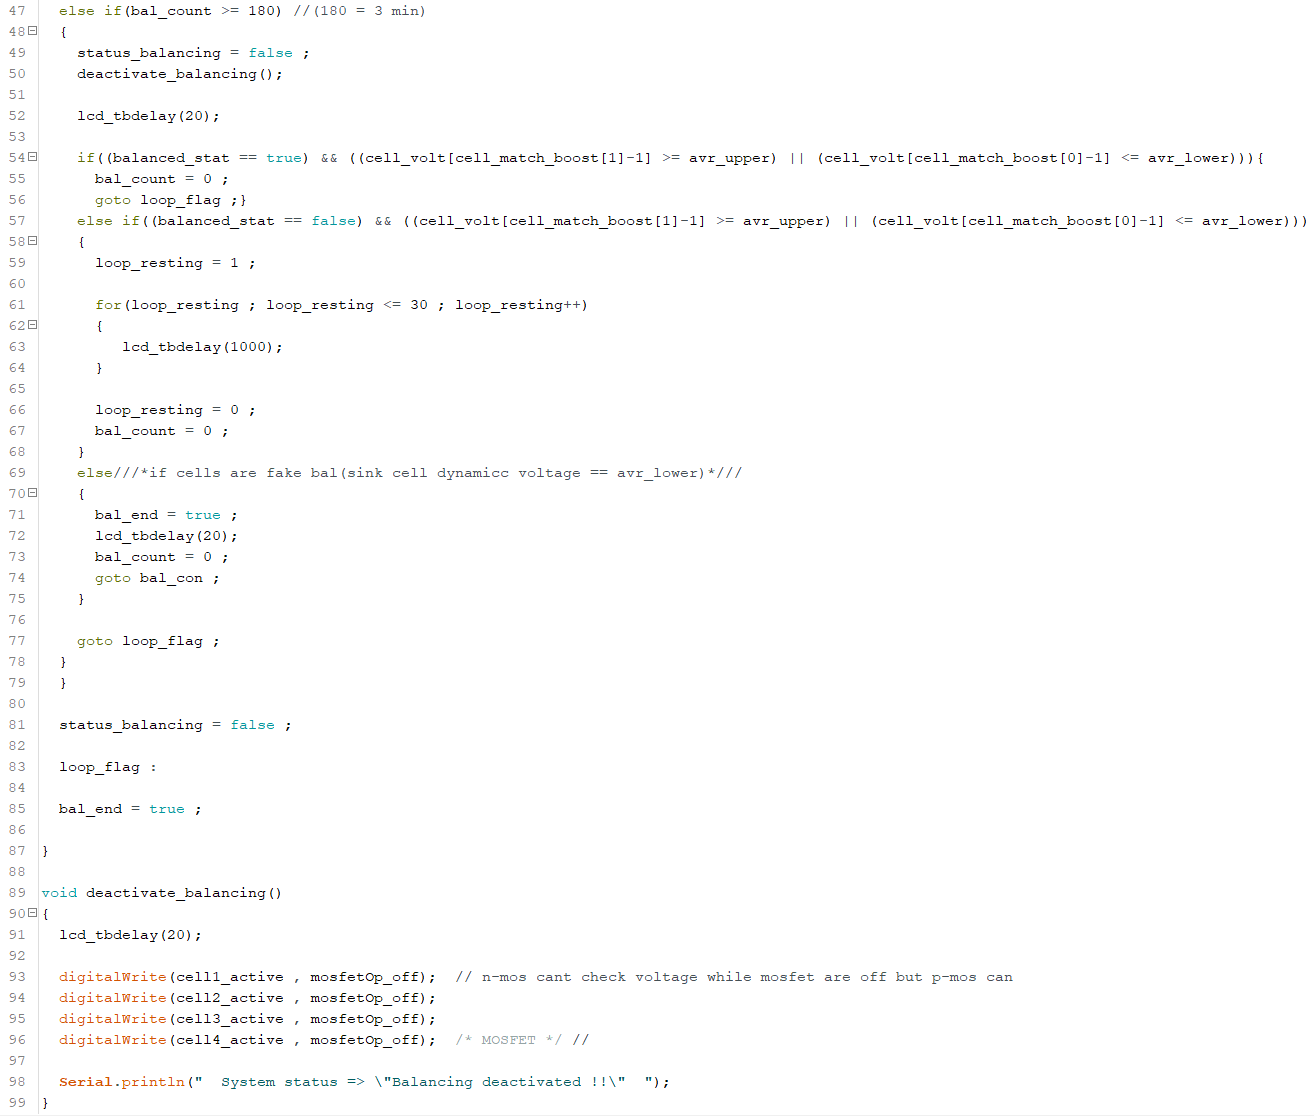
[picture p76: figure]

บรรทัดที่ 1-87 Balancing
บรรทัดที่ 89-98 Deactivate Balancing

ภาคผนวก ช.

ซอสโค้ดในการดึงกระแสเซลล์แบตเตอรี่

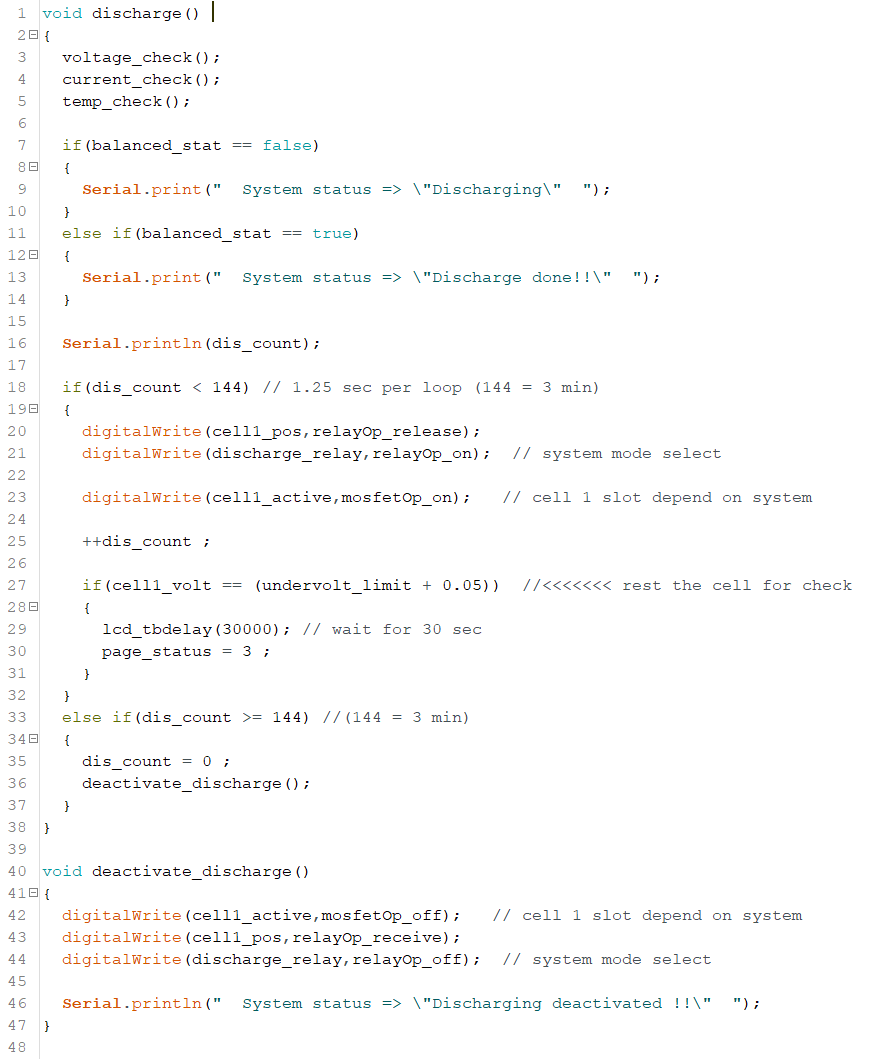
[picture p77: figure]

บรรทัดที่ 1-38 Discharge
บรรทัดที่ 40-46 Deactivate Discharge

ภาคผนวก ญ.

ซอสโค้ดในการขัดจังหวะของสวิตช์และการหน่วงเวลา

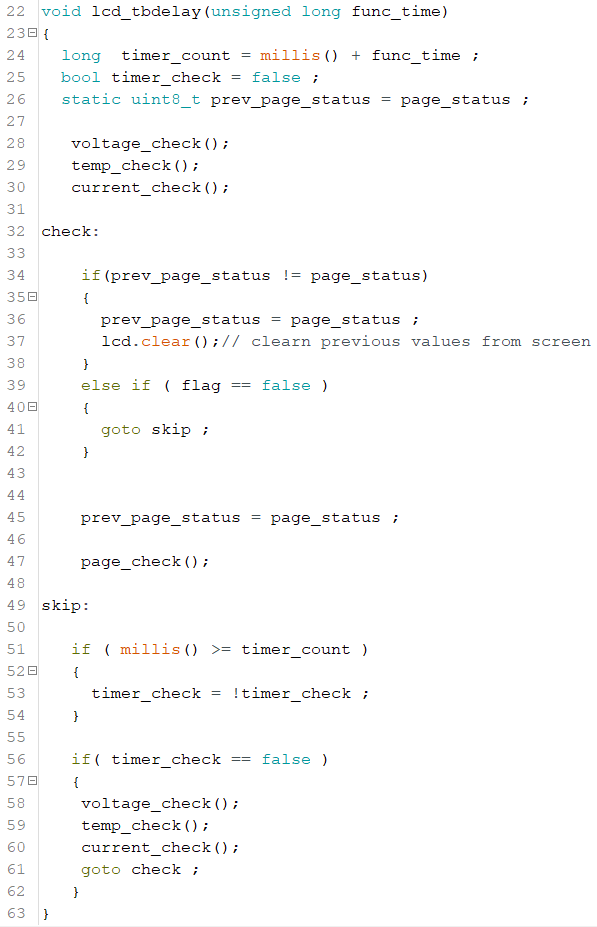
[picture p78: figure]

บรรทัดที่ 2-63 | Delay function

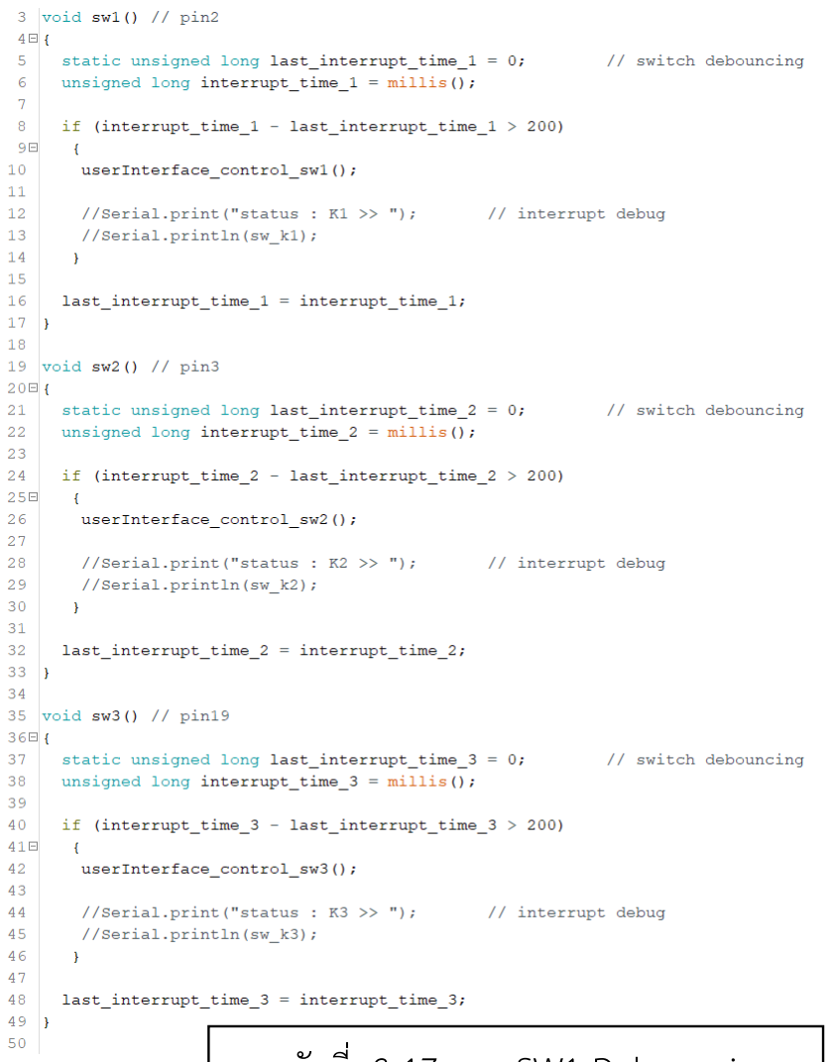
[picture p79: figure]

บรรทัดที่ 3-17 | SW1 Debouncing
บรรทัดที่ 19-30 SW2 Debouncing บรรทัดที่ 35-49 SW3 Debouncing

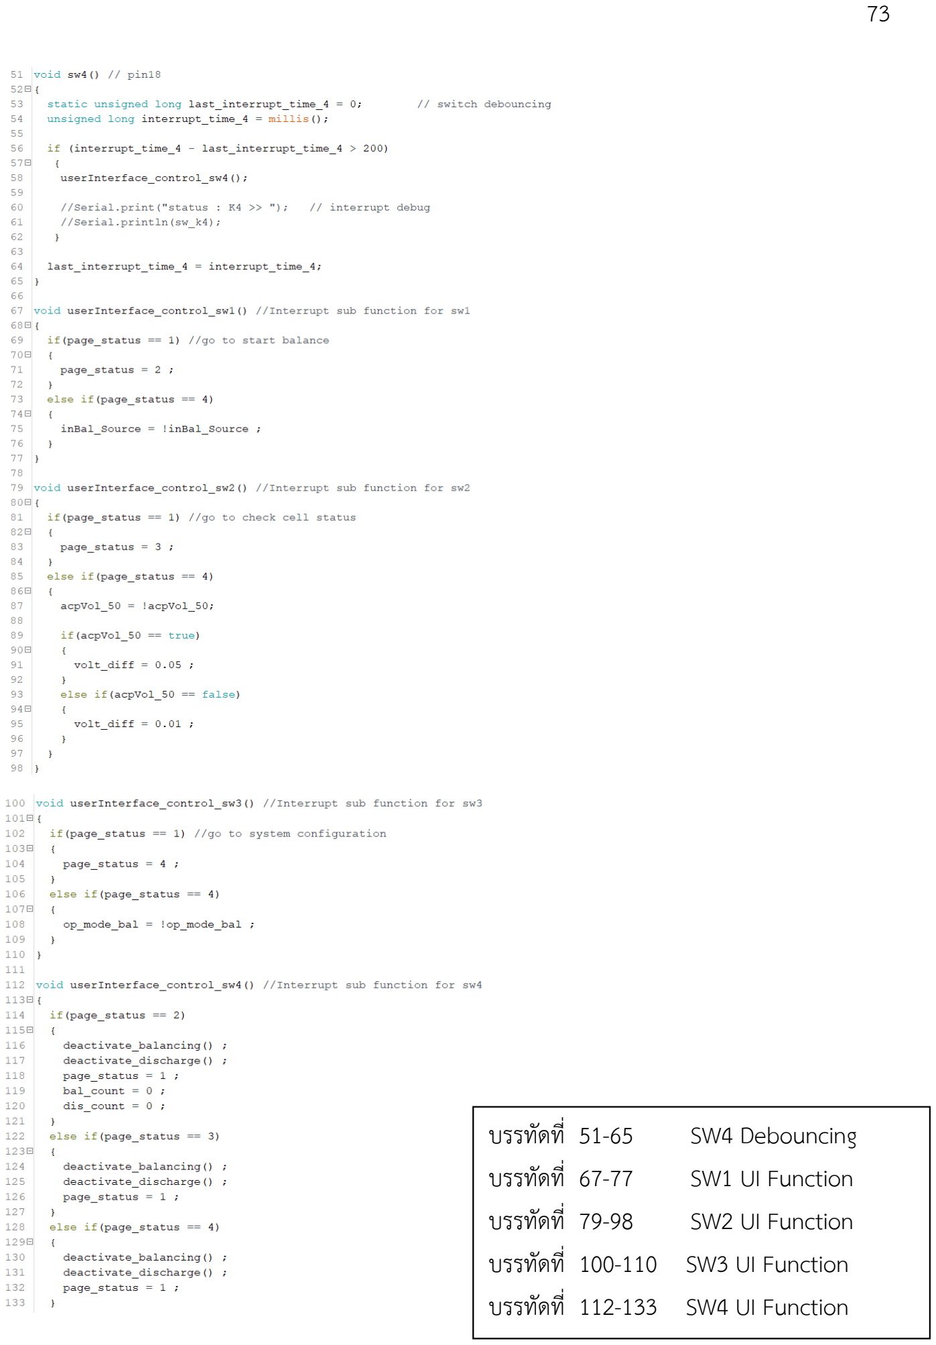
[picture p80: page 89]

บรรทัดที่ 51-65 | SW4 Debouncing
บรรทัดที่ 67-77 | SW1 UI Function
บรรทัดที่ 79-98 | SW2 UI Function
บรรทัดที่ 100-110 SW3 UI Function บรรทัดที่ 112-133 SW4 UI Function

ประวัติผู้จัดทำโครงงาน

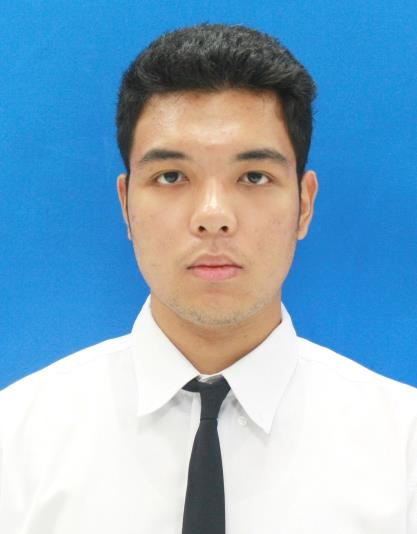
[picture p81: figure]

ชื่อ-สกุล | นายเนติธร ปรีชาพัฒนานนท์
วัน เดือน ปีเกิด | 12 มกราคม พ.ศ. 2542

ประวัติการศึกษา

ระดับมัธยมศึกษา | ระดับมัธยมศึกษาตอนปลาย พ.ศ. 2559 โรงเรียเตรียมอุดมศึกษาน้อมเกล้า
ระดับอุดมศึกษา | คณะวิศวกรรมศาสตร์สาขาวิศวกรรมไฟฟ้า พ.ศ. 2563 สถาบันเทคโนโลยีไทย-ญี่ปุ่น
ทุนการศึกษา | -ไม่มี-
ประวัติการฝึกอบรม | -ไม่มี-
ผลงานที่ได้รับตีพิมพ์ | -ไม่มี-
