Netithorn-P/Li-ion-Battery-cells-management-system/a34_Testval.ino

void test_val()
{
//  cell_match_boost[0] = 0 ;  //matching cell for balance             ** not avalible if matching function is working **  
//  cell_match_boost[1] = 0 ;
//  cell_match_cap[0] = 0 ;  
//  cell_match_cap[1] = 0; 
//
//  cell1_volt = 1.45;  // cell voltage //return value to global variable (static val test)
//  cell2_volt = 0.85;
//  cell3_volt = 1.58;
//  cell4_volt = 0.24;
//
//  cell1_temp = 0 ;  // cell temperature
//  cell2_temp = 0 ;
//  cell3_temp = 0 ;
//  cell4_temp = 0 ; 
//  
//  sys_current = 0 ;  // balancing system current
//  inboost_current = 0 ;
//
//
//  //system configuration
//  
//  inBal_Source = true ; // true = internal , false = external
//  acpVol_50 = true ; // true = acceptable voltage dif is 20mV, false = acceptable voltage dif is 10mV
//  no_voltage = false ; // true = 0v cell detected , false = no 0v cell detected
}
